AaronDoubert/quadcopter-pid-boards/README.md

# Quadcopter Flight Controller – Analog PID Boards

Analog PID flight controller for a 5" quadcopter: roll, pitch and yaw loops built from op-amps and
trimpots, fed by an MPU-6050 through a small ATtiny/DAC "shim", driving a 4in1 ESC. Designed in KiCad 10.

## PID_Board rev B: compact through-hole board for the 5" frame (latest)

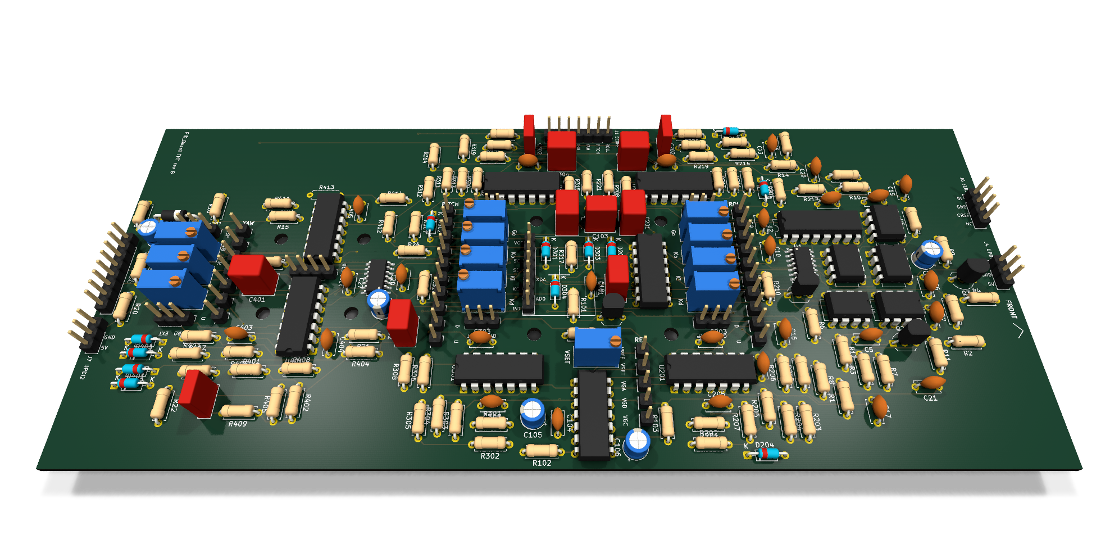
[picture p1: PID_Board/pcb_3d_render.png]
PID_Board rev B, 3D view


**90 x 210 mm, 4-layer, all through-hole except the two SOIC ATtinys.** It mounts straight onto the frame.

| | |
|---|---|
| Mounting | 30.5 x 30.5 stack holes + 20 x 20 ESC stack holes (M3); copper-free rings for the standoffs |
| ESC | 4in1 sits underneath the rear section on the 20x20 holes; harness to J5 |
| IMU | GY-521 on a header, MPU-6050 directly over the frame CG |
| Receiver | ELRS 2.4 GHz (for example RadioMaster RP1/RP2), CRSF on J6 at the front edge |
| Power | VBAT (2S–4S) from the ESC harness → 1N5817 → mini fixed-5 V buck module on U10 (3 wires; see MOUNTING.md) |
| Tuning | One labelled panel per axis: test points, LOOP/GYRO jumpers, Go/Kp/Ki/Kd trimpots, all prop-clear |
| Layers | Top/bottom signals, In1 GND plane, In2 +5 V plane |

<table>
<tr>
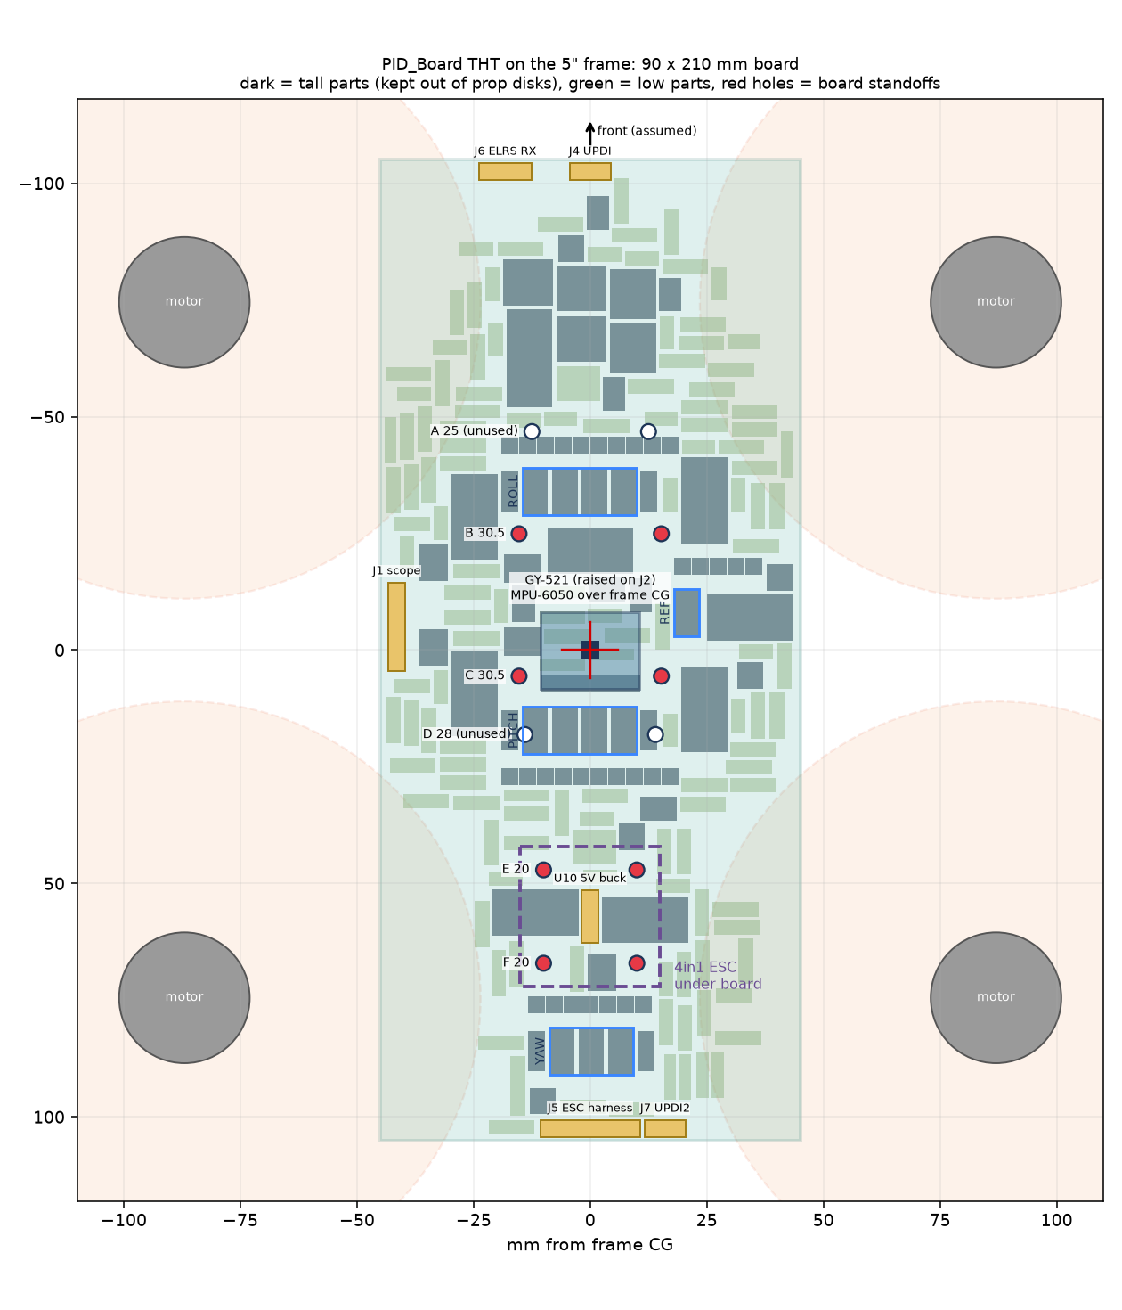
[picture p2: PID_Board/mounting_plan.png]
Board on the frame with 5-inch prop disks
<td></td>
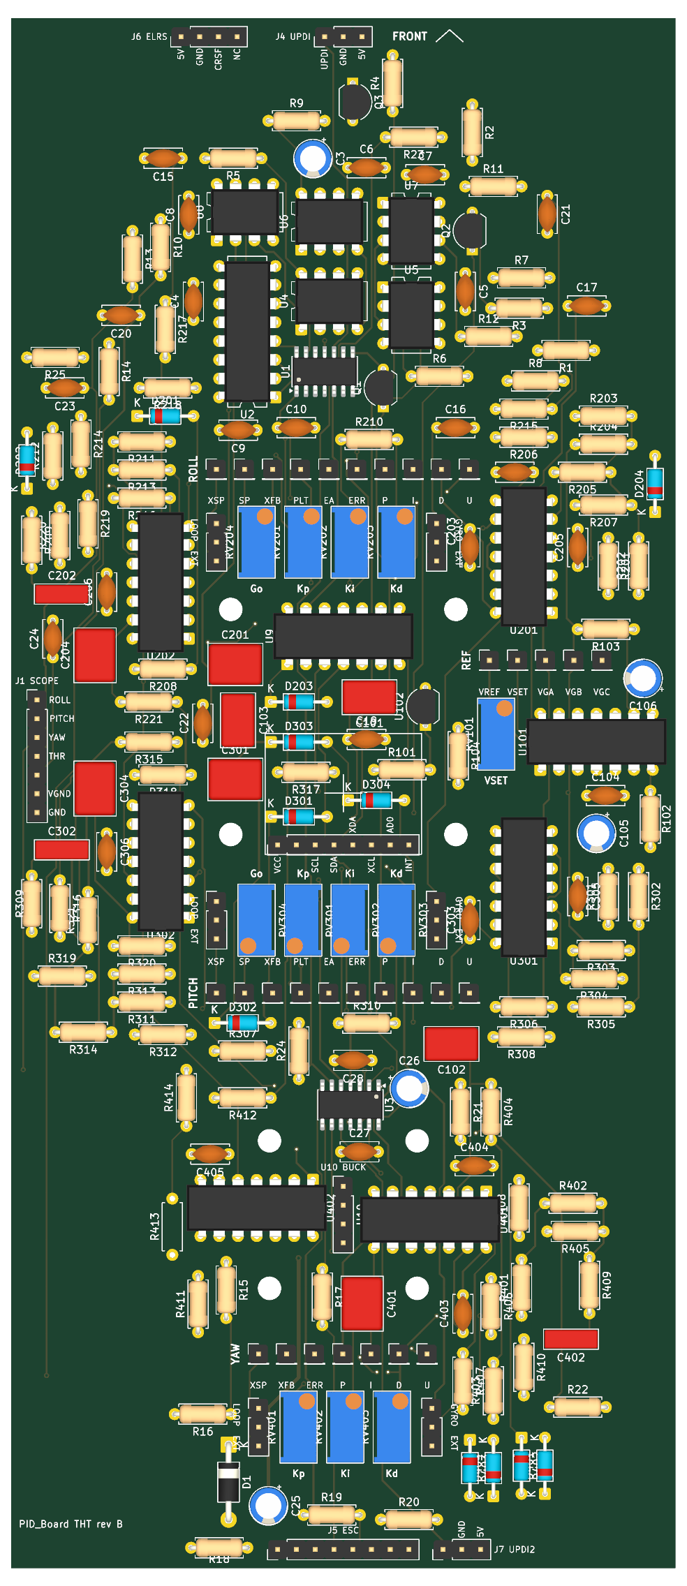
[picture p3: PID_Board/pcb_top_render.png]
Top render
<td></td>
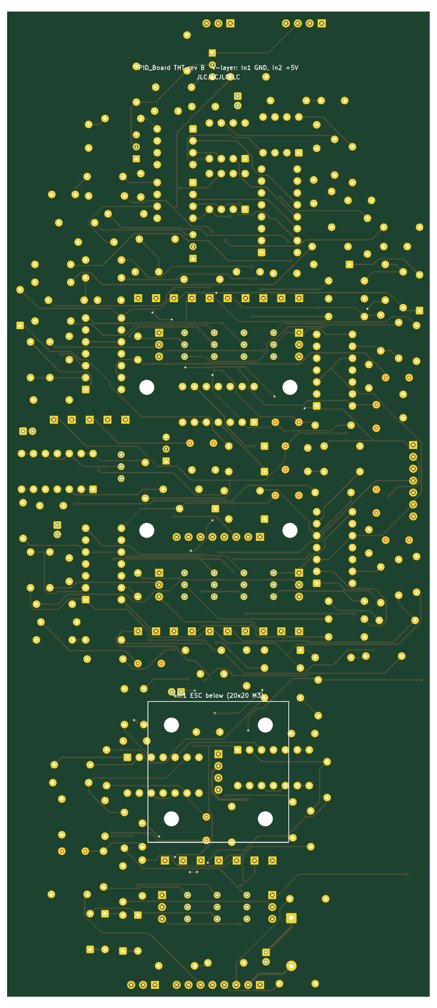
[picture p4: PID_Board/pcb_bottom_render.png]
Bottom render
<td></td>
</tr>
<tr><td>Board on the frame (dashed: 5" prop disks)</td><td>Top</td><td>Bottom</td></tr>
</table>

**Order / build files**
- **Gerbers (upload this zip to JLCPCB or PCBWay as a 4-layer board):** [`PID_Board_gerbers_drill.zip`](PID_Board/fab/JLC_PCBWay_THT/PID_Board_gerbers_drill.zip)
- **BOM and pick-and-place:** [`PID_Board/fab/JLC_PCBWay_THT/`](PID_Board/fab/JLC_PCBWay_THT/) (grouped BOM, CPL)
- **3D model:** [`PID_Board/cad/`](PID_Board/cad/) (STEP).
- [`PID_Board/MOUNTING.md`](PID_Board/MOUNTING.md): stack order, standoffs, where each module goes, what to measure before ordering.
- [`PID_Board/KNOWN_ISSUES.md`](PID_Board/KNOWN_ISSUES.md): things to check before first power-up.

## PID_Board_SMT: SMT, digital-pot version

100 x 100 mm 2-layer, assembly-ready at JLCPCB (LCSC part numbers), digital pots instead of trimpots.

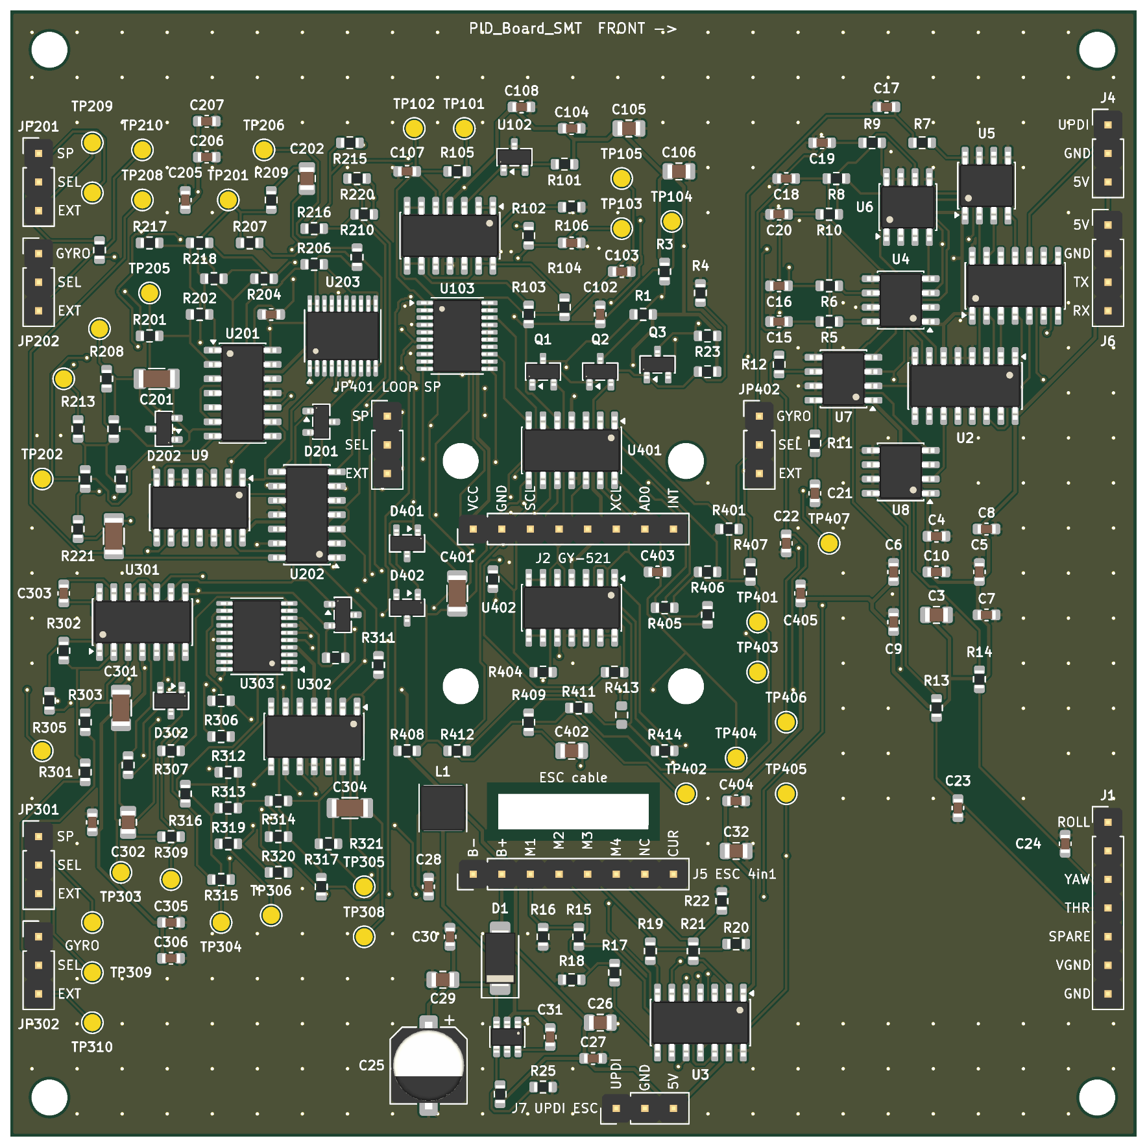
[picture p5: PID_Board_SMT/pcb_top_render.png]
SMT top
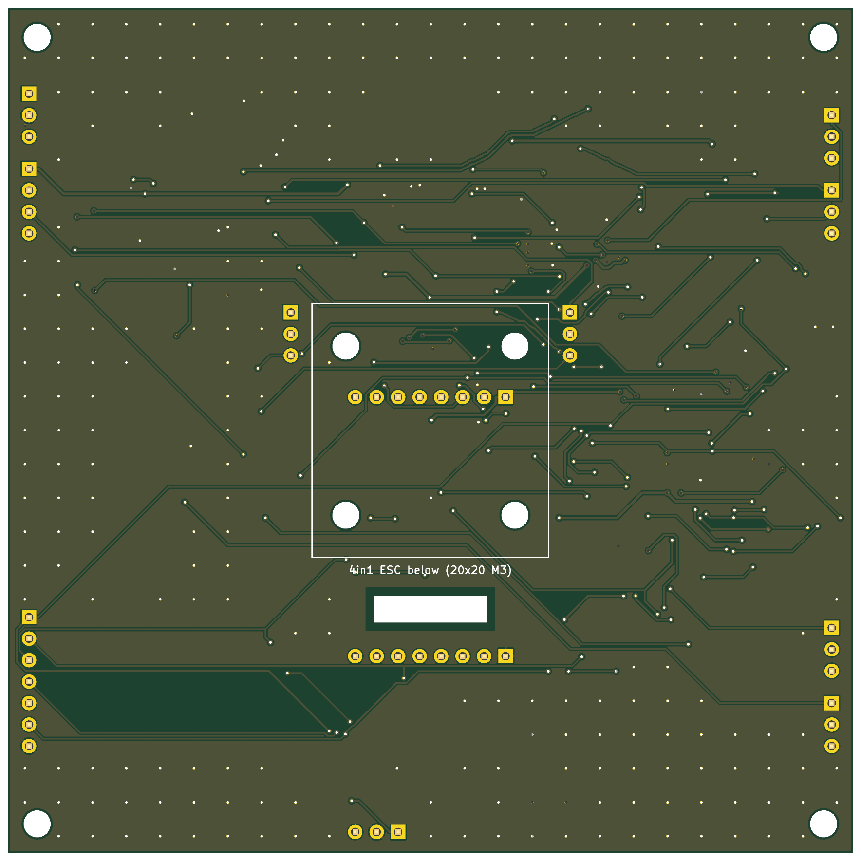
[picture p6: PID_Board_SMT/pcb_bottom_render.png]
SMT bottom
 

Files: `PID_Board_SMT/fab/` (Gerbers, BOM, CPL), `PID_Board_SMT/SMT_NOTES.md`, `PID_Board_SMT/scripts/`.

## Simulation: quad model + digital twin of the board

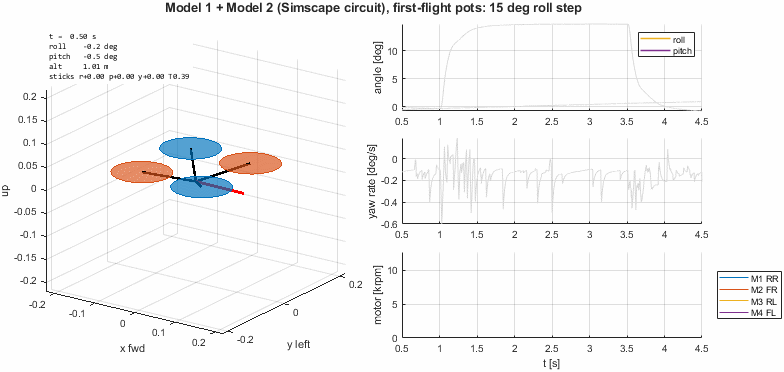
[picture p7: sim/docs/img/m2_circuit_roll_step.gif]
Simscape circuit model of the board flying the quad


[`sim/`](sim/README.md) holds two linked Simulink models (R2024b):
- **The quad:** 6-DOF 5" quad with 2207 1800KV motors, 5x4.3x3 props, a 4S battery with voltage sag, the ESC and the MPU-6050.
- **The board twin:** shim, all 5 analog loops, control_io. The analog section comes as either a fast behavioural model or a Simscape Electrical circuit model.

The board twin plugs into the quad's controller slot, or runs on a bench harness that mirrors the real board's test points.

**[First-flight trimpot settings](sim/gains/first_flight_gains.md)** are conservative values checked in the sim, with margin for inertia and delay errors. How they were chosen and a suggested first-flight procedure are in [`sim/gains/README.md`](sim/gains/README.md).

## Repository layout
| Path | What |
|---|---|
| `PID_Board/` | Through-hole board, rev B (current) |
| `PID_Board/old_versions/` | Earlier through-hole revisions (v1, rev A: 250 x 100 mm bench layout) |
| `PID_Board_SMT/` | SMT / digital-pot board |
| [`sim/`](sim/README.md) | Simulink quad model, board twin (fast + Simscape circuit), first-flight gains, docs |
| [`CHANGELOG.md`](CHANGELOG.md) | Version history |
