AaronDoubert/quadcopter-pid-boards/PID_Board/fab/JLC_PCBWay_THT/drc_report.txt

** Drc report for PID_Board.kicad_pcb **
** Created on 2026-10-25T20:38:37 **
** Report includes: Errors, Warnings, Exclusions **

** Found 222 DRC violations **
[silk_edge_clearance]: Silkscreen clipped by board edge
    Rule: board setup constraints silk; warning
    @(55.0000 mm, -5.0000 mm): Rectangle on Edge.Cuts
    @(55.3500 mm, 58.7375 mm): Footprint text of D202 (K)
[silk_overlap]: Silkscreen clearance
    Rule: board setup constraints silk; warning
    @(77.8975 mm, 100.3125 mm): Segment of U302 on F.Silkscreen
    @(75.5650 mm, 99.8850 mm): Reference field of R318
[silk_overlap]: Silkscreen clearance
    Rule: board setup constraints silk; warning
    @(84.2400 mm, 130.0075 mm): Rectangle of D302 on F.Silkscreen
    @(86.3600 mm, 132.5675 mm): Reference field of R307
[silk_overlap]: Silkscreen clearance
    Rule: board setup constraints silk; warning
    @(85.2300 mm, 128.4800 mm): Segment of TP307 on F.Silkscreen
    @(86.3600 mm, 129.0075 mm): Reference field of D302
[silk_overlap]: Silkscreen clearance
    Rule: board setup constraints silk; warning
    @(86.3600 mm, 129.0075 mm): Reference field of D302
    @(87.9900 mm, 128.3700 mm): Segment of TP307 on F.Silkscreen
[silk_overlap]: Silkscreen clearance
    Rule: board setup constraints silk; warning
    @(85.2300 mm, 128.3700 mm): Segment of TP307 on F.Silkscreen
    @(86.3600 mm, 129.0075 mm): Reference field of D302
[silk_overlap]: Silkscreen clearance
    Rule: board setup constraints silk; warning
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
    @(109.5375 mm, 13.4825 mm): Reference field of R23
[silk_overlap]: Silkscreen clearance
    Rule: board setup constraints silk; warning
    @(127.0950 mm, 35.6600 mm): Segment of R3 on F.Silkscreen
    @(119.6975 mm, 35.7300 mm): Reference field of R12
[silk_overlap]: Silkscreen clearance
    Rule: board setup constraints silk; warning
    @(126.9050 mm, 41.3750 mm): Segment of R1 on F.Silkscreen
    @(126.0475 mm, 41.7625 mm): Reference field of R8
[silk_over_copper]: Silkscreen clipped by solder mask
    Local override; warning
    @(79.8000 mm, 117.2000 mm): PCB text 'LOOP  EXT' on F.Silkscreen
    @(79.0575 mm, 116.8825 mm): PTH pad 1 [U_PITCH] of U302
[silk_over_copper]: Silkscreen clipped by solder mask
    Local override; warning
    @(79.8000 mm, 117.2000 mm): PCB text 'LOOP  EXT' on F.Silkscreen
    @(79.0575 mm, 114.3425 mm): PTH pad 2 [Net-(U302A--)] of U302
[silk_over_copper]: Silkscreen clipped by solder mask
    Local override; warning
    @(70.4450 mm, 107.9525 mm): Reference field of C306
    @(71.4375 mm, 106.7225 mm): PTH pad 10 [VGND_A] of U302
[silk_over_copper]: Silkscreen clipped by solder mask
    Local override; warning
    @(70.4450 mm, 107.9525 mm): Reference field of C306
    @(71.4375 mm, 109.2625 mm): PTH pad 11 [GND] of U302
[silk_over_copper]: Silkscreen clipped by solder mask
    Local override; warning
    @(85.5000 mm, 185.9000 mm): PCB text 'LOOP  EXT' on F.Silkscreen
    @(84.7725 mm, 184.1500 mm): PTH pad 1 [/Control_IO/M1_ESC] of R16
[silk_over_copper]: Silkscreen clipped by solder mask
    Local override; warning
    @(85.5000 mm, 185.9000 mm): PCB text 'LOOP  EXT' on F.Silkscreen
    @(84.4550 mm, 188.2775 mm): PTH pad 1 [Net-(D1-K)] of D1
[silk_over_copper]: Silkscreen clipped by solder mask
    Local override; warning
    @(102.1950 mm, 146.0900 mm): Reference field of C27
    @(102.2350 mm, 144.7150 mm): Pad 12 [U_PITCH] of U3 on F.Cu
[silk_over_copper]: Silkscreen clipped by solder mask
    Local override; warning
    @(102.1950 mm, 146.0900 mm): Reference field of C27
    @(103.5050 mm, 144.7150 mm): Pad 13 [U_YAW] of U3 on F.Cu
[silk_over_copper]: Silkscreen clipped by solder mask
    Local override; warning
    @(101.3225 mm, 138.7075 mm): Reference field of C28
    @(102.2350 mm, 139.7650 mm): Pad 3 [unconnected-(U3-PA5-Pad3)] of U3 on F.Cu
[silk_over_copper]: Silkscreen clipped by solder mask
    Local override; warning
    @(102.1950 mm, 146.0900 mm): Reference field of C27
    @(100.9650 mm, 144.7150 mm): Pad 11 [U_ROLL] of U3 on F.Cu
[silk_over_copper]: Silkscreen clipped by solder mask
    Local override; warning
    @(101.3225 mm, 138.7075 mm): Reference field of C28
    @(100.9650 mm, 139.7650 mm): Pad 4 [THROTTLE] of U3 on F.Cu
[silk_over_copper]: Silkscreen clipped by solder mask
    Local override; warning
    @(131.4450 mm, 161.7550 mm): Reference field of R405
    @(133.3500 mm, 162.8775 mm): PTH pad 1 [/PID_Yaw/E_YR] of R409
[silk_over_copper]: Silkscreen clipped by solder mask
    Local override; warning
    @(81.9550 mm, 151.4075 mm): Reference field of C405
    @(80.6450 mm, 152.4000 mm): PTH pad 7 [Net-(U402B--)] of U402
[silk_over_copper]: Silkscreen clipped by solder mask
    Local override; warning
    @(81.9550 mm, 151.4075 mm): Reference field of C405
    @(83.1850 mm, 152.4000 mm): PTH pad 6 [Net-(U402B--)] of U402
[silk_over_copper]: Silkscreen clipped by solder mask
    Local override; warning
    @(117.7525 mm, 147.9950 mm): Reference field of C404
    @(115.8875 mm, 147.0025 mm): PTH pad 2 [/Control_IO/M4_ESC] of R21
[silk_over_copper]: Silkscreen clipped by solder mask
    Local override; warning
    @(89.4000 mm, 108.3000 mm): Segment on F.Silkscreen
    @(90.1700 mm, 103.1875 mm): PTH pad 1 [Net-(D301-K)] of D301
[silk_over_copper]: Silkscreen clipped by solder mask
    Local override; warning
    @(89.4000 mm, 108.3000 mm): Segment on F.Silkscreen
    @(90.1700 mm, 93.0700 mm): PTH pad 1 [Net-(D301-A)] of D303
[silk_over_copper]: Silkscreen clipped by solder mask
    Local override; warning
    @(100.0000 mm, 97.5000 mm): Segment on F.Silkscreen
    @(100.6475 mm, 100.9650 mm): PTH pad 1 [Net-(D303-A)] of D304
[silk_over_copper]: Silkscreen clipped by solder mask
    Local override; warning
    @(93.6025 mm, 196.5800 mm): Reference field of C25
    @(94.6150 mm, 197.8025 mm): PTH pad 1 [/Control_IO/M3_PWM] of R19
[silk_over_copper]: Silkscreen clipped by solder mask
    Local override; warning
    @(125.5175 mm, 194.9450 mm): Footprint text of D401 (K)
    @(124.1425 mm, 194.9450 mm): PTH pad 2 [Net-(D401-K)] of D402
[silk_over_copper]: Silkscreen clipped by solder mask
    Local override; warning
    @(118.5325 mm, 195.2625 mm): Footprint text of D404 (K)
    @(117.1575 mm, 195.2625 mm): PTH pad 2 [Net-(D403-A)] of D403
[silk_over_copper]: Silkscreen clipped by solder mask
    Local override; warning
    @(115.0200 mm, 185.9000 mm): PCB text 'GYRO  EXT' on F.Silkscreen
    @(116.2050 mm, 183.5150 mm): PTH pad 2 [Net-(R407-Pad2)] of R407
[silk_over_copper]: Silkscreen clipped by solder mask
    Local override; warning
    @(76.5575 mm, 21.6300 mm): Reference field of C8
    @(75.2475 mm, 22.2250 mm): PTH pad 1 [Net-(U6-VB)] of R10
[silk_over_copper]: Silkscreen clipped by solder mask
    Local override; warning
    @(113.9150 mm, 23.8125 mm): Reference field of Q2
    @(113.0300 mm, 25.0825 mm): PTH pad 6 [Net-(U7-VB)] of U7
[silk_over_copper]: Silkscreen clipped by solder mask
    Local override; warning
    @(113.9150 mm, 23.8125 mm): Reference field of Q2
    @(113.0300 mm, 22.5425 mm): PTH pad 7 [GND] of U7
[silk_over_copper]: Silkscreen clipped by solder mask
    Local override; warning
    @(77.1925 mm, 33.3775 mm): Reference field of C4
    @(75.8825 mm, 33.3375 mm): PTH pad 1 [ROLL_ANGLE] of R217
[silk_over_copper]: Silkscreen clipped by solder mask
    Local override; warning
    @(91.9675 mm, 33.3375 mm): Reference field of U4
    @(90.8050 mm, 33.6550 mm): PTH pad 6 [+5V] of U2
[silk_over_copper]: Silkscreen clipped by solder mask
    Local override; warning
    @(85.0900 mm, 16.3400 mm): Reference field of R5
    @(85.4075 mm, 17.4625 mm): PTH pad 7 [GND] of U8
[silk_over_copper]: Silkscreen clipped by solder mask
    Local override; warning
    @(92.1925 mm, 42.8625 mm): Reference field of U1
    @(90.8050 mm, 43.8150 mm): PTH pad 2 [/CS_A1] of U2
[silk_over_copper]: Silkscreen clipped by solder mask
    Local override; warning
    @(101.8500 mm, 45.0850 mm): Reference field of Q1
    @(101.2825 mm, 45.3375 mm): Pad 7 [unconnected-(U1-PB2-Pad7)] of U1 on F.Cu
[silk_over_copper]: Silkscreen clipped by solder mask
    Local override; warning
    @(135.5325 mm, 97.8300 mm): Reference field of C104
    @(134.3025 mm, 96.8375 mm): PTH pad 4 [+5V] of U101
[silk_over_copper]: Silkscreen clipped by solder mask
    Local override; warning
    @(135.5325 mm, 97.8300 mm): Reference field of C104
    @(136.8425 mm, 96.8375 mm): PTH pad 5 [/PID_Reference/VSET] of U101
[silk_over_copper]: Silkscreen clipped by solder mask
    Local override; warning
    @(129.2625 mm, 66.7150 mm): Reference field of C205
    @(128.2700 mm, 67.9450 mm): PTH pad 4 [+5V] of U201
[silk_over_copper]: Silkscreen clipped by solder mask
    Local override; warning
    @(129.2625 mm, 66.7150 mm): Reference field of C205
    @(128.2700 mm, 65.4050 mm): PTH pad 5 [VGND_A] of U201
[silk_over_copper]: Silkscreen clipped by solder mask
    Local override; warning
    @(140.6050 mm, 88.2050 mm): Reference field of C106
    @(139.3825 mm, 89.2175 mm): PTH pad 9 [Net-(U101C--)] of U101
[silk_over_copper]: Silkscreen clipped by solder mask
    Local override; warning
    @(140.6050 mm, 88.2050 mm): Reference field of C106
    @(141.9225 mm, 89.2175 mm): PTH pad 8 [Net-(U101C--)] of U101
[silk_over_copper]: Silkscreen clipped by solder mask
    Local override; warning
    @(89.4000 mm, 91.9000 mm): Segment on F.Silkscreen
    @(100.6475 mm, 92.7100 mm): PTH pad 1 [YAW_RATE] of C19
[silk_over_copper]: Silkscreen clipped by solder mask
    Local override; warning
    @(89.4000 mm, 91.9000 mm): Segment on F.Silkscreen
    @(105.6475 mm, 92.7100 mm): PTH pad 2 [GND] of C19
[silk_over_copper]: Silkscreen clipped by solder mask
    Local override; warning
    @(89.2250 mm, 90.1300 mm): Reference field of C103
    @(90.1700 mm, 87.6300 mm): PTH pad 1 [Net-(D201-A)] of D203
[silk_over_copper]: Silkscreen clipped by solder mask
    Local override; warning
    @(79.8000 mm, 66.0000 mm): PCB text 'LOOP  EXT' on F.Silkscreen
    @(79.0575 mm, 63.8175 mm): PTH pad 7 [/PID_Roll/E_A] of U202
[silk_over_copper]: Silkscreen clipped by solder mask
    Local override; warning
    @(79.8000 mm, 66.0000 mm): PCB text 'LOOP  EXT' on F.Silkscreen
    @(79.0575 mm, 68.8975 mm): PTH pad 5 [Net-(U202B-+)] of U202
[silk_over_copper]: Silkscreen clipped by solder mask
    Local override; warning
    @(65.4450 mm, 72.7475 mm): Reference field of C206
    @(64.3725 mm, 73.0250 mm): PTH pad 2 [Net-(U201D--)] of C202
[silk_over_copper]: Silkscreen clipped by solder mask
    Local override; warning
    @(99.6350 mm, 14.0175 mm): Reference field of C3
    @(100.6475 mm, 15.2400 mm): PTH pad 1 [+5V] of C6
[silk_over_copper]: Silkscreen clipped by solder mask
    Local override; warning
    @(100.0000 mm, 6.9500 mm): PCB text 'PID_Board THT rev B  4-layer: In1 GND, In2 +5V' on B.Silkscreen
    @(117.4750 mm, 6.6675 mm): PTH pad 1 [+5V] of R2
[silk_over_copper]: Silkscreen clipped by solder mask
    Local override; warning
    @(100.0000 mm, 6.9500 mm): PCB text 'PID_Board THT rev B  4-layer: In1 GND, In2 +5V' on B.Silkscreen
    @(106.6800 mm, 7.6200 mm): PTH pad 1 [/GATE_BIAS] of R4
[silk_over_copper]: Silkscreen clipped by solder mask
    Local override; warning
    @(100.0000 mm, 6.9500 mm): PCB text 'PID_Board THT rev B  4-layer: In1 GND, In2 +5V' on B.Silkscreen
    @(101.2825 mm, 6.3500 mm): PTH pad 2 [/GATE_BIAS] of Q3
[silk_over_copper]: Silkscreen clipped by solder mask
    Local override; warning
    @(85.0000 mm, 142.1000 mm): Segment on B.Silkscreen
    @(90.1700 mm, 141.2875 mm): PTH pad 1 [/PID_Yaw/I_OUT] of R412
[silk_over_copper]: Silkscreen clipped by solder mask
    Local override; warning
    @(85.0000 mm, 172.1000 mm): Segment on B.Silkscreen
    @(84.1375 mm, 163.5125 mm): PTH pad 1 [/Control_IO/M1_PWM] of R15
[silk_over_copper]: Silkscreen clipped by solder mask
    Local override; warning
    @(85.0000 mm, 172.1000 mm): Segment on B.Silkscreen
    @(85.7250 mm, 160.0200 mm): PTH pad 10 [VGND_C] of U402
[silk_over_copper]: Silkscreen clipped by solder mask
    Local override; warning
    @(85.0000 mm, 172.1000 mm): Segment on B.Silkscreen
    @(84.1375 mm, 171.1325 mm): PTH pad 2 [/Control_IO/M1_ESC] of R15
[silk_over_copper]: Silkscreen clipped by solder mask
    Local override; warning
    @(85.0000 mm, 172.1000 mm): Segment on B.Silkscreen
    @(84.4550 mm, 148.9075 mm): PTH pad 1 [+5V] of C405
[silk_over_copper]: Silkscreen clipped by solder mask
    Local override; warning
    @(85.0000 mm, 172.1000 mm): Segment on B.Silkscreen
    @(85.7250 mm, 152.4000 mm): PTH pad 5 [VGND_C] of U402
[silk_over_copper]: Silkscreen clipped by solder mask
    Local override; warning
    @(115.0000 mm, 142.1000 mm): Segment on B.Silkscreen
    @(114.3000 mm, 153.9875 mm): PTH pad 3 [Net-(U401A-+)] of U401
[silk_over_copper]: Silkscreen clipped by solder mask
    Local override; warning
    @(115.0000 mm, 142.1000 mm): Segment on B.Silkscreen
    @(114.3000 mm, 161.6075 mm): PTH pad 12 [VGND_B] of U401
[silk_over_copper]: Silkscreen clipped by solder mask
    Local override; warning
    @(115.0000 mm, 142.1000 mm): Segment on B.Silkscreen
    @(115.2525 mm, 150.4950 mm): PTH pad 1 [+5V] of C404
[silk_over_copper]: Silkscreen clipped by solder mask
    Local override; warning
    @(115.0000 mm, 172.1000 mm): Segment on B.Silkscreen
    @(102.5525 mm, 171.6875 mm): PTH pad 2 [/PID_Yaw/I_OUT] of C401
[silk_over_copper]: Silkscreen clipped by solder mask
    Local override; warning
    @(115.0000 mm, 172.1000 mm): Segment on B.Silkscreen
    @(97.1550 mm, 172.0850 mm): PTH pad 2 [/Control_IO/M2_ESC] of R17
[silk_over_copper]: Silkscreen clipped by solder mask
    Local override; warning
    @(100.0000 mm, 140.8000 mm): PCB text '4in1 ESC below (20x20 M3)' on B.Silkscreen
    @(107.9500 mm, 140.0175 mm): PTH pad 1 [+5V] of C26
[silk_over_copper]: Silkscreen clipped by solder mask
    Local override; warning
    @(100.0000 mm, 140.8000 mm): PCB text '4in1 ESC below (20x20 M3)' on B.Silkscreen
    @(90.1700 mm, 141.2875 mm): PTH pad 1 [/PID_Yaw/I_OUT] of R412
[silk_over_copper]: Silkscreen clipped by solder mask
    Local override; warning
    @(100.0000 mm, 140.8000 mm): PCB text '4in1 ESC below (20x20 M3)' on B.Silkscreen
    @(109.9500 mm, 140.0175 mm): PTH pad 2 [GND] of C26
[silk_over_copper]: Silkscreen clipped by solder mask
    Local override; warning
    @(100.0000 mm, 8.9500 mm): PCB text 'JLCJLCJLCJLC' on B.Silkscreen
    @(97.4725 mm, 8.8900 mm): PTH pad 2 [YAW_RATE] of R9
[silk_over_copper]: Silkscreen clipped by solder mask
    Local override; warning
    @(100.0000 mm, 8.9500 mm): PCB text 'JLCJLCJLCJLC' on B.Silkscreen
    @(101.2825 mm, 8.8900 mm): PTH pad 3 [/CRSF_5V] of Q3

** Found 0 unconnected pads **

** Found 0 Footprint errors **

** Ignored checks **
    - Footprint has no courtyard defined
    - Track endpoint not centered on via
    - Tuning profile track geometries
    - Footprint doesn't match symbol's footprint filters
    - Footprint component type doesn't match footprint pads

** End of Report **
