AaronDoubert/quadcopter-pid-boards/sim/gains/first_flight_gains.md

# First-flight gains (conservative)

Generated by `sim/gains/first_flight_gains.m` on 2026-11-01. Rate loops: PM >= 55 deg, GM >= 10 dB nominal; PM >= 35 deg / GM >= 6 dB with inertia x1.7 and x0.7 and +2 ms delay. Pots kept within 10-90 % of travel.

## Trimpot settings

| Axis | Pot | Set to | Travel | Turns from 0 Ω end | Board gain |
|---|---|---|---|---|---|
| roll | RV201 (Kp) | 20.0 kΩ | 20 % | 5.0 | Kp = 0.53 |
| | RV202 (Ki) | 80.0 kΩ | 80 % | 20.0 | Ki = 8.8 /s |
| | RV203 (Kd) | 90.0 kΩ | 90 % | 22.5 | Kd = 13.7 ms |
| | RV204 (Go) | 23.8 kΩ | 48 % | 11.9 | Go = 1.69 |
| pitch | RV301 (Kp) | 20.0 kΩ | 20 % | 5.0 | Kp = 0.53 |
| | RV302 (Ki) | 80.0 kΩ | 80 % | 20.0 | Ki = 8.8 /s |
| | RV303 (Kd) | 90.0 kΩ | 90 % | 22.5 | Kd = 13.7 ms |
| | RV304 (Go) | 22.5 kΩ | 45 % | 11.3 | Go = 1.63 |
| yaw | RV401 (Kp) | 70.0 kΩ | 70 % | 17.5 | Kp = 1.59 |
| | RV402 (Ki) | 20.0 kΩ | 20 % | 5.0 | Ki = 28.6 /s |
| | RV403 (Kd) | not summed on yaw (R413 DNP) | | | |

Mixer scale for the control_io firmware (`pcb.ctrl.K_rpy`, us of ESC pulse per volt of U): roll 150, pitch 200, yaw 200 us/V.

## What that means as an ideal PID

| Axis | Ka (1/s) | Kp us/(rad/s) | Ki us/rad | Kd us/(rad/s²) | I clamp us | rate wc rad/s | PM | GM dB | PM J×1.7 | PM J×0.7 | PM +2 ms | angle PM |
|---|---|---|---|---|---|---|---|---|---|---|---|---|
| roll | 6.7 | 24.6 | 415 | 0.64 | 112 | 36 | 60° | 10.3 | 47° | 55° | 55° | 87° |
| pitch | 6.5 | 32.8 | 553 | 0.86 | 150 | 36 | 58° | 10.4 | 45° | 54° | 54° | 88° |
| yaw | 0.0 | 99.3 | 1786 | 0.00 | 150 | 62 | 77° | 10.1 | 92° | 59° | 70° | - |

Turns assume a linear 25-turn 3296W measured from the end that gives 0 Ω in circuit; check each pot with a meter (power off) before the first flight rather than counting turns.
