AaronDoubert/quadcopter-pid-boards/sim/docs/img/m1_airframe.png

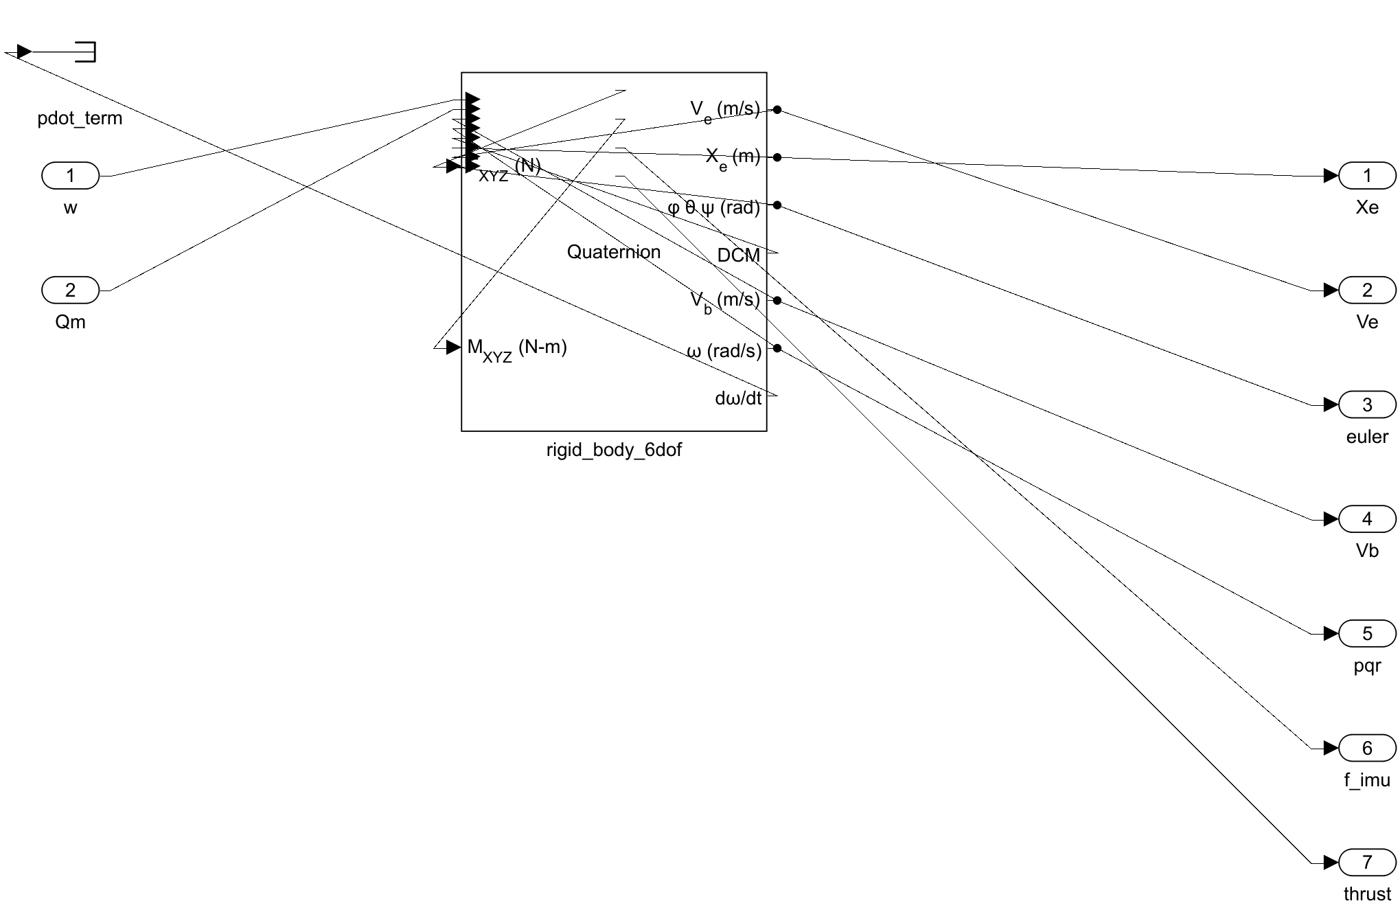
sim/docs/img/m1_airframe.png
