AaronDoubert/quadcopter-pid-boards/sim/docs/img/m1_controller_slot.png

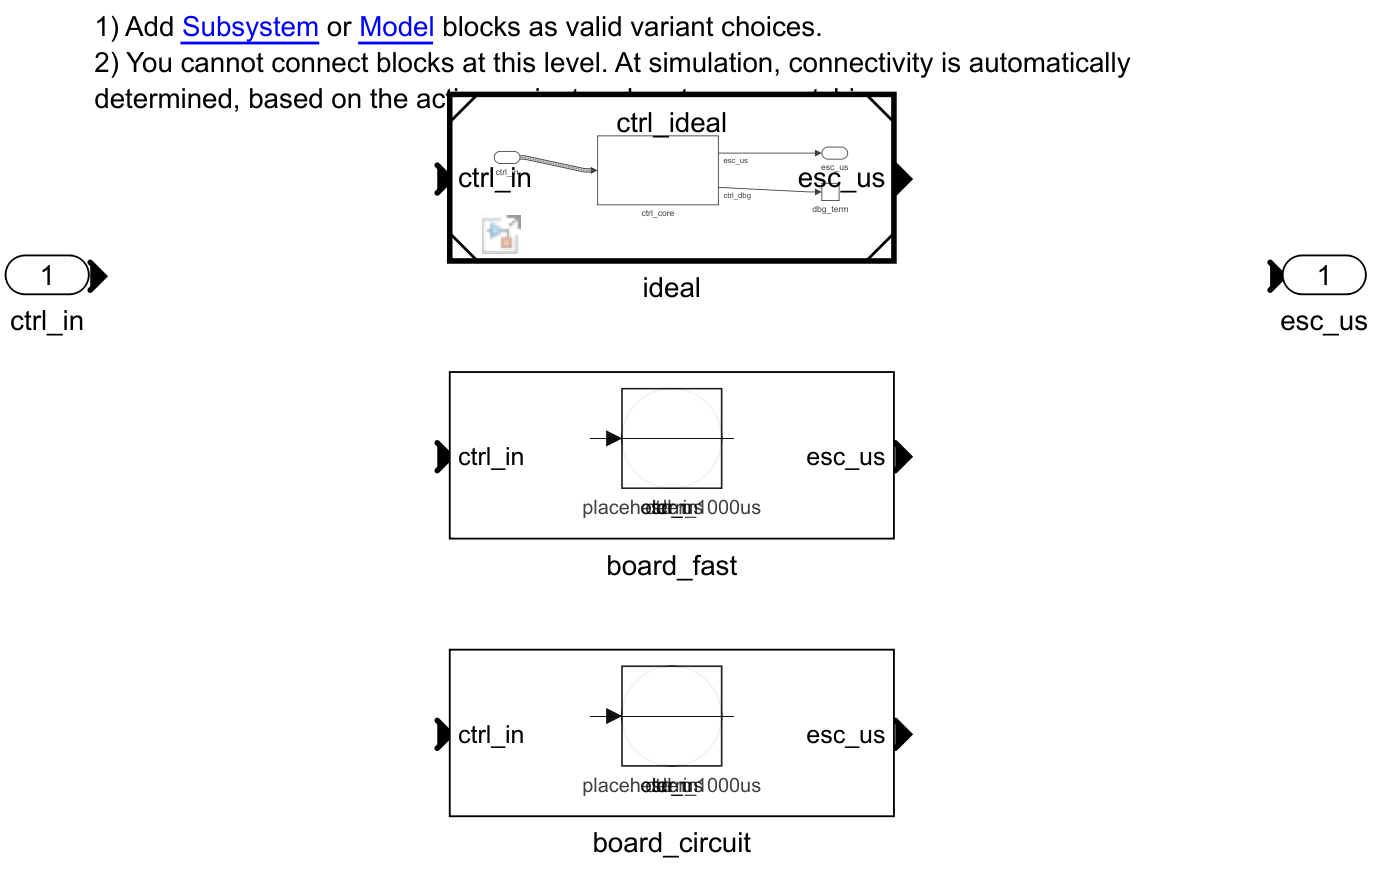
sim/docs/img/m1_controller_slot.png
