AaronDoubert/quadcopter-pid-boards/sim/docs/img/m1_ctrl_ideal_top.png

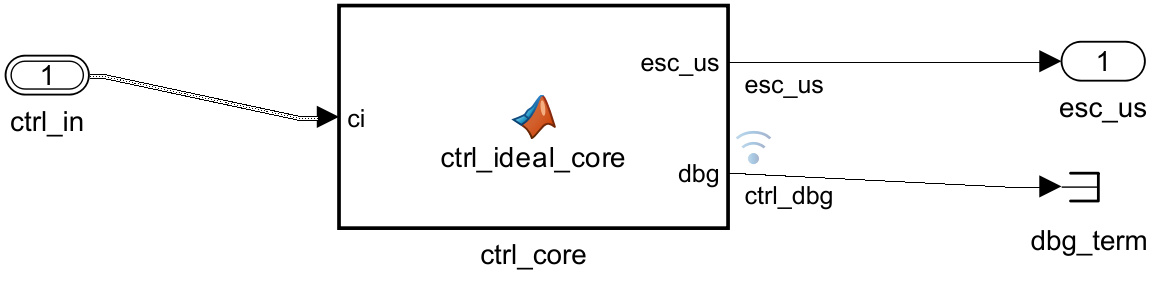
sim/docs/img/m1_ctrl_ideal_top.png
