AaronDoubert/quadcopter-pid-boards/sim/docs/img/m1_imu.png

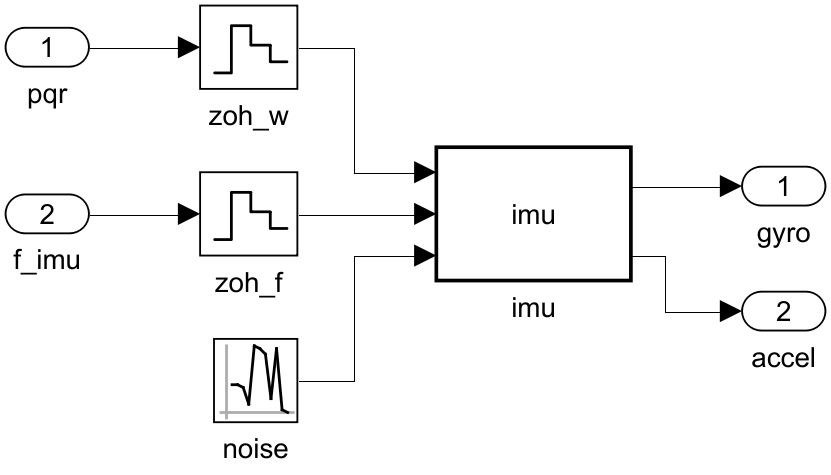
sim/docs/img/m1_imu.png
