AaronDoubert/quadcopter-pid-boards/sim/docs/img/m1_motors_battery.png

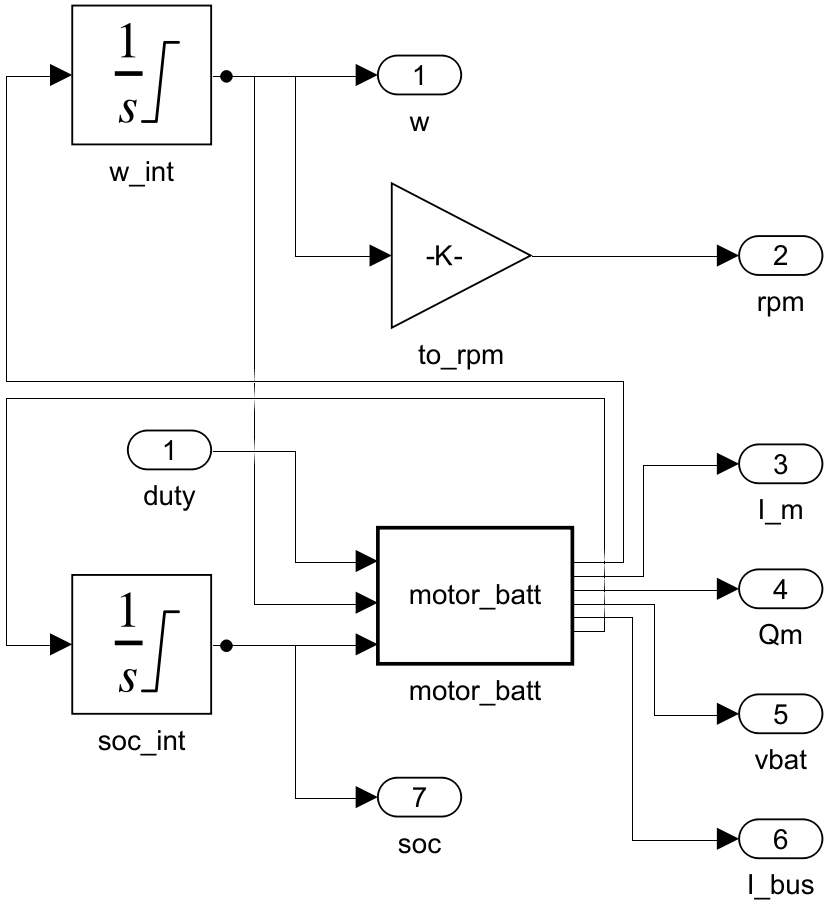
sim/docs/img/m1_motors_battery.png
