AaronDoubert/quadcopter-pid-boards/sim/docs/img/m2_bench.png

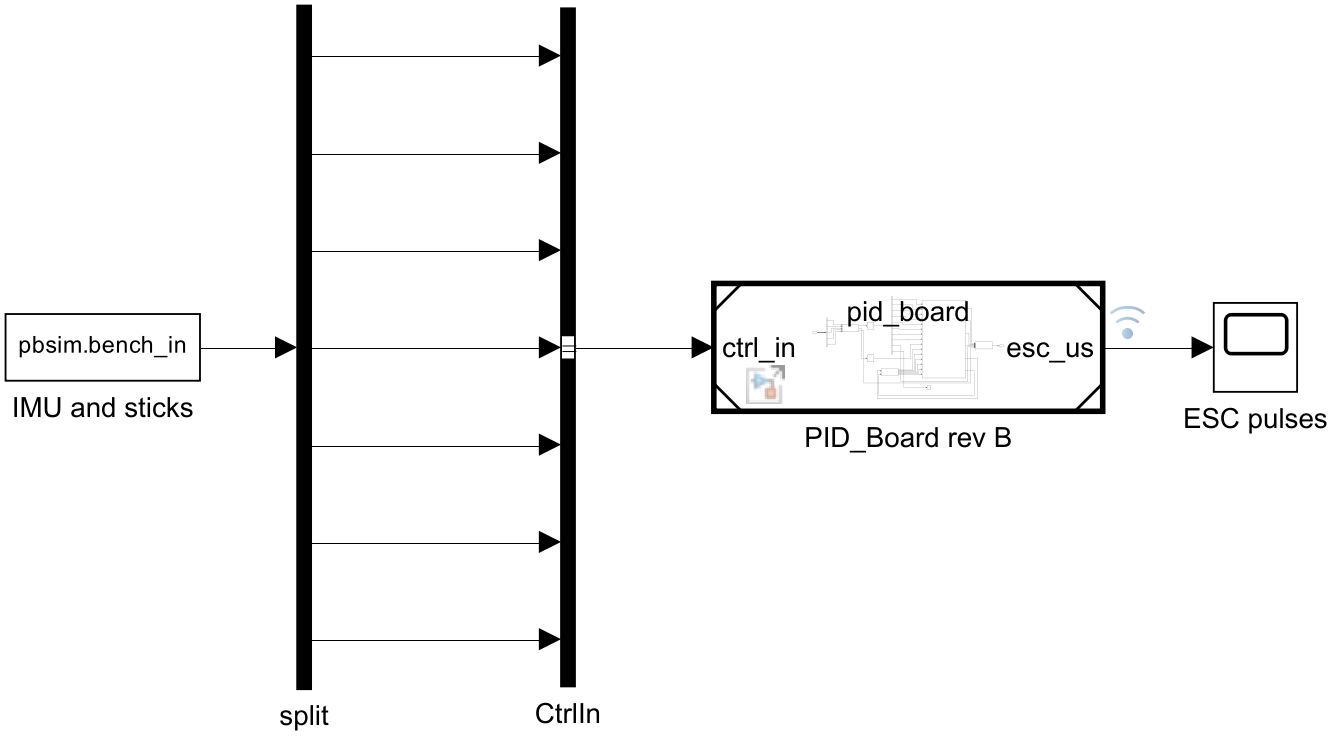
sim/docs/img/m2_bench.png
