AaronDoubert/quadcopter-pid-boards/sim/docs/img/m2_control_io.png

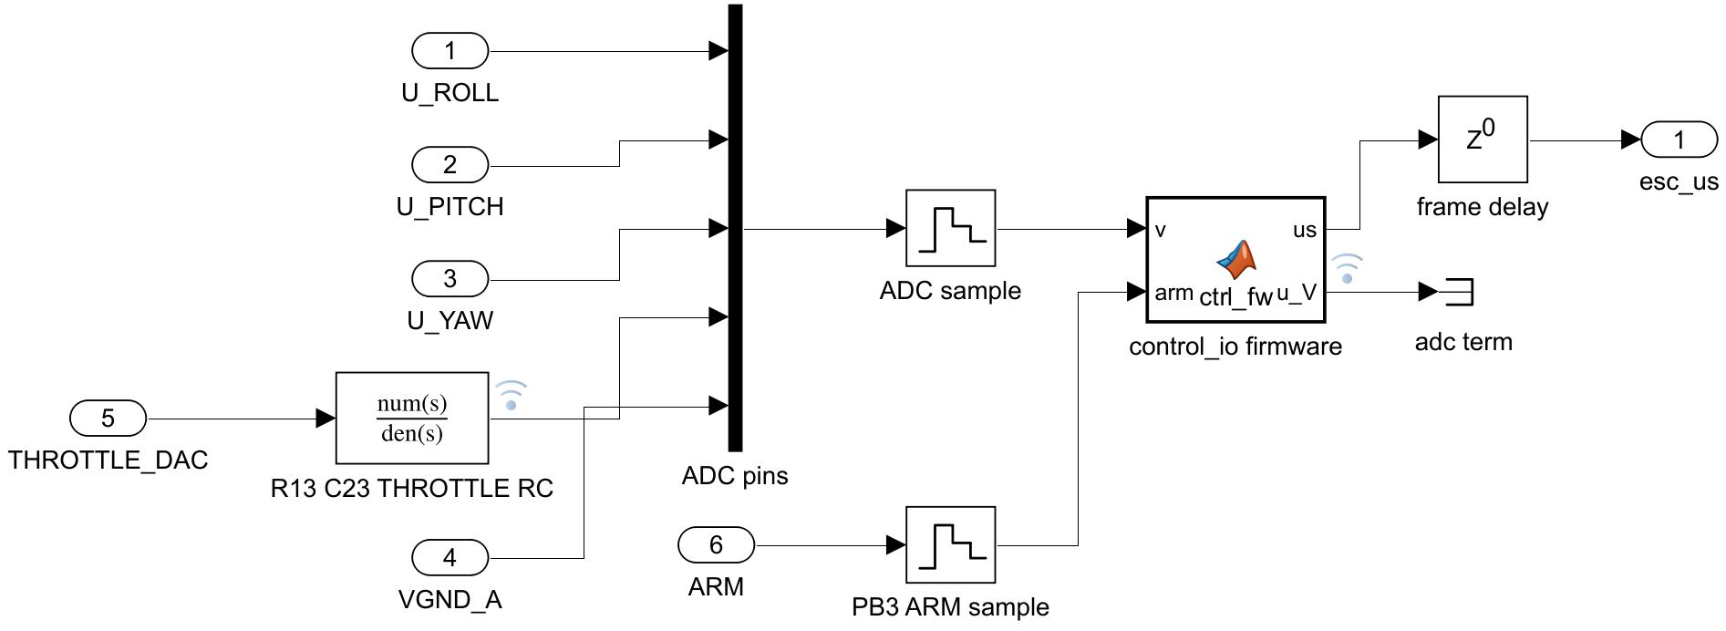
sim/docs/img/m2_control_io.png
