AaronDoubert/quadcopter-pid-boards/sim/docs/img/m2_shim.png

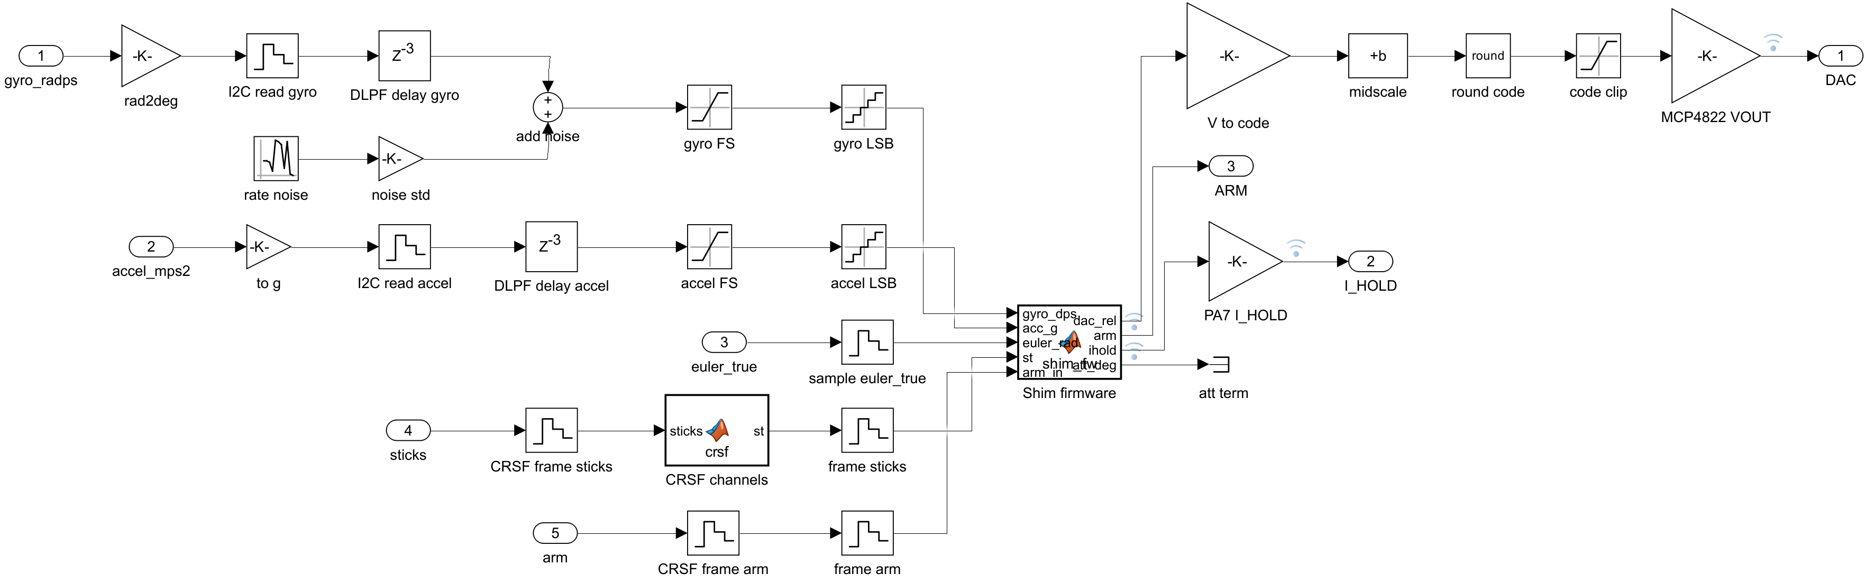
sim/docs/img/m2_shim.png
