AaronDoubert/quadcopter-pid-boards/sim/docs/img/m2c_circuit_top.png

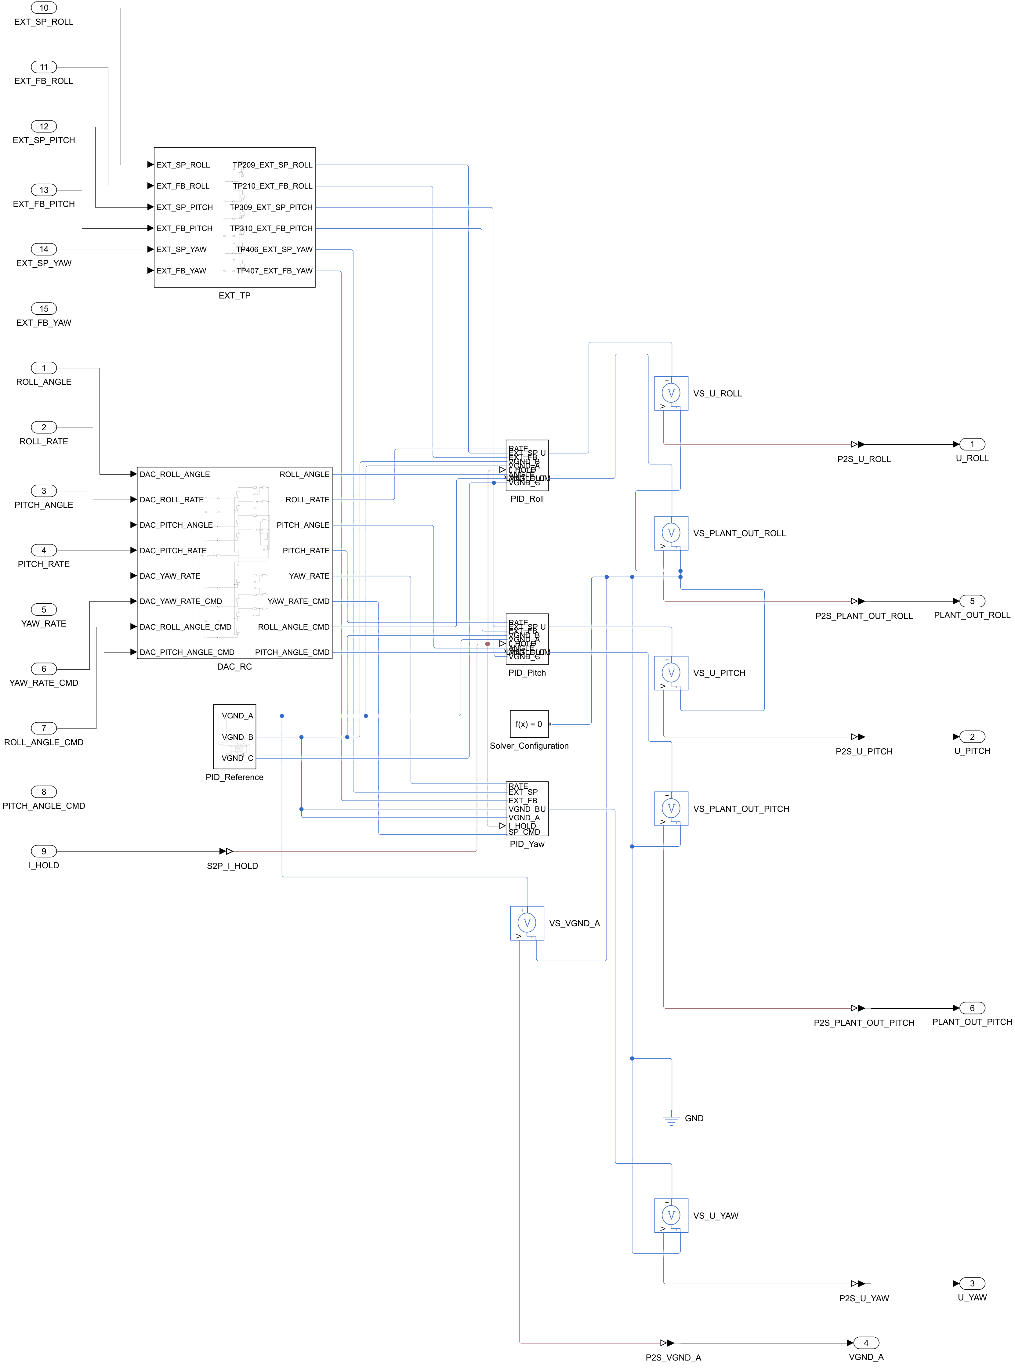
sim/docs/img/m2c_circuit_top.png
