AaronDoubert/quadcopter-pid-boards/sim/docs/img/m2c_dac_rc.png

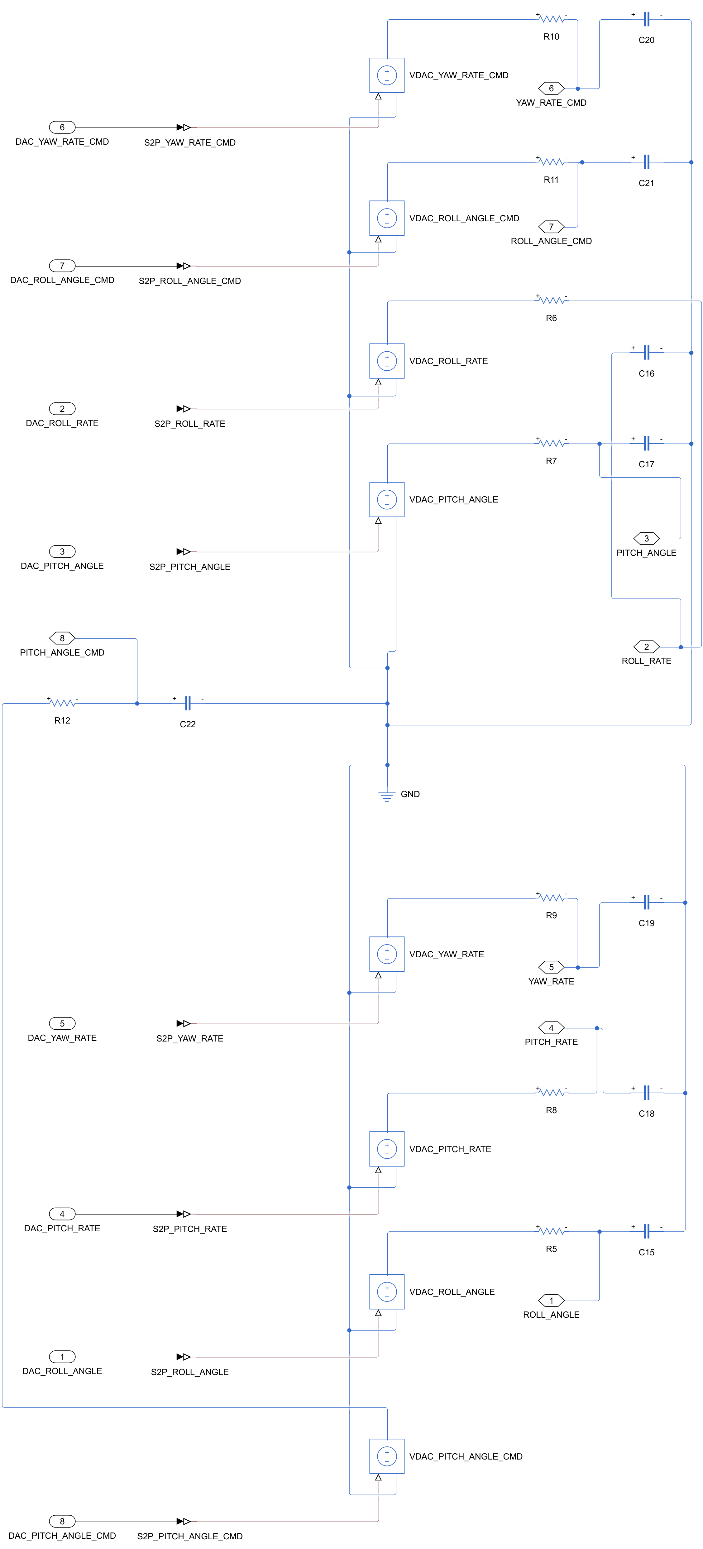
sim/docs/img/m2c_dac_rc.png
