AaronDoubert/quadcopter-pid-boards/sim/docs/img/m2c_reference.png

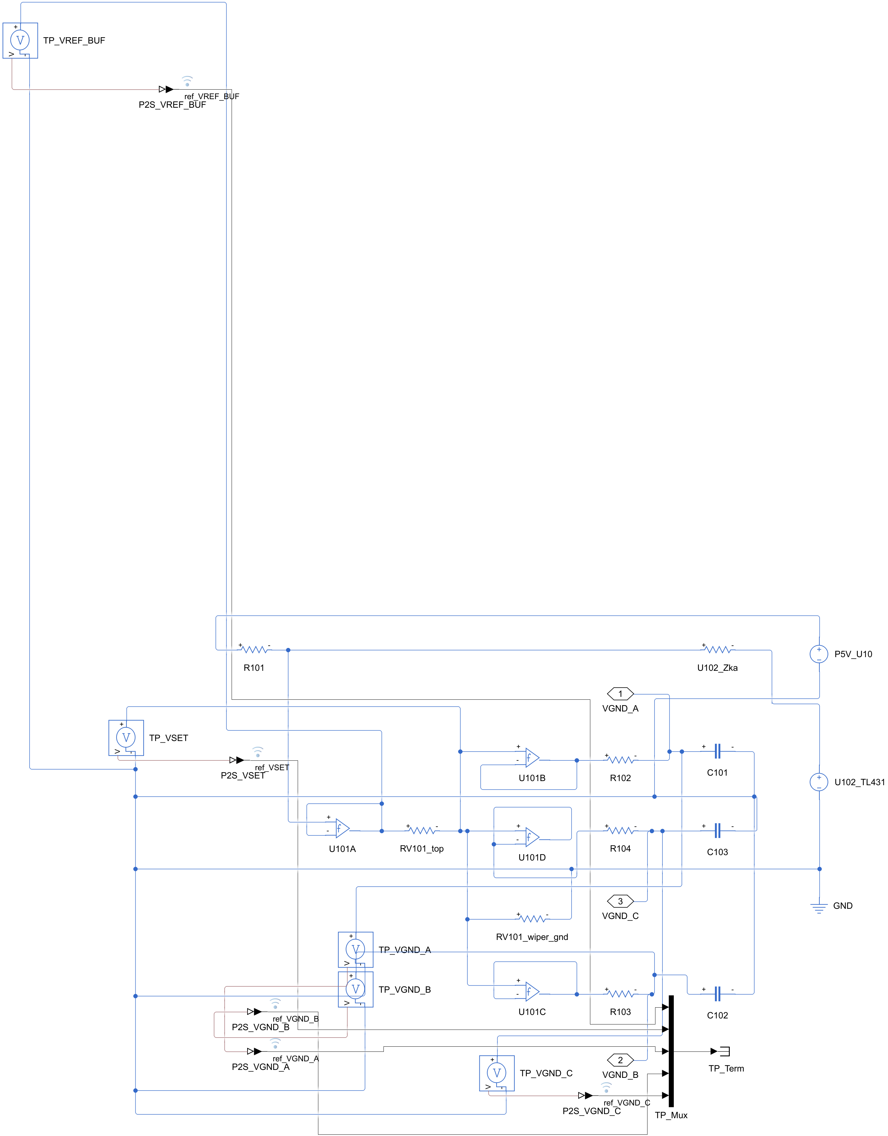
sim/docs/img/m2c_reference.png
