AaronDoubert/quadcopter-pid-boards/sim/docs/img/m2c_yaw_sheet.png

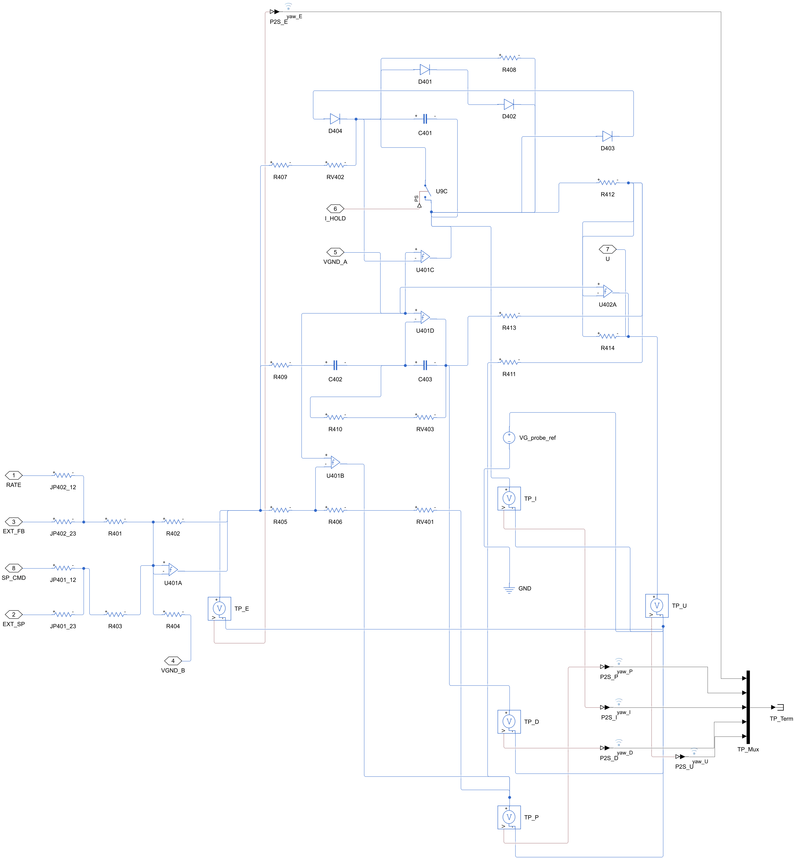
sim/docs/img/m2c_yaw_sheet.png
