AaronDoubert/quadcopter-pid-boards/sim/docs/img/m2f_analog_top.png

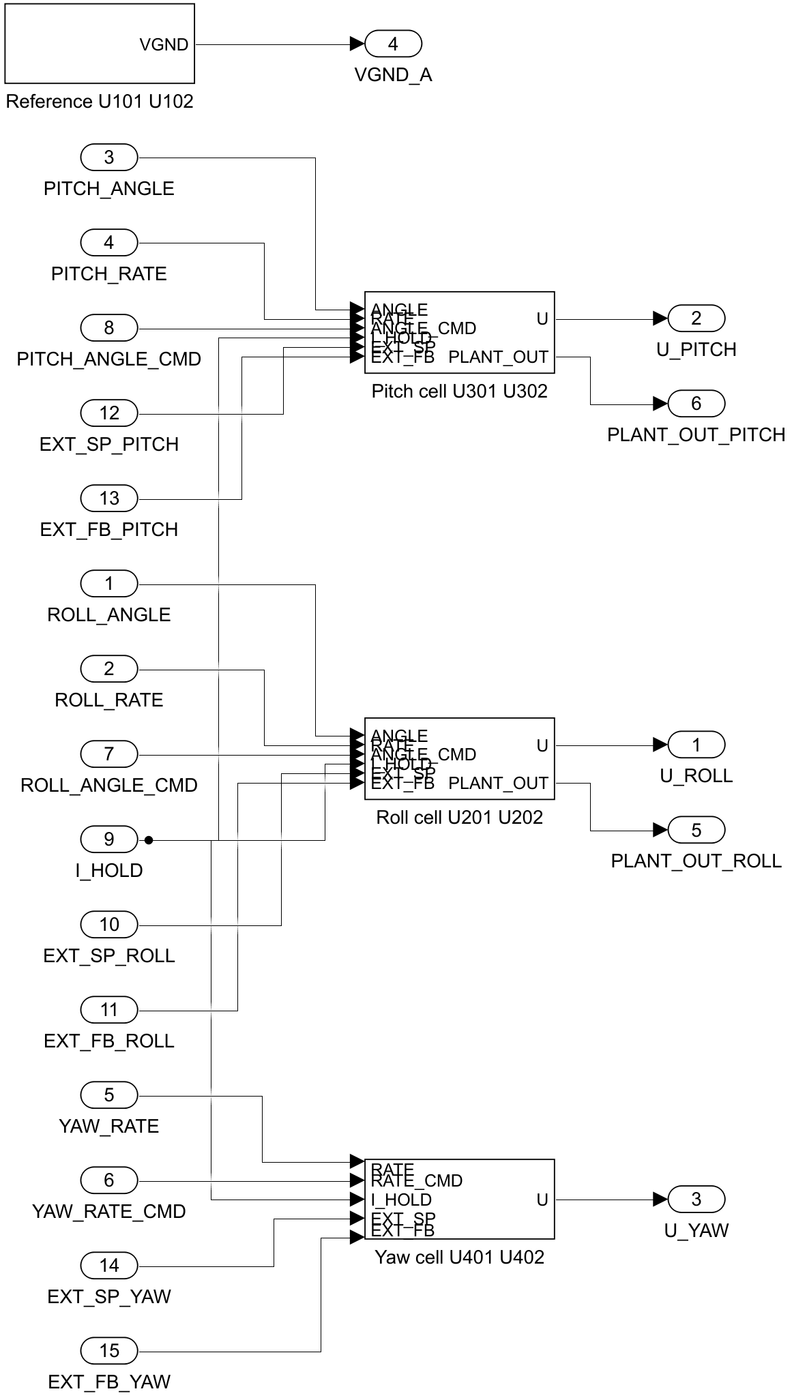
sim/docs/img/m2f_analog_top.png
