AaronDoubert/quadcopter-pid-boards/sim/docs/img/m2f_yaw_cell.png

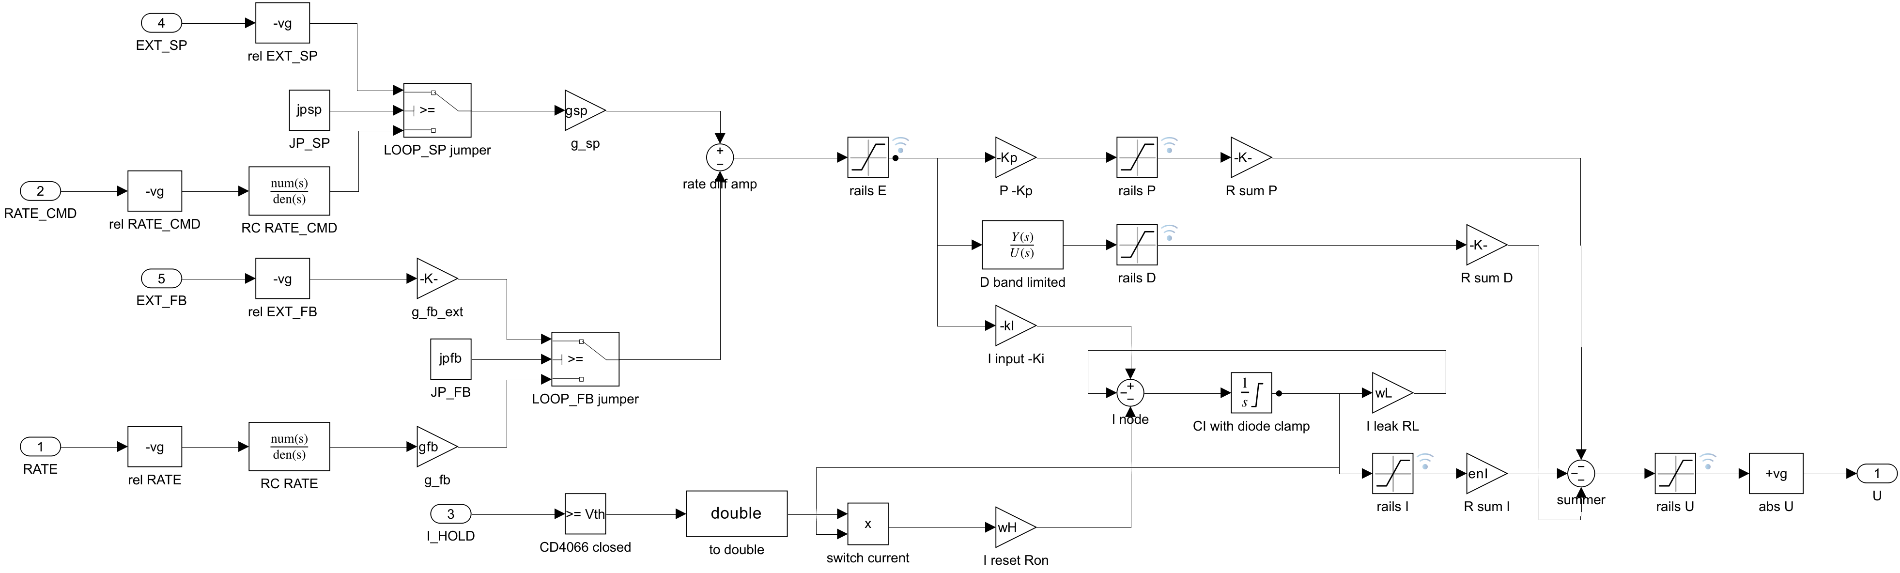
sim/docs/img/m2f_yaw_cell.png
