AaronDoubert/quadcopter-pid-boards/PID_Board/fab/PID_Board-bom.csv

Refs | Value | Footprint | Qty | DNP
C3 | 10uF | Capacitor_THT:CP_Radial_D5.0mm_P2.00mm | 1
C4 | 100nF X7R | Capacitor_THT:C_Disc_D5.0mm_W2.5mm_P5.00mm | 1
C5 | 100nF X7R | Capacitor_THT:C_Disc_D5.0mm_W2.5mm_P5.00mm | 1
C6 | 100nF X7R | Capacitor_THT:C_Disc_D5.0mm_W2.5mm_P5.00mm | 1
C7 | 100nF X7R | Capacitor_THT:C_Disc_D5.0mm_W2.5mm_P5.00mm | 1
C8 | 100nF X7R | Capacitor_THT:C_Disc_D5.0mm_W2.5mm_P5.00mm | 1
C9 | 100nF X7R | Capacitor_THT:C_Disc_D5.0mm_W2.5mm_P5.00mm | 1
C10 | 100nF X7R | Capacitor_THT:C_Disc_D5.0mm_W2.5mm_P5.00mm | 1
C15 | 1uF | Capacitor_THT:C_Disc_D5.0mm_W2.5mm_P5.00mm | 1
C16 | 1uF | Capacitor_THT:C_Disc_D5.0mm_W2.5mm_P5.00mm | 1
C17 | 1uF | Capacitor_THT:C_Disc_D5.0mm_W2.5mm_P5.00mm | 1
C18 | 1uF | Capacitor_THT:C_Disc_D5.0mm_W2.5mm_P5.00mm | 1
C19 | 1uF | Capacitor_THT:C_Disc_D5.0mm_W2.5mm_P5.00mm | 1
C20 | 1uF | Capacitor_THT:C_Disc_D5.0mm_W2.5mm_P5.00mm | 1
C21 | 1uF | Capacitor_THT:C_Disc_D5.0mm_W2.5mm_P5.00mm | 1
C22 | 1uF | Capacitor_THT:C_Disc_D5.0mm_W2.5mm_P5.00mm | 1
C23 | 1uF | Capacitor_THT:C_Disc_D5.0mm_W2.5mm_P5.00mm | 1
C24 | 1uF | Capacitor_THT:C_Disc_D5.0mm_W2.5mm_P5.00mm | 1
C25 | 47uF 25V | Capacitor_THT:CP_Radial_D5.0mm_P2.00mm | 1
C26 | 10uF | Capacitor_THT:CP_Radial_D5.0mm_P2.00mm | 1
C27 | 100nF X7R | Capacitor_THT:C_Disc_D5.0mm_W2.5mm_P5.00mm | 1
C28 | 100nF X7R | Capacitor_THT:C_Disc_D5.0mm_W2.5mm_P5.00mm | 1
C101 | 470nF film | Capacitor_THT:C_Rect_L7.2mm_W4.5mm_P5.00mm_FKS2_FKP2_MKS2_MKP2 | 1
C102 | 470nF film | Capacitor_THT:C_Rect_L7.2mm_W4.5mm_P5.00mm_FKS2_FKP2_MKS2_MKP2 | 1
C103 | 470nF film | Capacitor_THT:C_Rect_L7.2mm_W4.5mm_P5.00mm_FKS2_FKP2_MKS2_MKP2 | 1
C104 | 100nF X7R | Capacitor_THT:C_Disc_D5.0mm_W2.5mm_P5.00mm | 1
C105 | 10uF | Capacitor_THT:CP_Radial_D5.0mm_P2.00mm | 1
C106 | 10uF | Capacitor_THT:CP_Radial_D5.0mm_P2.00mm | 1
C201 | 1uF film | Capacitor_THT:C_Rect_L7.2mm_W5.5mm_P5.00mm_FKS2_FKP2_MKS2_MKP2 | 1
C202 | 100nF film | Capacitor_THT:C_Rect_L7.2mm_W2.5mm_P5.00mm_FKS2_FKP2_MKS2_MKP2 | 1
C203 | 10nF C0G | Capacitor_THT:C_Disc_D5.0mm_W2.5mm_P5.00mm | 1
C204 | 1uF film | Capacitor_THT:C_Rect_L7.2mm_W5.5mm_P5.00mm_FKS2_FKP2_MKS2_MKP2 | 1
C205 | 100nF X7R | Capacitor_THT:C_Disc_D5.0mm_W2.5mm_P5.00mm | 1
C206 | 100nF X7R | Capacitor_THT:C_Disc_D5.0mm_W2.5mm_P5.00mm | 1
C301 | 1uF film | Capacitor_THT:C_Rect_L7.2mm_W5.5mm_P5.00mm_FKS2_FKP2_MKS2_MKP2 | 1
C302 | 100nF film | Capacitor_THT:C_Rect_L7.2mm_W2.5mm_P5.00mm_FKS2_FKP2_MKS2_MKP2 | 1
C303 | 10nF C0G | Capacitor_THT:C_Disc_D5.0mm_W2.5mm_P5.00mm | 1
C304 | 1uF film | Capacitor_THT:C_Rect_L7.2mm_W5.5mm_P5.00mm_FKS2_FKP2_MKS2_MKP2 | 1
C305 | 100nF X7R | Capacitor_THT:C_Disc_D5.0mm_W2.5mm_P5.00mm | 1
C306 | 100nF X7R | Capacitor_THT:C_Disc_D5.0mm_W2.5mm_P5.00mm | 1
C401 | 1uF film | Capacitor_THT:C_Rect_L7.2mm_W5.5mm_P5.00mm_FKS2_FKP2_MKS2_MKP2 | 1
C402 | 100nF film | Capacitor_THT:C_Rect_L7.2mm_W2.5mm_P5.00mm_FKS2_FKP2_MKS2_MKP2 | 1
C403 | 10nF C0G | Capacitor_THT:C_Disc_D5.0mm_W2.5mm_P5.00mm | 1
C404 | 100nF X7R | Capacitor_THT:C_Disc_D5.0mm_W2.5mm_P5.00mm | 1
C405 | 100nF X7R | Capacitor_THT:C_Disc_D5.0mm_W2.5mm_P5.00mm | 1
D1 | 1N5817 | Diode_THT:D_DO-41_SOD81_P10.16mm_Horizontal | 1
D201 | 1N4148 | Diode_THT:D_DO-35_SOD27_P7.62mm_Horizontal | 1
D202 | 1N4148 | Diode_THT:D_DO-35_SOD27_P7.62mm_Horizontal | 1
D203 | 1N4148 | Diode_THT:D_DO-35_SOD27_P7.62mm_Horizontal | 1
D204 | 1N4148 | Diode_THT:D_DO-35_SOD27_P7.62mm_Horizontal | 1
D301 | 1N4148 | Diode_THT:D_DO-35_SOD27_P7.62mm_Horizontal | 1
D302 | 1N4148 | Diode_THT:D_DO-35_SOD27_P7.62mm_Horizontal | 1
D303 | 1N4148 | Diode_THT:D_DO-35_SOD27_P7.62mm_Horizontal | 1
D304 | 1N4148 | Diode_THT:D_DO-35_SOD27_P7.62mm_Horizontal | 1
D401 | 1N4148 | Diode_THT:D_DO-35_SOD27_P7.62mm_Horizontal | 1
D402 | 1N4148 | Diode_THT:D_DO-35_SOD27_P7.62mm_Horizontal | 1
D403 | 1N4148 | Diode_THT:D_DO-35_SOD27_P7.62mm_Horizontal | 1
D404 | 1N4148 | Diode_THT:D_DO-35_SOD27_P7.62mm_Horizontal | 1
H1 | MountingHole | MountingHole:MountingHole_3.2mm_M3 | 1
H2 | MountingHole | MountingHole:MountingHole_3.2mm_M3 | 1
H3 | MountingHole | MountingHole:MountingHole_3.2mm_M3 | 1
H4 | MountingHole | MountingHole:MountingHole_3.2mm_M3 | 1
H5 | MountingHole | MountingHole:MountingHole_3.2mm_M3 | 1
H6 | MountingHole | MountingHole:MountingHole_3.2mm_M3 | 1
H7 | MountingHole | MountingHole:MountingHole_3.2mm_M3 | 1
H8 | MountingHole | MountingHole:MountingHole_3.2mm_M3 | 1
J1 | Axis_Mon | Connector_PinHeader_2.54mm:PinHeader_1x07_P2.54mm_Vertical | 1
J2 | IMU_GY521 | Connector_PinHeader_2.54mm:PinHeader_1x08_P2.54mm_Vertical | 1
J4 | UPDI | Connector_PinHeader_2.54mm:PinHeader_1x03_P2.54mm_Vertical | 1
J5 | ESC_4in1 | Connector_PinHeader_2.54mm:PinHeader_1x08_P2.54mm_Vertical | 1
J6 | ELRS_RX | Connector_PinHeader_2.54mm:PinHeader_1x04_P2.54mm_Vertical | 1
J7 | UPDI2 | Connector_PinHeader_2.54mm:PinHeader_1x03_P2.54mm_Vertical | 1
JP201 | LOOP_SP: 1-2 closed, 2-3 bench | Connector_PinHeader_2.54mm:PinHeader_1x03_P2.54mm_Vertical | 1
JP202 | LOOP_FB: 1-2 gyro, 2-3 bench | Connector_PinHeader_2.54mm:PinHeader_1x03_P2.54mm_Vertical | 1
JP301 | LOOP_SP: 1-2 closed, 2-3 bench | Connector_PinHeader_2.54mm:PinHeader_1x03_P2.54mm_Vertical | 1
JP302 | LOOP_FB: 1-2 gyro, 2-3 bench | Connector_PinHeader_2.54mm:PinHeader_1x03_P2.54mm_Vertical | 1
JP401 | LOOP_SP: 1-2 closed, 2-3 bench | Connector_PinHeader_2.54mm:PinHeader_1x03_P2.54mm_Vertical | 1
JP402 | LOOP_FB: 1-2 gyro, 2-3 bench | Connector_PinHeader_2.54mm:PinHeader_1x03_P2.54mm_Vertical | 1
Q1 | 2N7000 | Package_TO_SOT_THT:TO-92_Inline_Wide | 1
Q2 | 2N7000 | Package_TO_SOT_THT:TO-92_Inline_Wide | 1
Q3 | 2N7000 | Package_TO_SOT_THT:TO-92_Inline_Wide | 1
R1 | 4.7k | Resistor_THT:R_Axial_DIN0207_L6.3mm_D2.5mm_P10.16mm_Horizontal | 1
R2 | 10k | Resistor_THT:R_Axial_DIN0207_L6.3mm_D2.5mm_P10.16mm_Horizontal | 1
R3 | 4.7k | Resistor_THT:R_Axial_DIN0207_L6.3mm_D2.5mm_P10.16mm_Horizontal | 1
R4 | 22k | Resistor_THT:R_Axial_DIN0207_L6.3mm_D2.5mm_P10.16mm_Horizontal | 1
R5 | 1k | Resistor_THT:R_Axial_DIN0207_L6.3mm_D2.5mm_P10.16mm_Horizontal | 1
R6 | 1k | Resistor_THT:R_Axial_DIN0207_L6.3mm_D2.5mm_P10.16mm_Horizontal | 1
R7 | 1k | Resistor_THT:R_Axial_DIN0207_L6.3mm_D2.5mm_P10.16mm_Horizontal | 1
R8 | 1k | Resistor_THT:R_Axial_DIN0207_L6.3mm_D2.5mm_P10.16mm_Horizontal | 1
R9 | 1k | Resistor_THT:R_Axial_DIN0207_L6.3mm_D2.5mm_P10.16mm_Horizontal | 1
R10 | 1k | Resistor_THT:R_Axial_DIN0207_L6.3mm_D2.5mm_P10.16mm_Horizontal | 1
R11 | 1k | Resistor_THT:R_Axial_DIN0207_L6.3mm_D2.5mm_P10.16mm_Horizontal | 1
R12 | 1k | Resistor_THT:R_Axial_DIN0207_L6.3mm_D2.5mm_P10.16mm_Horizontal | 1
R13 | 1k | Resistor_THT:R_Axial_DIN0207_L6.3mm_D2.5mm_P10.16mm_Horizontal | 1
R14 | 1k | Resistor_THT:R_Axial_DIN0207_L6.3mm_D2.5mm_P10.16mm_Horizontal | 1
R15 | 1k | Resistor_THT:R_Axial_DIN0207_L6.3mm_D2.5mm_P10.16mm_Horizontal | 1
R16 | 2.2k | Resistor_THT:R_Axial_DIN0207_L6.3mm_D2.5mm_P10.16mm_Horizontal | 1
R17 | 1k | Resistor_THT:R_Axial_DIN0207_L6.3mm_D2.5mm_P10.16mm_Horizontal | 1
R18 | 2.2k | Resistor_THT:R_Axial_DIN0207_L6.3mm_D2.5mm_P10.16mm_Horizontal | 1
R19 | 1k | Resistor_THT:R_Axial_DIN0207_L6.3mm_D2.5mm_P10.16mm_Horizontal | 1
R20 | 2.2k | Resistor_THT:R_Axial_DIN0207_L6.3mm_D2.5mm_P10.16mm_Horizontal | 1
R21 | 1k | Resistor_THT:R_Axial_DIN0207_L6.3mm_D2.5mm_P10.16mm_Horizontal | 1
R22 | 2.2k | Resistor_THT:R_Axial_DIN0207_L6.3mm_D2.5mm_P10.16mm_Horizontal | 1
R23 | 2.2k | Resistor_THT:R_Axial_DIN0207_L6.3mm_D2.5mm_P10.16mm_Horizontal | 1
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
R407 | 15k | Resistor_THT:R_Axial_DIN0207_L6.3mm_D2.5mm_P10.16mm_Horizontal | 1
R408 | 1M | Resistor_THT:R_Axial_DIN0207_L6.3mm_D2.5mm_P10.16mm_Horizontal | 1
R409 | 27k | Resistor_THT:R_Axial_DIN0207_L6.3mm_D2.5mm_P10.16mm_Horizontal | 1
R410 | 47k | Resistor_THT:R_Axial_DIN0207_L6.3mm_D2.5mm_P10.16mm_Horizontal | 1
R411 | 10k | Resistor_THT:R_Axial_DIN0207_L6.3mm_D2.5mm_P10.16mm_Horizontal | 1
R412 | 10k | Resistor_THT:R_Axial_DIN0207_L6.3mm_D2.5mm_P10.16mm_Horizontal | 1
R413 | 10k DNP | Resistor_THT:R_Axial_DIN0207_L6.3mm_D2.5mm_P10.16mm_Horizontal | 1 | DNP
R414 | 10k | Resistor_THT:R_Axial_DIN0207_L6.3mm_D2.5mm_P10.16mm_Horizontal | 1
RV101 | 10k (wiper-GND 8.1k) | Potentiometer_THT:Potentiometer_Bourns_3296W_Vertical | 1
RV201 | 100k, set 50k (Kp 1.16) | Potentiometer_THT:Potentiometer_Bourns_3296W_Vertical | 1
RV202 | 100k, set 67k (Ki 10/s) | Potentiometer_THT:Potentiometer_Bourns_3296W_Vertical | 1
RV203 | 100k, set 50k (Kd 9.7 ms) | Potentiometer_THT:Potentiometer_Bourns_3296W_Vertical | 1
RV204 | 50k, set 25k (Go 1.75) | Potentiometer_THT:Potentiometer_Bourns_3296W_Vertical | 1
RV301 | 100k, set 50k (Kp 1.16) | Potentiometer_THT:Potentiometer_Bourns_3296W_Vertical | 1
RV302 | 100k, set 67k (Ki 10/s) | Potentiometer_THT:Potentiometer_Bourns_3296W_Vertical | 1
RV303 | 100k, set 50k (Kd 9.7 ms) | Potentiometer_THT:Potentiometer_Bourns_3296W_Vertical | 1
RV304 | 50k, set 25k (Go 1.75) | Potentiometer_THT:Potentiometer_Bourns_3296W_Vertical | 1
RV401 | 100k, set 50k (Kp 1.16) | Potentiometer_THT:Potentiometer_Bourns_3296W_Vertical | 1
RV402 | 100k, set mid | Potentiometer_THT:Potentiometer_Bourns_3296W_Vertical | 1
RV403 | 100k, set 50k (Kd 9.7 ms) | Potentiometer_THT:Potentiometer_Bourns_3296W_Vertical | 1
TP101 | VREF_BUF | Connector_PinHeader_2.54mm:PinHeader_1x01_P2.54mm_Vertical | 1
TP102 | VSET | Connector_PinHeader_2.54mm:PinHeader_1x01_P2.54mm_Vertical | 1
TP103 | VGND_A | Connector_PinHeader_2.54mm:PinHeader_1x01_P2.54mm_Vertical | 1
TP104 | VGND_B | Connector_PinHeader_2.54mm:PinHeader_1x01_P2.54mm_Vertical | 1
TP105 | VGND_C | Connector_PinHeader_2.54mm:PinHeader_1x01_P2.54mm_Vertical | 1
TP201 | E_RR | Connector_PinHeader_2.54mm:PinHeader_1x01_P2.54mm_Vertical | 1
TP202 | P_OUT | Connector_PinHeader_2.54mm:PinHeader_1x01_P2.54mm_Vertical | 1
TP203 | I_OUT | Connector_PinHeader_2.54mm:PinHeader_1x01_P2.54mm_Vertical | 1
TP204 | D_OUT | Connector_PinHeader_2.54mm:PinHeader_1x01_P2.54mm_Vertical | 1
TP205 | U_ROLL | Connector_PinHeader_2.54mm:PinHeader_1x01_P2.54mm_Vertical | 1
TP206 | E_A | Connector_PinHeader_2.54mm:PinHeader_1x01_P2.54mm_Vertical | 1
TP207 | ROLL_RATE_SP | Connector_PinHeader_2.54mm:PinHeader_1x01_P2.54mm_Vertical | 1
TP208 | PLANT_OUT | Connector_PinHeader_2.54mm:PinHeader_1x01_P2.54mm_Vertical | 1
TP209 | EXT_SP | Connector_PinHeader_2.54mm:PinHeader_1x01_P2.54mm_Vertical | 1
TP210 | EXT_FB | Connector_PinHeader_2.54mm:PinHeader_1x01_P2.54mm_Vertical | 1
TP301 | E_PR | Connector_PinHeader_2.54mm:PinHeader_1x01_P2.54mm_Vertical | 1
TP302 | P_OUT | Connector_PinHeader_2.54mm:PinHeader_1x01_P2.54mm_Vertical | 1
TP303 | I_OUT | Connector_PinHeader_2.54mm:PinHeader_1x01_P2.54mm_Vertical | 1
TP304 | D_OUT | Connector_PinHeader_2.54mm:PinHeader_1x01_P2.54mm_Vertical | 1
TP305 | U_PITCH | Connector_PinHeader_2.54mm:PinHeader_1x01_P2.54mm_Vertical | 1
TP306 | E_A | Connector_PinHeader_2.54mm:PinHeader_1x01_P2.54mm_Vertical | 1
TP307 | PITCH_RATE_SP | Connector_PinHeader_2.54mm:PinHeader_1x01_P2.54mm_Vertical | 1
TP308 | PLANT_OUT | Connector_PinHeader_2.54mm:PinHeader_1x01_P2.54mm_Vertical | 1
TP309 | EXT_SP | Connector_PinHeader_2.54mm:PinHeader_1x01_P2.54mm_Vertical | 1
TP310 | EXT_FB | Connector_PinHeader_2.54mm:PinHeader_1x01_P2.54mm_Vertical | 1
TP401 | E_YR | Connector_PinHeader_2.54mm:PinHeader_1x01_P2.54mm_Vertical | 1
TP402 | P_OUT | Connector_PinHeader_2.54mm:PinHeader_1x01_P2.54mm_Vertical | 1
TP403 | I_OUT | Connector_PinHeader_2.54mm:PinHeader_1x01_P2.54mm_Vertical | 1
TP404 | D_OUT | Connector_PinHeader_2.54mm:PinHeader_1x01_P2.54mm_Vertical | 1
TP405 | U_YAW | Connector_PinHeader_2.54mm:PinHeader_1x01_P2.54mm_Vertical | 1
TP406 | EXT_SP | Connector_PinHeader_2.54mm:PinHeader_1x01_P2.54mm_Vertical | 1
TP407 | EXT_FB | Connector_PinHeader_2.54mm:PinHeader_1x01_P2.54mm_Vertical | 1
U1 | ATtiny1614-SS | Package_SO:SOIC-14_3.9x8.7mm_P1.27mm | 1
U2 | 74HC138 | Package_DIP:DIP-16_W7.62mm | 1
U3 | ATtiny1614-SS | Package_SO:SOIC-14_3.9x8.7mm_P1.27mm | 1
U4 | MCP4822 | Package_DIP:DIP-8_W7.62mm | 1
U5 | MCP4822 | Package_DIP:DIP-8_W7.62mm | 1
U6 | MCP4822 | Package_DIP:DIP-8_W7.62mm | 1
U7 | MCP4822 | Package_DIP:DIP-8_W7.62mm | 1
U8 | MCP4822 | Package_DIP:DIP-8_W7.62mm | 1
U9 | CD4066BE | Package_DIP:DIP-14_W7.62mm | 1
U10 | Pololu D24V5F5 | Connector_PinHeader_2.54mm:PinHeader_1x04_P2.54mm_Vertical | 1
U101 | MCP6004 | Package_DIP:DIP-14_W7.62mm | 1
U102 | TL431ACLPG | Package_TO_SOT_THT:TO-92_Inline_Wide | 1
U201 | MCP6004 | Package_DIP:DIP-14_W7.62mm | 1
U202 | MCP6004 | Package_DIP:DIP-14_W7.62mm | 1
U301 | MCP6004 | Package_DIP:DIP-14_W7.62mm | 1
U302 | MCP6004 | Package_DIP:DIP-14_W7.62mm | 1
U401 | MCP6004 | Package_DIP:DIP-14_W7.62mm | 1
U402 | MCP6004 | Package_DIP:DIP-14_W7.62mm | 1
