AaronDoubert/quadcopter-pid-boards/PID_Board_SMT/fab/PID_Board_SMT-bom.csv

Refs | Value | Footprint | Qty | DNP
C3 | 10uF 25V | Capacitor_SMD:C_0805_2012Metric | 1
C4 | 100nF X7R | Capacitor_SMD:C_0603_1608Metric | 1
C5 | 100nF X7R | Capacitor_SMD:C_0603_1608Metric | 1
C6 | 100nF X7R | Capacitor_SMD:C_0603_1608Metric | 1
C7 | 100nF X7R | Capacitor_SMD:C_0603_1608Metric | 1
C8 | 100nF X7R | Capacitor_SMD:C_0603_1608Metric | 1
C9 | 100nF X7R | Capacitor_SMD:C_0603_1608Metric | 1
C10 | 100nF X7R | Capacitor_SMD:C_0603_1608Metric | 1
C15 | 1uF | Capacitor_SMD:C_0603_1608Metric | 1
C16 | 1uF | Capacitor_SMD:C_0603_1608Metric | 1
C17 | 1uF | Capacitor_SMD:C_0603_1608Metric | 1
C18 | 1uF | Capacitor_SMD:C_0603_1608Metric | 1
C19 | 1uF | Capacitor_SMD:C_0603_1608Metric | 1
C20 | 1uF | Capacitor_SMD:C_0603_1608Metric | 1
C21 | 1uF | Capacitor_SMD:C_0603_1608Metric | 1
C22 | 1uF | Capacitor_SMD:C_0603_1608Metric | 1
C23 | 1uF | Capacitor_SMD:C_0603_1608Metric | 1
C24 | 1uF | Capacitor_SMD:C_0603_1608Metric | 1
C25 | 47uF 35V | Capacitor_SMD:CP_Elec_6.3x5.7 | 1
C26 | 22uF 10V | Capacitor_SMD:C_0805_2012Metric | 1
C27 | 100nF X7R | Capacitor_SMD:C_0603_1608Metric | 1
C28 | 100nF X7R | Capacitor_SMD:C_0603_1608Metric | 1
C29 | 10uF 25V | Capacitor_SMD:C_0805_2012Metric | 1
C30 | 100nF X7R | Capacitor_SMD:C_0603_1608Metric | 1
C31 | 100nF X7R | Capacitor_SMD:C_0603_1608Metric | 1
C32 | 22uF 10V | Capacitor_SMD:C_0805_2012Metric | 1
C101 | 470nF X7R | Capacitor_SMD:C_0603_1608Metric | 1
C102 | 470nF X7R | Capacitor_SMD:C_0603_1608Metric | 1
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
R407 | 15k | Resistor_SMD:R_0603_1608Metric | 1
R408 | 1M | Resistor_SMD:R_0603_1608Metric | 1
R409 | 27k | Resistor_SMD:R_0603_1608Metric | 1
R410 | 47k | Resistor_SMD:R_0603_1608Metric | 1
R411 | 10k | Resistor_SMD:R_0603_1608Metric | 1
R412 | 10k | Resistor_SMD:R_0603_1608Metric | 1
R413 | 10k DNP | Resistor_SMD:R_0603_1608Metric | 1 | DNP
R414 | 10k | Resistor_SMD:R_0603_1608Metric | 1
TP101 | VREF_BUF | TestPoint:TestPoint_Pad_D1.5mm | 1
TP102 | VSET | TestPoint:TestPoint_Pad_D1.5mm | 1
TP103 | VGND_A | TestPoint:TestPoint_Pad_D1.5mm | 1
TP104 | VGND_B | TestPoint:TestPoint_Pad_D1.5mm | 1
TP105 | VGND_C | TestPoint:TestPoint_Pad_D1.5mm | 1
TP201 | E_RR | TestPoint:TestPoint_Pad_D1.5mm | 1
TP202 | P_OUT | TestPoint:TestPoint_Pad_D1.5mm | 1
TP203 | I_OUT | TestPoint:TestPoint_Pad_D1.5mm | 1
TP204 | D_OUT | TestPoint:TestPoint_Pad_D1.5mm | 1
TP205 | U_ROLL | TestPoint:TestPoint_Pad_D1.5mm | 1
TP206 | E_A | TestPoint:TestPoint_Pad_D1.5mm | 1
TP207 | ROLL_RATE_SP | TestPoint:TestPoint_Pad_D1.5mm | 1
TP208 | PLANT_OUT | TestPoint:TestPoint_Pad_D1.5mm | 1
TP209 | EXT_SP | TestPoint:TestPoint_Pad_D1.5mm | 1
TP210 | EXT_FB | TestPoint:TestPoint_Pad_D1.5mm | 1
TP301 | E_PR | TestPoint:TestPoint_Pad_D1.5mm | 1
TP302 | P_OUT | TestPoint:TestPoint_Pad_D1.5mm | 1
TP303 | I_OUT | TestPoint:TestPoint_Pad_D1.5mm | 1
TP304 | D_OUT | TestPoint:TestPoint_Pad_D1.5mm | 1
TP305 | U_PITCH | TestPoint:TestPoint_Pad_D1.5mm | 1
TP306 | E_A | TestPoint:TestPoint_Pad_D1.5mm | 1
TP307 | PITCH_RATE_SP | TestPoint:TestPoint_Pad_D1.5mm | 1
TP308 | PLANT_OUT | TestPoint:TestPoint_Pad_D1.5mm | 1
TP309 | EXT_SP | TestPoint:TestPoint_Pad_D1.5mm | 1
TP310 | EXT_FB | TestPoint:TestPoint_Pad_D1.5mm | 1
TP401 | E_YR | TestPoint:TestPoint_Pad_D1.5mm | 1
TP402 | P_OUT | TestPoint:TestPoint_Pad_D1.5mm | 1
TP403 | I_OUT | TestPoint:TestPoint_Pad_D1.5mm | 1
TP404 | D_OUT | TestPoint:TestPoint_Pad_D1.5mm | 1
TP405 | U_YAW | TestPoint:TestPoint_Pad_D1.5mm | 1
TP406 | EXT_SP | TestPoint:TestPoint_Pad_D1.5mm | 1
TP407 | EXT_FB | TestPoint:TestPoint_Pad_D1.5mm | 1
U1 | ATtiny1614-SSNR | Package_SO:SOIC-14_3.9x8.7mm_P1.27mm | 1
U2 | 74HC138D | Package_SO:SOIC-16_3.9x9.9mm_P1.27mm | 1
U3 | ATtiny1614-SSNR | Package_SO:SOIC-14_3.9x8.7mm_P1.27mm | 1
U4 | MCP4822-E/SN | Package_SO:SOIC-8_3.9x4.9mm_P1.27mm | 1
U5 | MCP4822-E/SN | Package_SO:SOIC-8_3.9x4.9mm_P1.27mm | 1
U6 | MCP4822-E/SN | Package_SO:SOIC-8_3.9x4.9mm_P1.27mm | 1
U7 | MCP4822-E/SN | Package_SO:SOIC-8_3.9x4.9mm_P1.27mm | 1
U8 | MCP4822-E/SN | Package_SO:SOIC-8_3.9x4.9mm_P1.27mm | 1
U9 | 74HC4066D | Package_SO:SOIC-14_3.9x8.7mm_P1.27mm | 1
U10 | TPS54202DDCR | Package_TO_SOT_SMD:SOT-23-6 | 1
U101 | LMV324B-SR | Package_SO:SOIC-14_3.9x8.7mm_P1.27mm | 1
U102 | TL431BIDBZR | Package_TO_SOT_SMD:SOT-23 | 1
U103 | MCP4451-104E/ST | Package_SO:TSSOP-20_4.4x6.5mm_P0.65mm | 1
U201 | LMV324B-SR | Package_SO:SOIC-14_3.9x8.7mm_P1.27mm | 1
U202 | LMV324B-SR | Package_SO:SOIC-14_3.9x8.7mm_P1.27mm | 1
U203 | MCP4451-104E/ST | Package_SO:TSSOP-20_4.4x6.5mm_P0.65mm | 1
U301 | LMV324B-SR | Package_SO:SOIC-14_3.9x8.7mm_P1.27mm | 1
U302 | LMV324B-SR | Package_SO:SOIC-14_3.9x8.7mm_P1.27mm | 1
U303 | MCP4451-104E/ST | Package_SO:TSSOP-20_4.4x6.5mm_P0.65mm | 1
U401 | LMV324B-SR | Package_SO:SOIC-14_3.9x8.7mm_P1.27mm | 1
U402 | LMV324B-SR | Package_SO:SOIC-14_3.9x8.7mm_P1.27mm | 1
