AaronDoubert/quadcopter-pid-boards/PID_Board/fab/JLC_PCBWay_THT/PID_Board-BOM_grouped.csv

Qty | Value | Footprint | Designators
4 | 10uF | CP_Radial_D5.0mm_P2.00mm | C3 C26 C105 C106
16 | 100nF X7R | C_Disc_D5.0mm_W2.5mm_P5.00mm | C4 C5 C6 C7 C8 C9 C10 C27 C28 C104 C205 C206 C305 C306 C404 C405
10 | 1uF | C_Disc_D5.0mm_W2.5mm_P5.00mm | C15 C16 C17 C18 C19 C20 C21 C22 C23 C24
1 | 47uF 25V | CP_Radial_D5.0mm_P2.00mm | C25
3 | 470nF film | C_Rect_L7.2mm_W4.5mm_P5.00mm_FKS2_FKP2_MKS2_MKP2 | C101 C102 C103
5 | 1uF film | C_Rect_L7.2mm_W5.5mm_P5.00mm_FKS2_FKP2_MKS2_MKP2 | C201 C204 C301 C304 C401
3 | 100nF film | C_Rect_L7.2mm_W2.5mm_P5.00mm_FKS2_FKP2_MKS2_MKP2 | C202 C302 C402
3 | 10nF C0G | C_Disc_D5.0mm_W2.5mm_P5.00mm | C203 C303 C403
1 | 1N5817 | D_DO-41_SOD81_P10.16mm_Horizontal | D1
12 | 1N4148 | D_DO-35_SOD27_P7.62mm_Horizontal | D201 D202 D203 D204 D301 D302 D303 D304 D401 D402 D403 D404
1 | Axis_Mon | PinHeader_1x07_P2.54mm_Vertical | J1
1 | IMU_GY521 | PinHeader_1x08_P2.54mm_Vertical | J2
1 | UPDI | PinHeader_1x03_P2.54mm_Vertical | J4
1 | ESC_4in1 | PinHeader_1x08_P2.54mm_Vertical | J5
1 | ELRS_RX | PinHeader_1x04_P2.54mm_Vertical | J6
1 | UPDI2 | PinHeader_1x03_P2.54mm_Vertical | J7
3 | LOOP_SP: 1-2 closed, 2-3 bench | PinHeader_1x03_P2.54mm_Vertical | JP201 JP301 JP401
3 | LOOP_FB: 1-2 gyro, 2-3 bench | PinHeader_1x03_P2.54mm_Vertical | JP202 JP302 JP402
3 | 2N7000 | TO-92_Inline_Wide | Q1 Q2 Q3
5 | 4.7k | R_Axial_DIN0207_L6.3mm_D2.5mm_P7.62mm_Horizontal | R1 R3 R206 R306 R406
36 | 10k | R_Axial_DIN0207_L6.3mm_D2.5mm_P7.62mm_Horizontal | R2 R24 R25 R201 R202 R203 R204 R211 R212 R213 R214 R215 R216 R217 R218 R220 R301 R302 R303 R304 R311 R312 R313 R314 R315 R316 R317 R318 R320 R401 R402 R403 R404 R411 R412 R414
3 | 22k | R_Axial_DIN0207_L6.3mm_D2.5mm_P7.62mm_Horizontal | R4 R221 R321
15 | 1k | R_Axial_DIN0207_L6.3mm_D2.5mm_P7.62mm_Horizontal | R5 R6 R7 R8 R9 R10 R11 R12 R13 R14 R15 R17 R19 R21 R101
5 | 2.2k | R_Axial_DIN0207_L6.3mm_D2.5mm_P7.62mm_Horizontal | R16 R18 R20 R22 R23
3 | 100 | R_Axial_DIN0207_L6.3mm_D2.5mm_P7.62mm_Horizontal | R102 R103 R104
6 | 47k | R_Axial_DIN0207_L6.3mm_D2.5mm_P7.62mm_Horizontal | R205 R210 R305 R310 R405 R410
2 | 33k | R_Axial_DIN0207_L6.3mm_D2.5mm_P7.62mm_Horizontal | R207 R307
3 | 1M | R_Axial_DIN0207_L6.3mm_D2.5mm_P7.62mm_Horizontal | R208 R308 R408
3 | 27k | R_Axial_DIN0207_L6.3mm_D2.5mm_P7.62mm_Horizontal | R209 R309 R409
2 | 20k | R_Axial_DIN0207_L6.3mm_D2.5mm_P7.62mm_Horizontal | R219 R319
1 | 15k | R_Axial_DIN0207_L6.3mm_D2.5mm_P7.62mm_Horizontal | R407
1 | 10k DNP | R_Axial_DIN0207_L6.3mm_D2.5mm_P7.62mm_Horizontal | R413
1 | 10k (wiper-GND 8.1k) | Potentiometer_Bourns_3296W_Vertical | RV101
3 | 100k, set 50k (Kp 1.16) | Potentiometer_Bourns_3296W_Vertical | RV201 RV301 RV401
2 | 100k, set 67k (Ki 10/s) | Potentiometer_Bourns_3296W_Vertical | RV202 RV302
3 | 100k, set 50k (Kd 9.7 ms) | Potentiometer_Bourns_3296W_Vertical | RV203 RV303 RV403
2 | 50k, set 25k (Go 1.75) | Potentiometer_Bourns_3296W_Vertical | RV204 RV304
1 | 100k, set mid | Potentiometer_Bourns_3296W_Vertical | RV402
2 | ATtiny1614-SS | SOIC-14_3.9x8.7mm_P1.27mm | U1 U3
1 | 74HC138 | DIP-16_W7.62mm | U2
5 | MCP4822 | DIP-8_W7.62mm | U4 U5 U6 U7 U8
1 | CD4066BE | DIP-14_W7.62mm | U9
1 | 5V buck module (Mini 5V 3A) | PinHeader_1x04_P2.54mm_Vertical | U10
7 | MCP6004 | DIP-14_W7.62mm | U101 U201 U202 U301 U302 U401 U402
1 | TL431ACLPG | TO-92_Inline_Wide | U102
32 | test pin (1x01 male header) | PinHeader_1x01_P2.54mm_Vertical | TP101 TP102 TP103 TP104 TP105 TP201 TP202 TP203 TP204 TP205 TP206 TP207 TP208 TP209 TP210 TP301 TP302 TP303 TP304 TP305 TP306 TP307 TP308 TP309 TP310 TP401 TP402 TP403 TP404 TP405 TP406 TP407
