AaronDoubert/quadcopter-pid-boards/PID_Board_SMT/cad/PID_Board_SMT.step

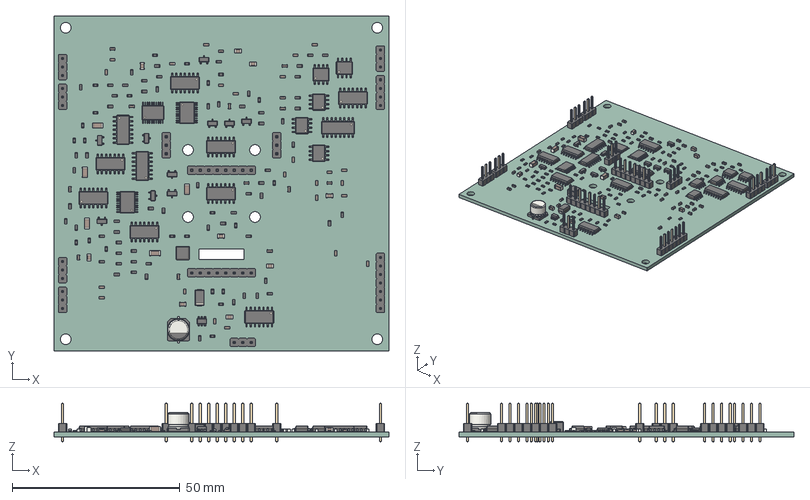
[picture p32: CAD file, 2026-10-26]
PID_Board_SMT/cad/PID_Board_SMT.step
100.0 x 100.0 x 11.5 mm
C_0603_1608Metric x 38
R_0603_1608Metric x 87
PinHeader_1x03_P254mm_Vertical x 8
C_0805_2012Metric x 9
PinHeader_1x04_P254mm_Vertical
D_SMA
SOIC-14_3.9x8.7mm_P1.27mm x 10
C_1206_3216Metric x 5
CP_Elec_63x57
PinHeader_1x07_P254mm_Vertical
TSSOP-20_4.4x6.5mm_P0.65mm x 3
SOIC-8_3.9x4.9mm_P1.27mm x 5
SOT-23 x 10
PinHeader_1x08_P254mm_Vertical x 2
SOT-23-6
L_Changjiang_FNR4030S
SOIC-16_3.9x9.9mm_P1.27mm
PID_Board_SMT_PCB
