AaronDoubert/quadcopter-pid-boards/PID_Board/cad/PID_Board_v1_Oct20_ddb5335.step

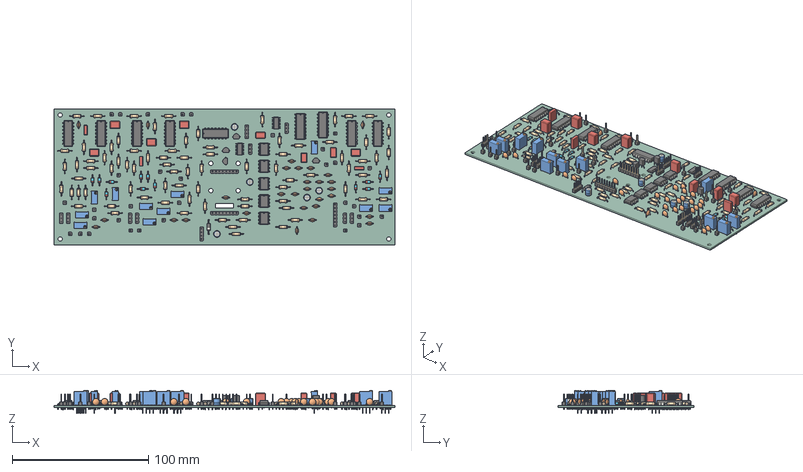
[picture p33: CAD file, 2026-10-26]
PID_Board/cad/PID_Board_v1_Oct20_ddb5335.step
250.0 x 100.0 x 17.1 mm
DIP-8_W7.62mm x 5
PinHeader_1x01_P254mm_Vertical x 32
R_Axial_DIN0207_L63mm_D25mm_P1016mm_Horizontal x 83
PinHeader_1x03_P254mm_Vertical x 8
D_DO-35_SOD27_P7.62mm_Horizontal x 12
PinHeader_1x04_P254mm_Vertical x 2
C_Rect_L72mm_W55mm_P500mm_FKS2_FKP2_MKS2_MKP2 x 5
SOIC-14_3.9x8.7mm_P1.27mm x 2
Potentiometer_Bourns_3296W_Vertical x 12
C_Rect_L72mm_W25mm_P500mm_FKS2_FKP2_MKS2_MKP2 x 3
C_Disc_D50mm_W25mm_P500mm x 29
DIP-14_W7.62mm x 8
C_Rect_L72mm_W45mm_P500mm_FKS2_FKP2_MKS2_MKP2 x 3
PinHeader_1x08_P254mm_Vertical x 2
TO-92_Inline_Wide x 4
CP_Radial_D50mm_P200mm x 5
PinHeader_1x07_P254mm_Vertical
D_DO-41_SOD81_P10.16mm_Horizontal
DIP-16_W7.62mm
PID_Board_PCB
