AaronDoubert/quadcopter-pid-boards/(list of files, cad)

Other CAD files:
PID_Board/cad/PID_Board_v2_Oct25_6a07de3.step
PID_Board/old_versions/revA_250x100_2026-10-25/PID_Board_v2_Oct25_6a07de3.step
