AaronDoubert/quadcopter-pid-boards/sim/quad_plant/results/quad_pitch_step.png

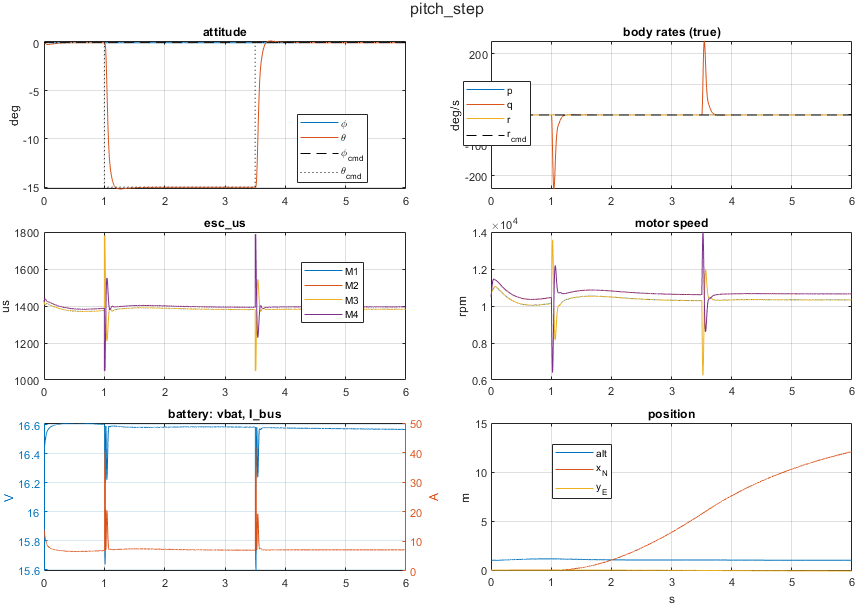
sim/quad_plant/results/quad_pitch_step.png
