AaronDoubert/quadcopter-pid-boards/sim/quad_plant/results/quad_roll_step.png

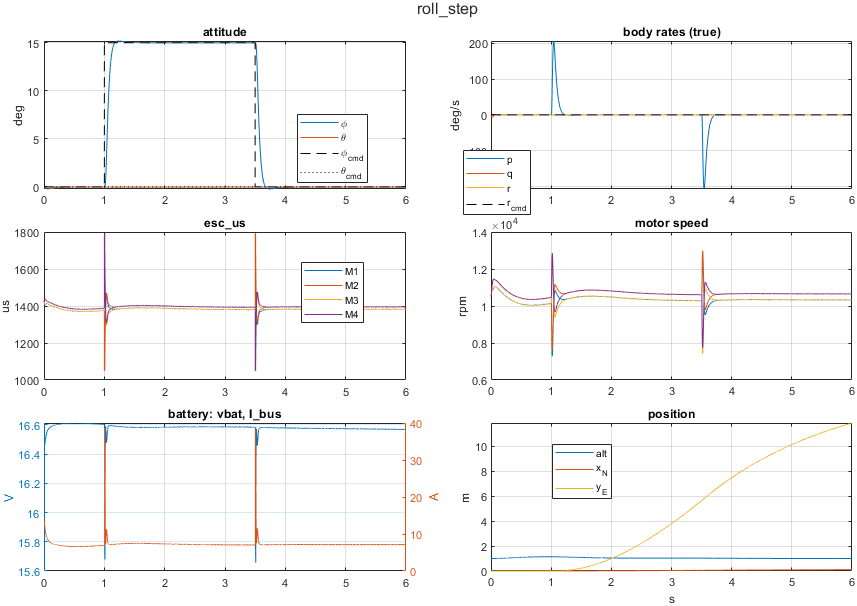
sim/quad_plant/results/quad_roll_step.png
