AaronDoubert/quadcopter-pid-boards/sim/quad_plant/results/quad_yaw_step.png

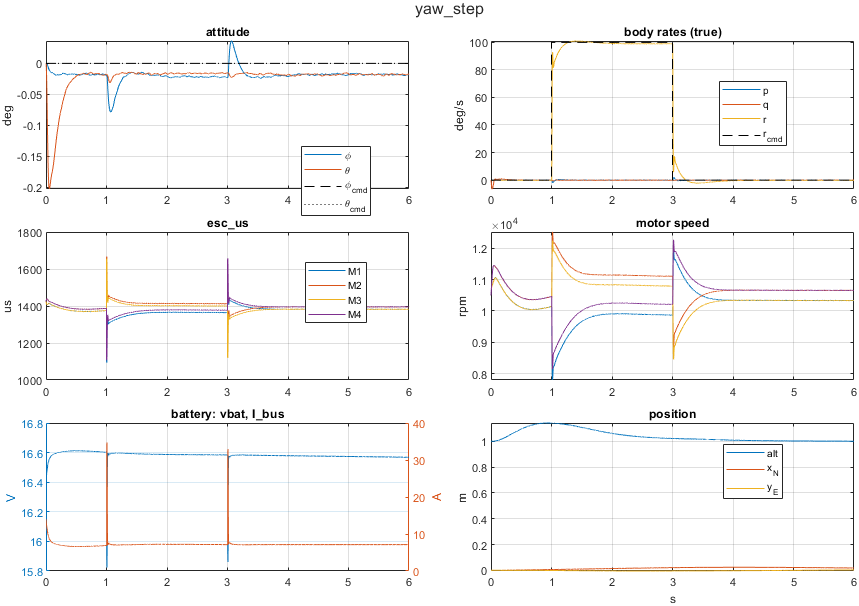
sim/quad_plant/results/quad_yaw_step.png
