AaronDoubert/quadcopter-pid-boards/sim/quad_plant/results/quad_battery_drain.png

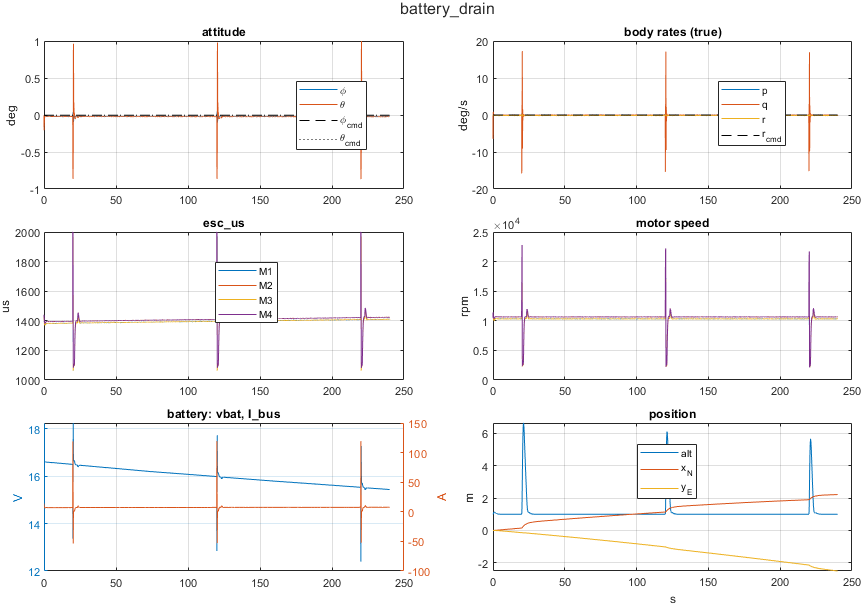
sim/quad_plant/results/quad_battery_drain.png
