AaronDoubert/quadcopter-pid-boards/sim/quad_plant/results/quad_hover.png

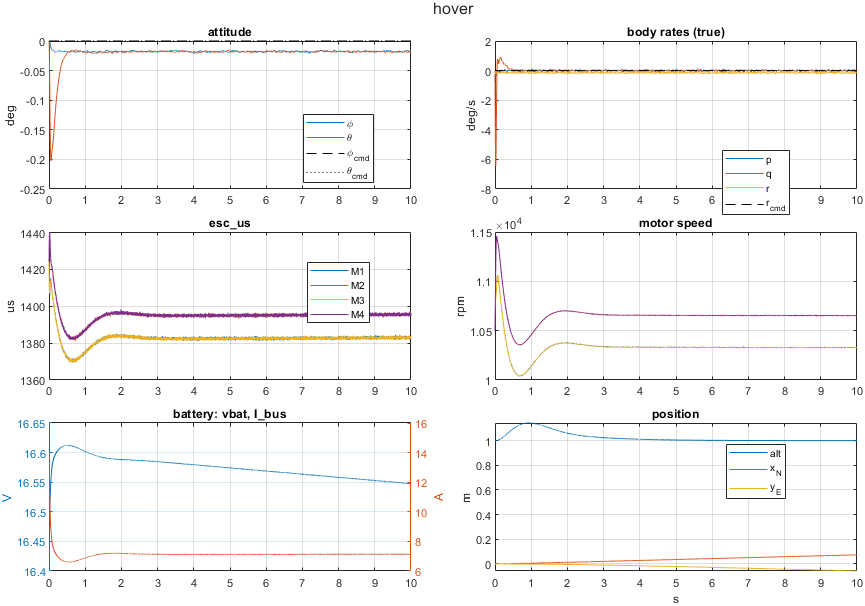
sim/quad_plant/results/quad_hover.png
