AaronDoubert/quadcopter-pid-boards/sim/quad_plant/results/quad_takeoff.png

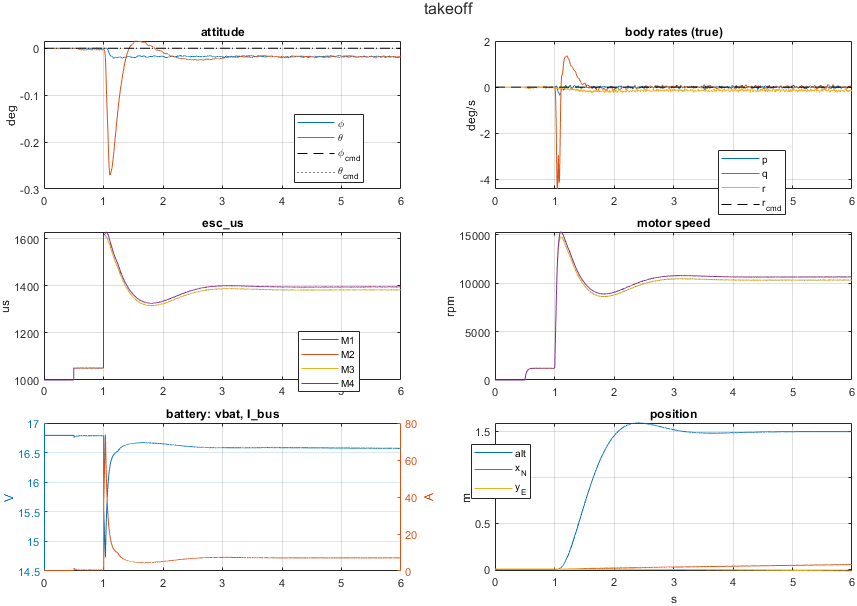
sim/quad_plant/results/quad_takeoff.png
