AaronDoubert/quadcopter-pid-boards/sim/quad_plant/results/quad_throttle_punch.png

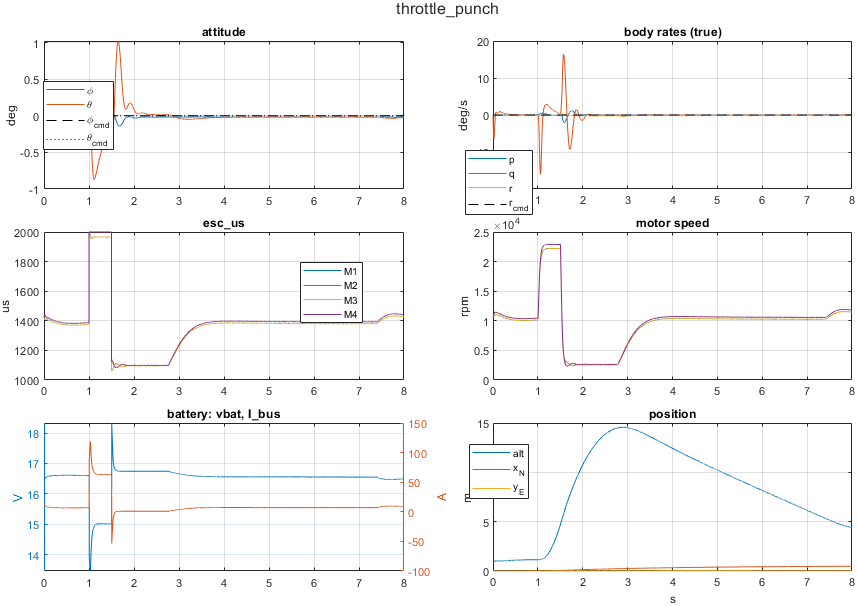
sim/quad_plant/results/quad_throttle_punch.png
