AaronDoubert/quadcopter-pid-boards/PID_Board_SMT/PID_Board_SMT_schematic.pdf

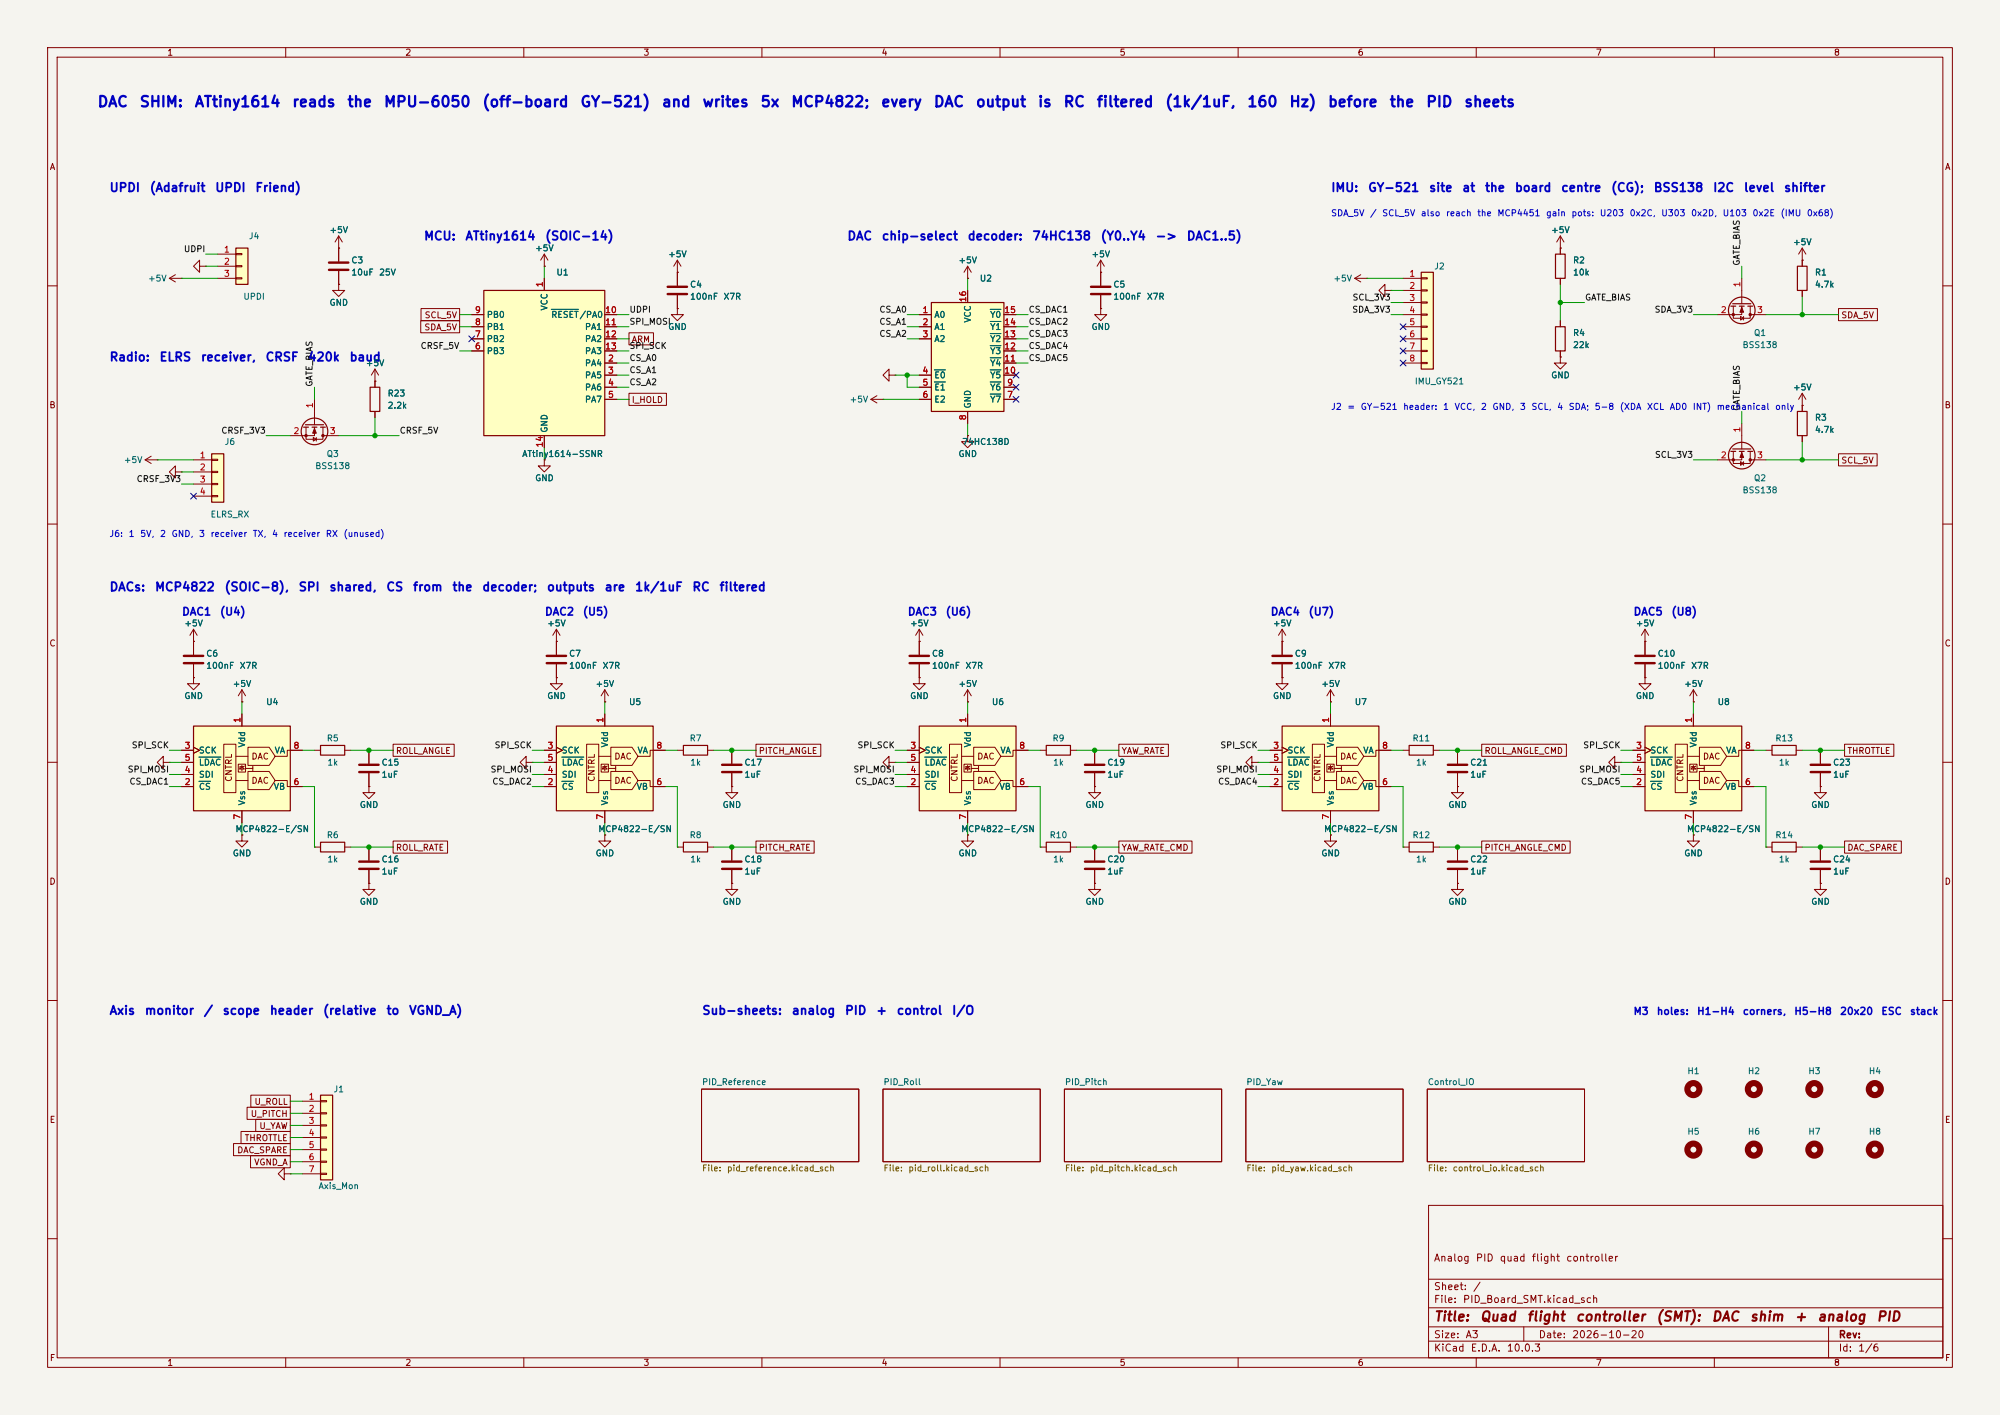
[picture p41: page 1]

DAC SHIM: ATtiny1614 reads the MPU-6050 (off-board GY-521) and writes 5x MCP4822; every DAC output is RC filtered (1k/1uF, 160 Hz) before the PID sheets

UPDI (Adafruit UPDI Friend)

IMU: GY-521 site at the board centre (CG); BSS138 I2C level shifter U8 MCP4822-E/SN Vdd 1 CS 2

DAC chip-select decoder: 74HC138 (Y0..Y4 -> DAC1..5)

DACs: MCP4822 (SOIC-8), SPI shared, CS from the decoder; outputs are 1k/1uF RC filtered

Axis monitor / scope header (relative to VGND_A)

Analog PID quad flight controller PID_Pitch

Sheet: /
File: PID_Board_SMT.kicad_sch
Title: Quad flight controller (SMT): DAC shim + analog PID

Size: A3 | Rev:
KiCad E.D.A. 10.0.3 | Id: 1/6 | F Date: 2026-10-20

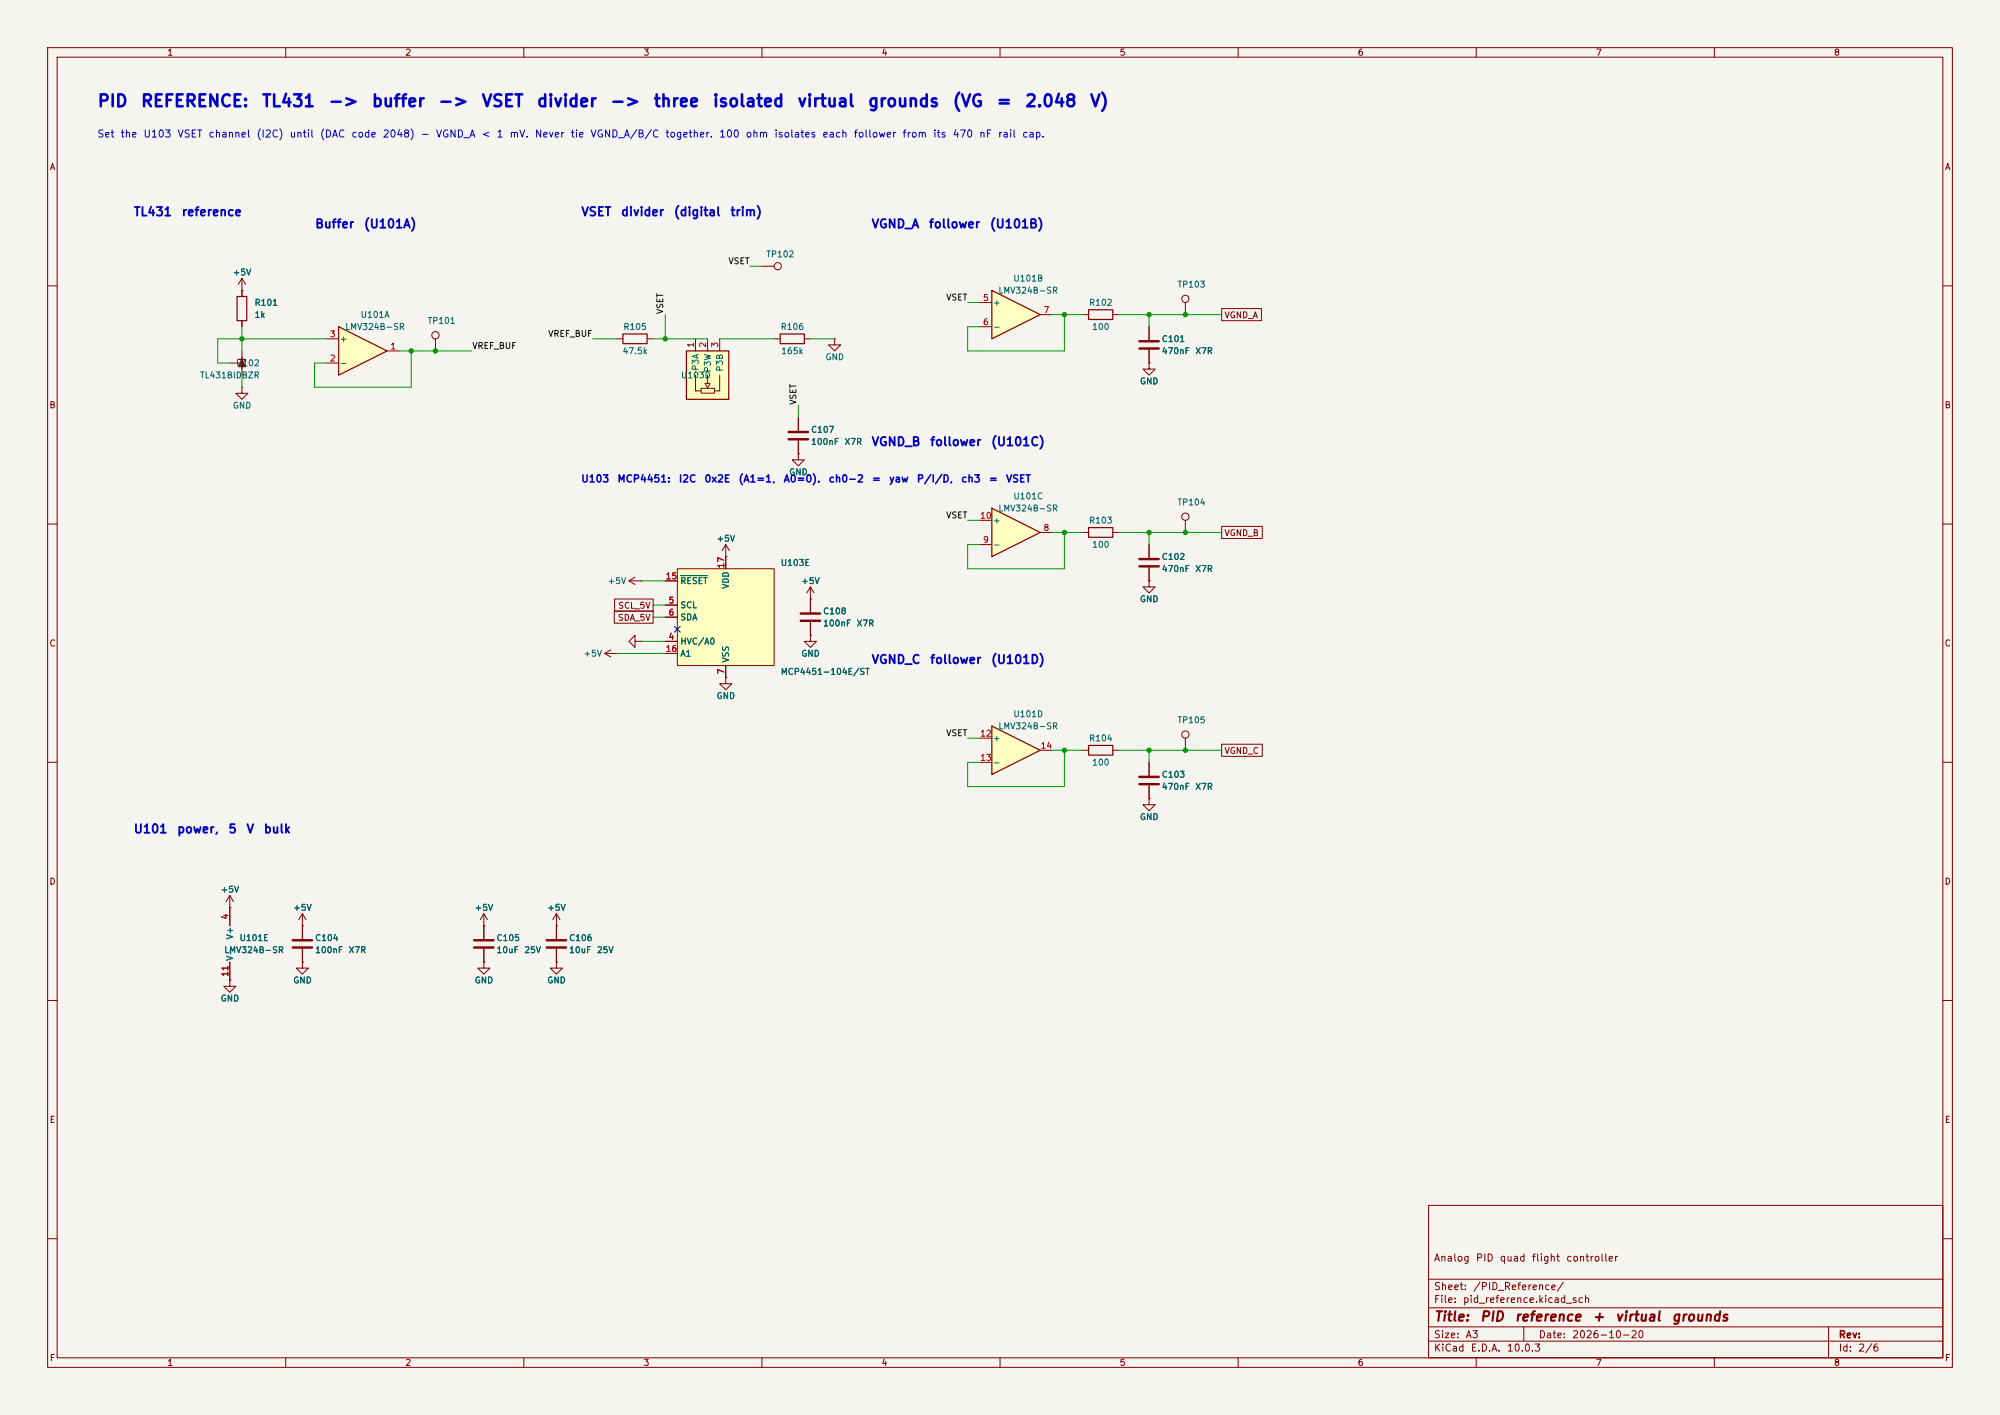
[picture p42: page 2]

PID REFERENCE: TL431 -> buffer -> VSET divider -> three isolated virtual grounds (VG = 2.048 V)

Set the U103 VSET channel (I2C) until (DAC code 2048) - VGND_A < 1 mV. Never tie VGND_A/B/C together. 100 ohm isolates each follower from its 470 nF rail cap.

VSET divider (digital trim)

Sheet: /PID_Reference/
File: pid_reference.kicad_sch
Title: PID reference + virtual grounds

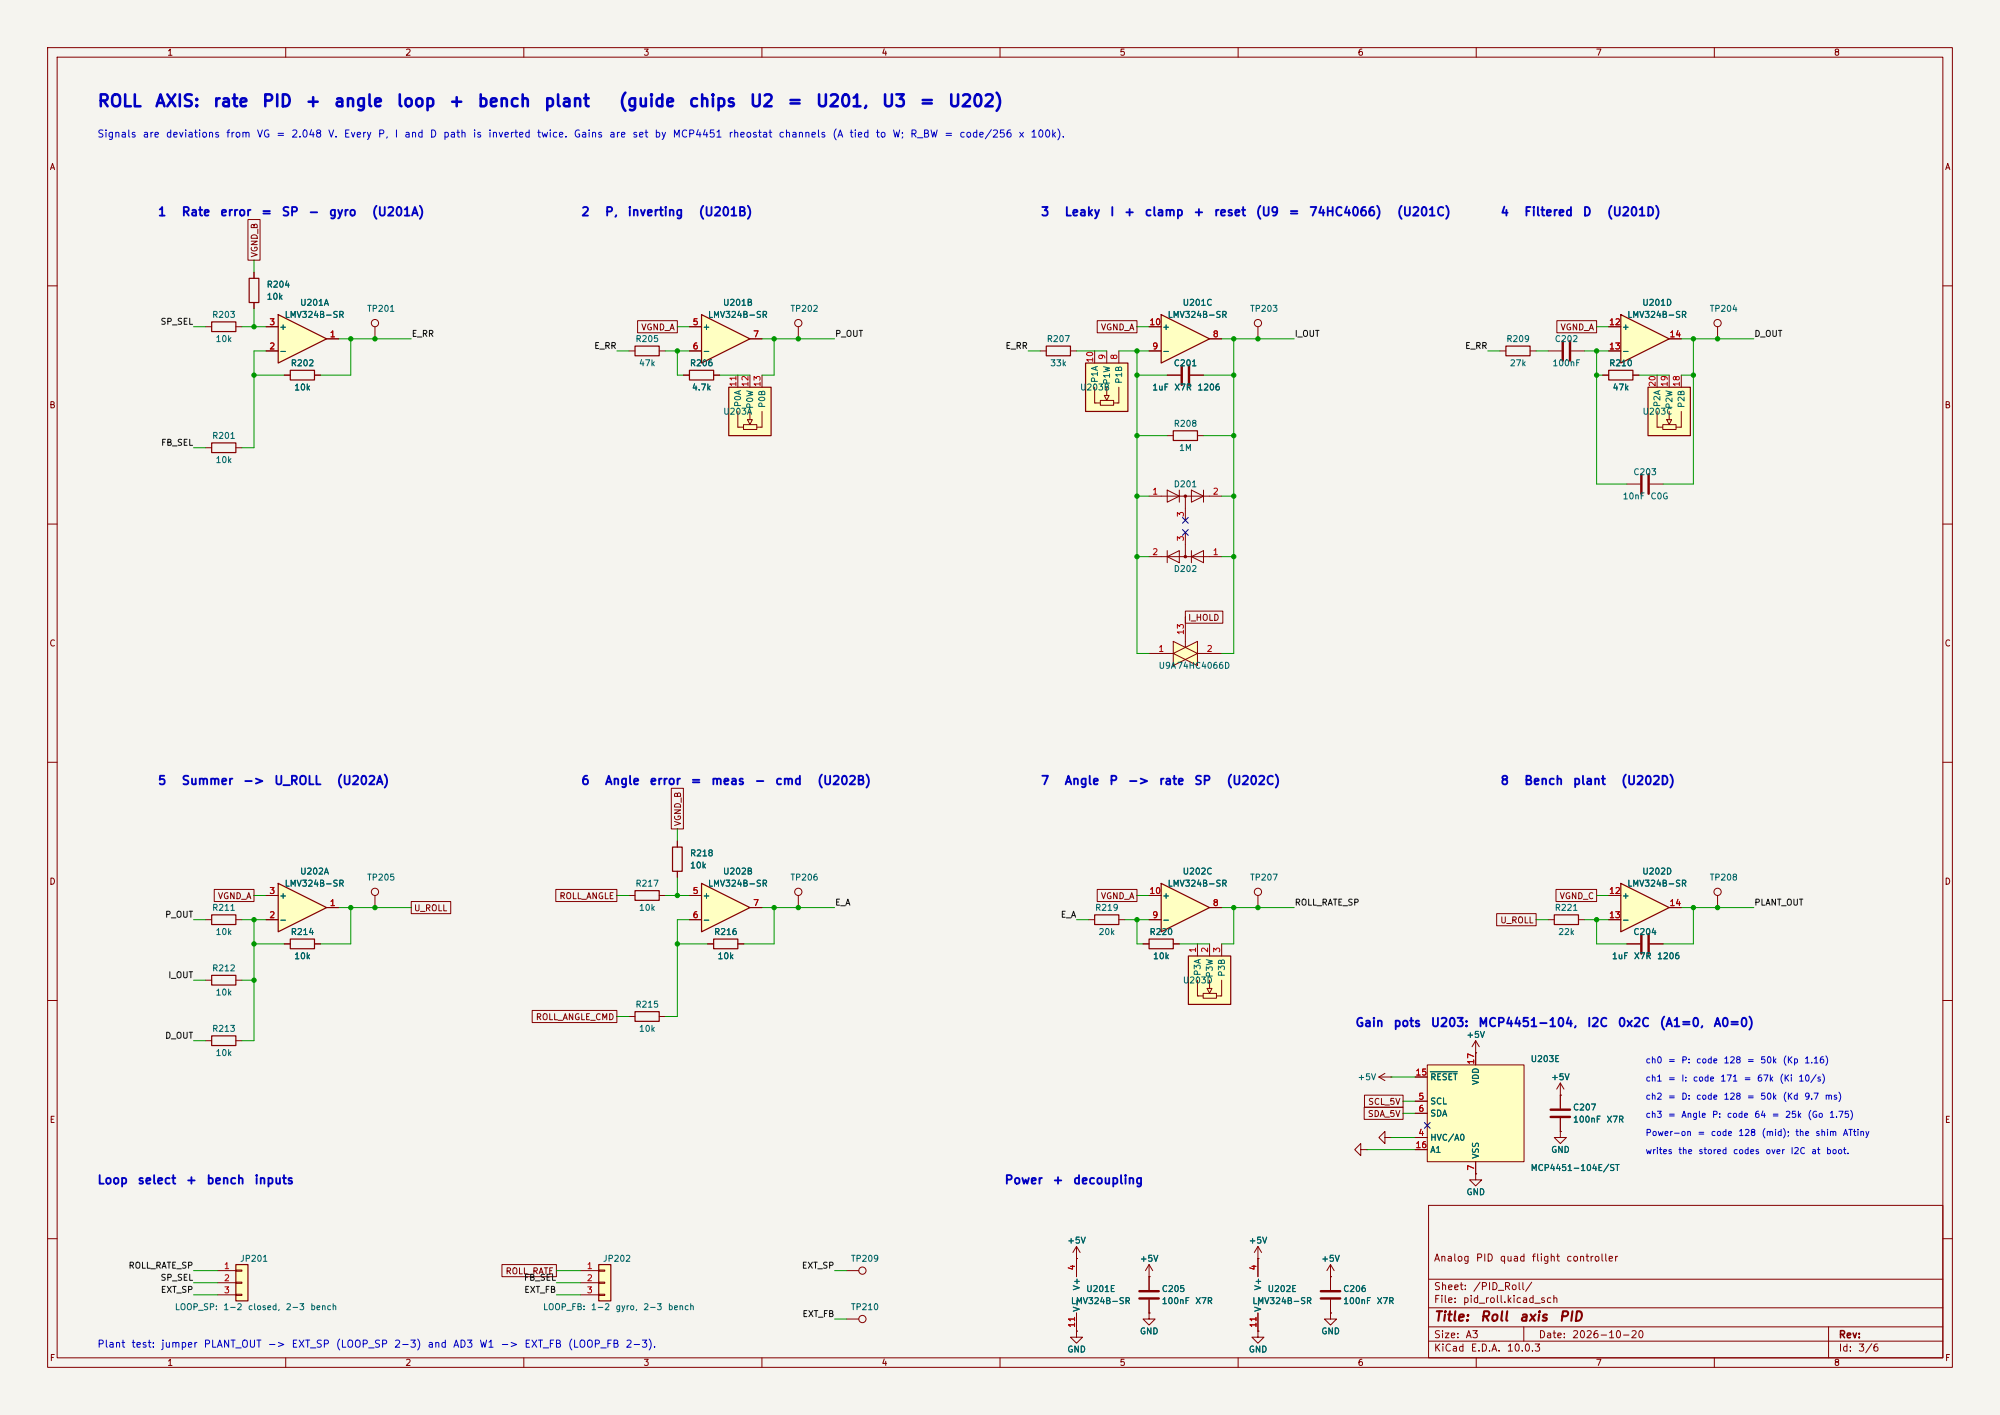
[picture p43: page 3]

6 Angle error = meas - cmd (U202B)

Loop select + bench inputs

Sheet: /PID_Roll/
File: pid_roll.kicad_sch
Title: Roll axis PID

Plant test: jumper PLANT_OUT -> EXT_SP (LOOP_SP 2-3) and AD3 W1 -> EXT_FB (LOOP_FB 2-3).

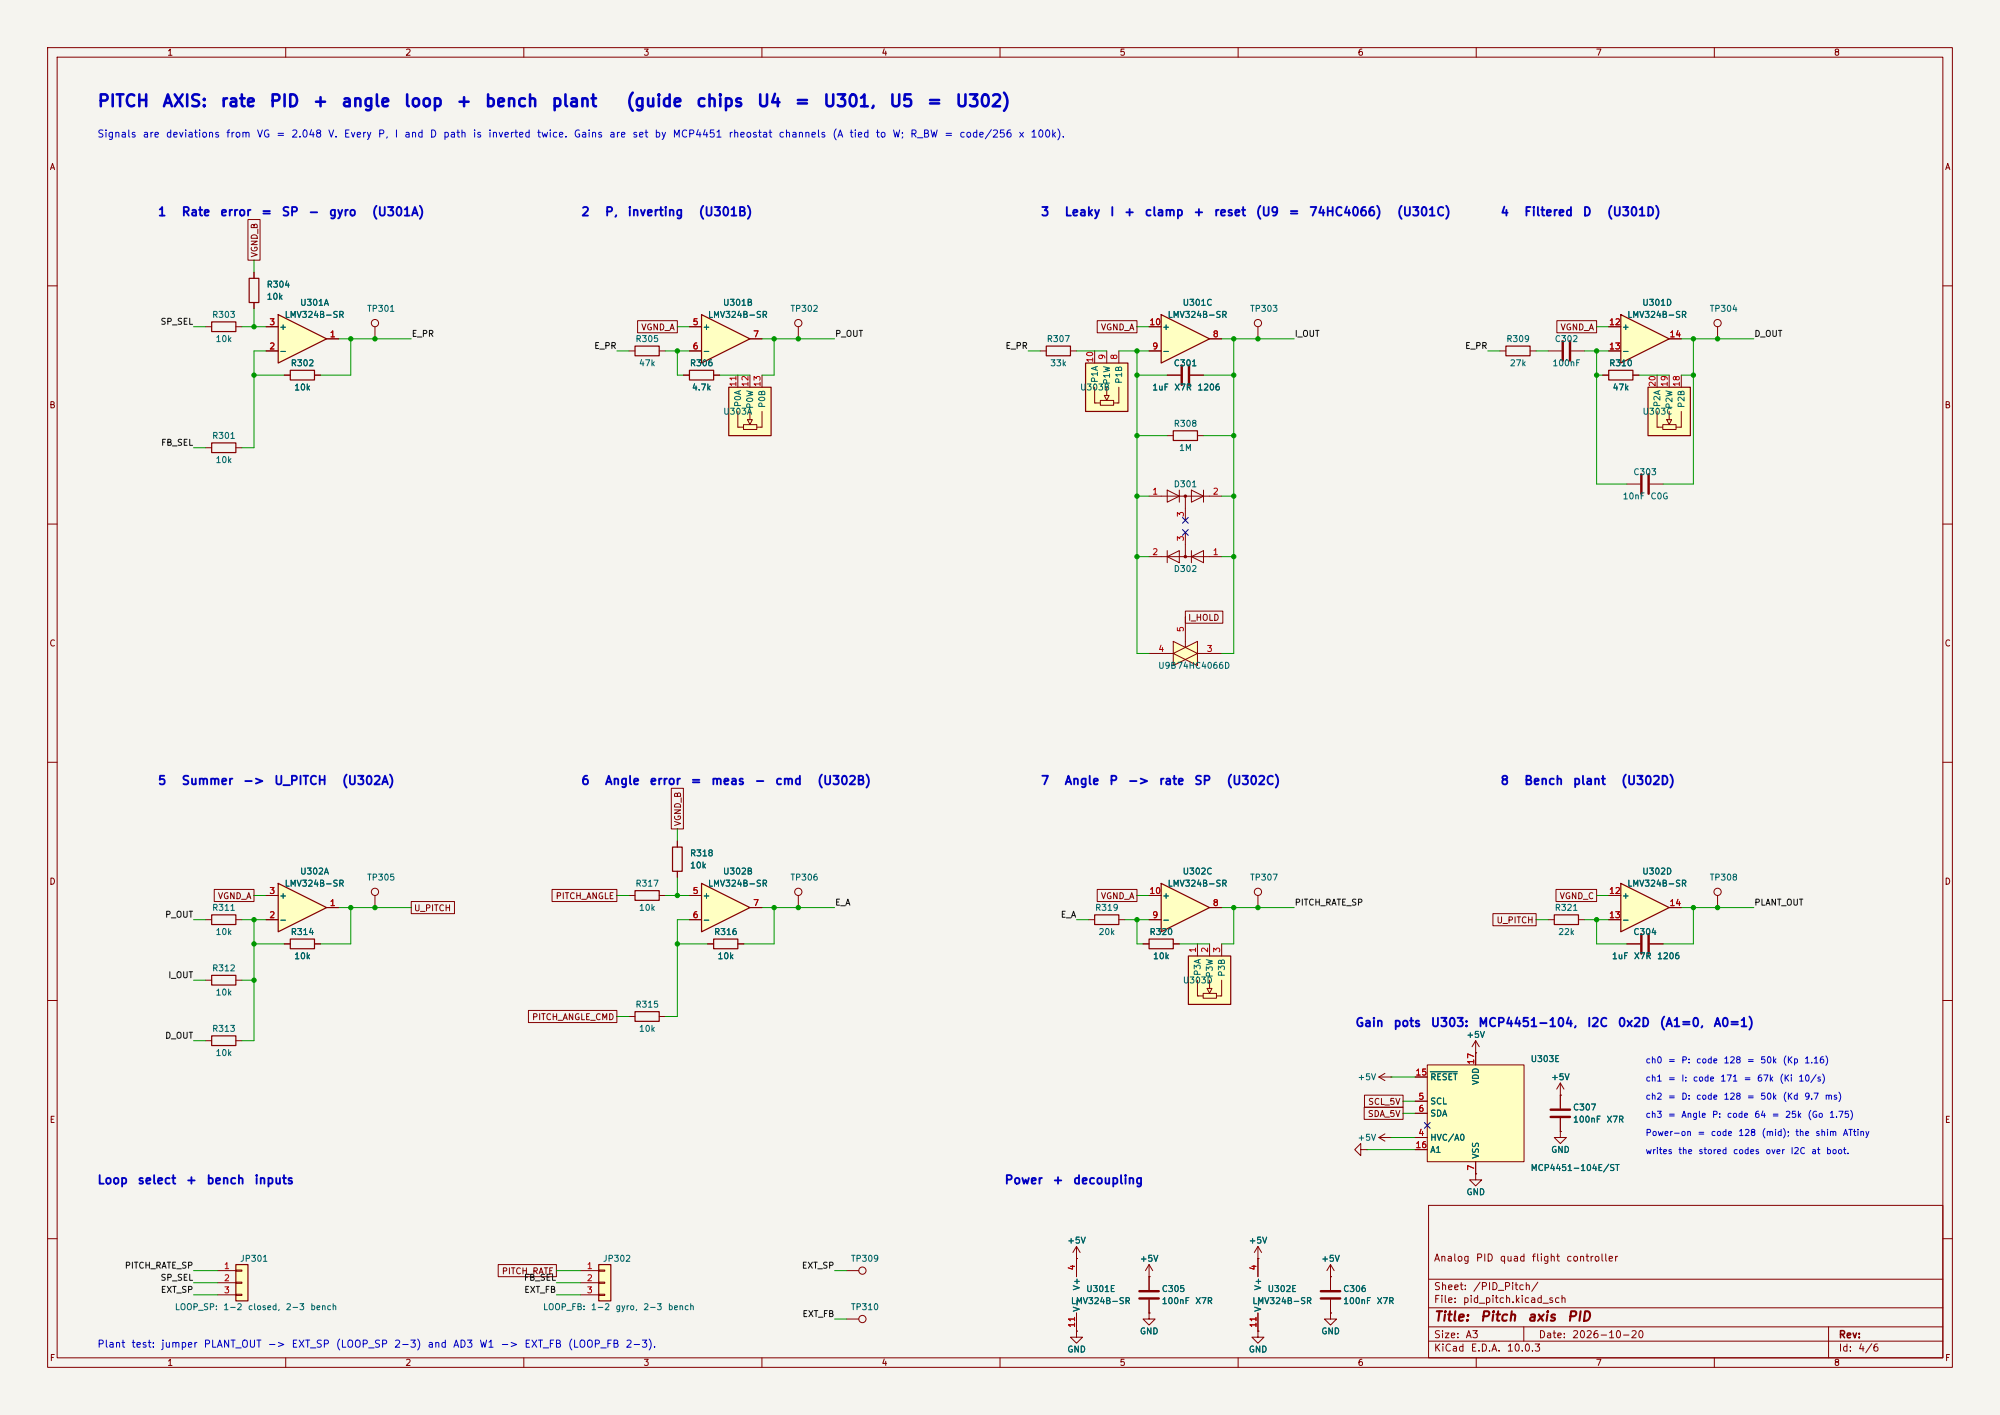
[picture p44: page 4]

PLANT_OUT ch1 = I: code 171 = 67k (Ki 10/s) ch2 = D: code 128 = 50k (Kd 9.7 ms) ch3 = Angle P: code 64 = 25k (Go 1.75) Power-on = code 128 (mid); the shim ATtiny writes the stored codes over I2C at boot. Gain pots U303: MCP4451-104, I2C 0x2D (A1=0, A0=1)

Loop select + bench inputs

Analog PID quad flight controller C305

Sheet: /PID_Pitch/
File: pid_pitch.kicad_sch
Title: Pitch axis PID

Plant test: jumper PLANT_OUT -> EXT_SP (LOOP_SP 2-3) and AD3 W1 -> EXT_FB (LOOP_FB 2-3).

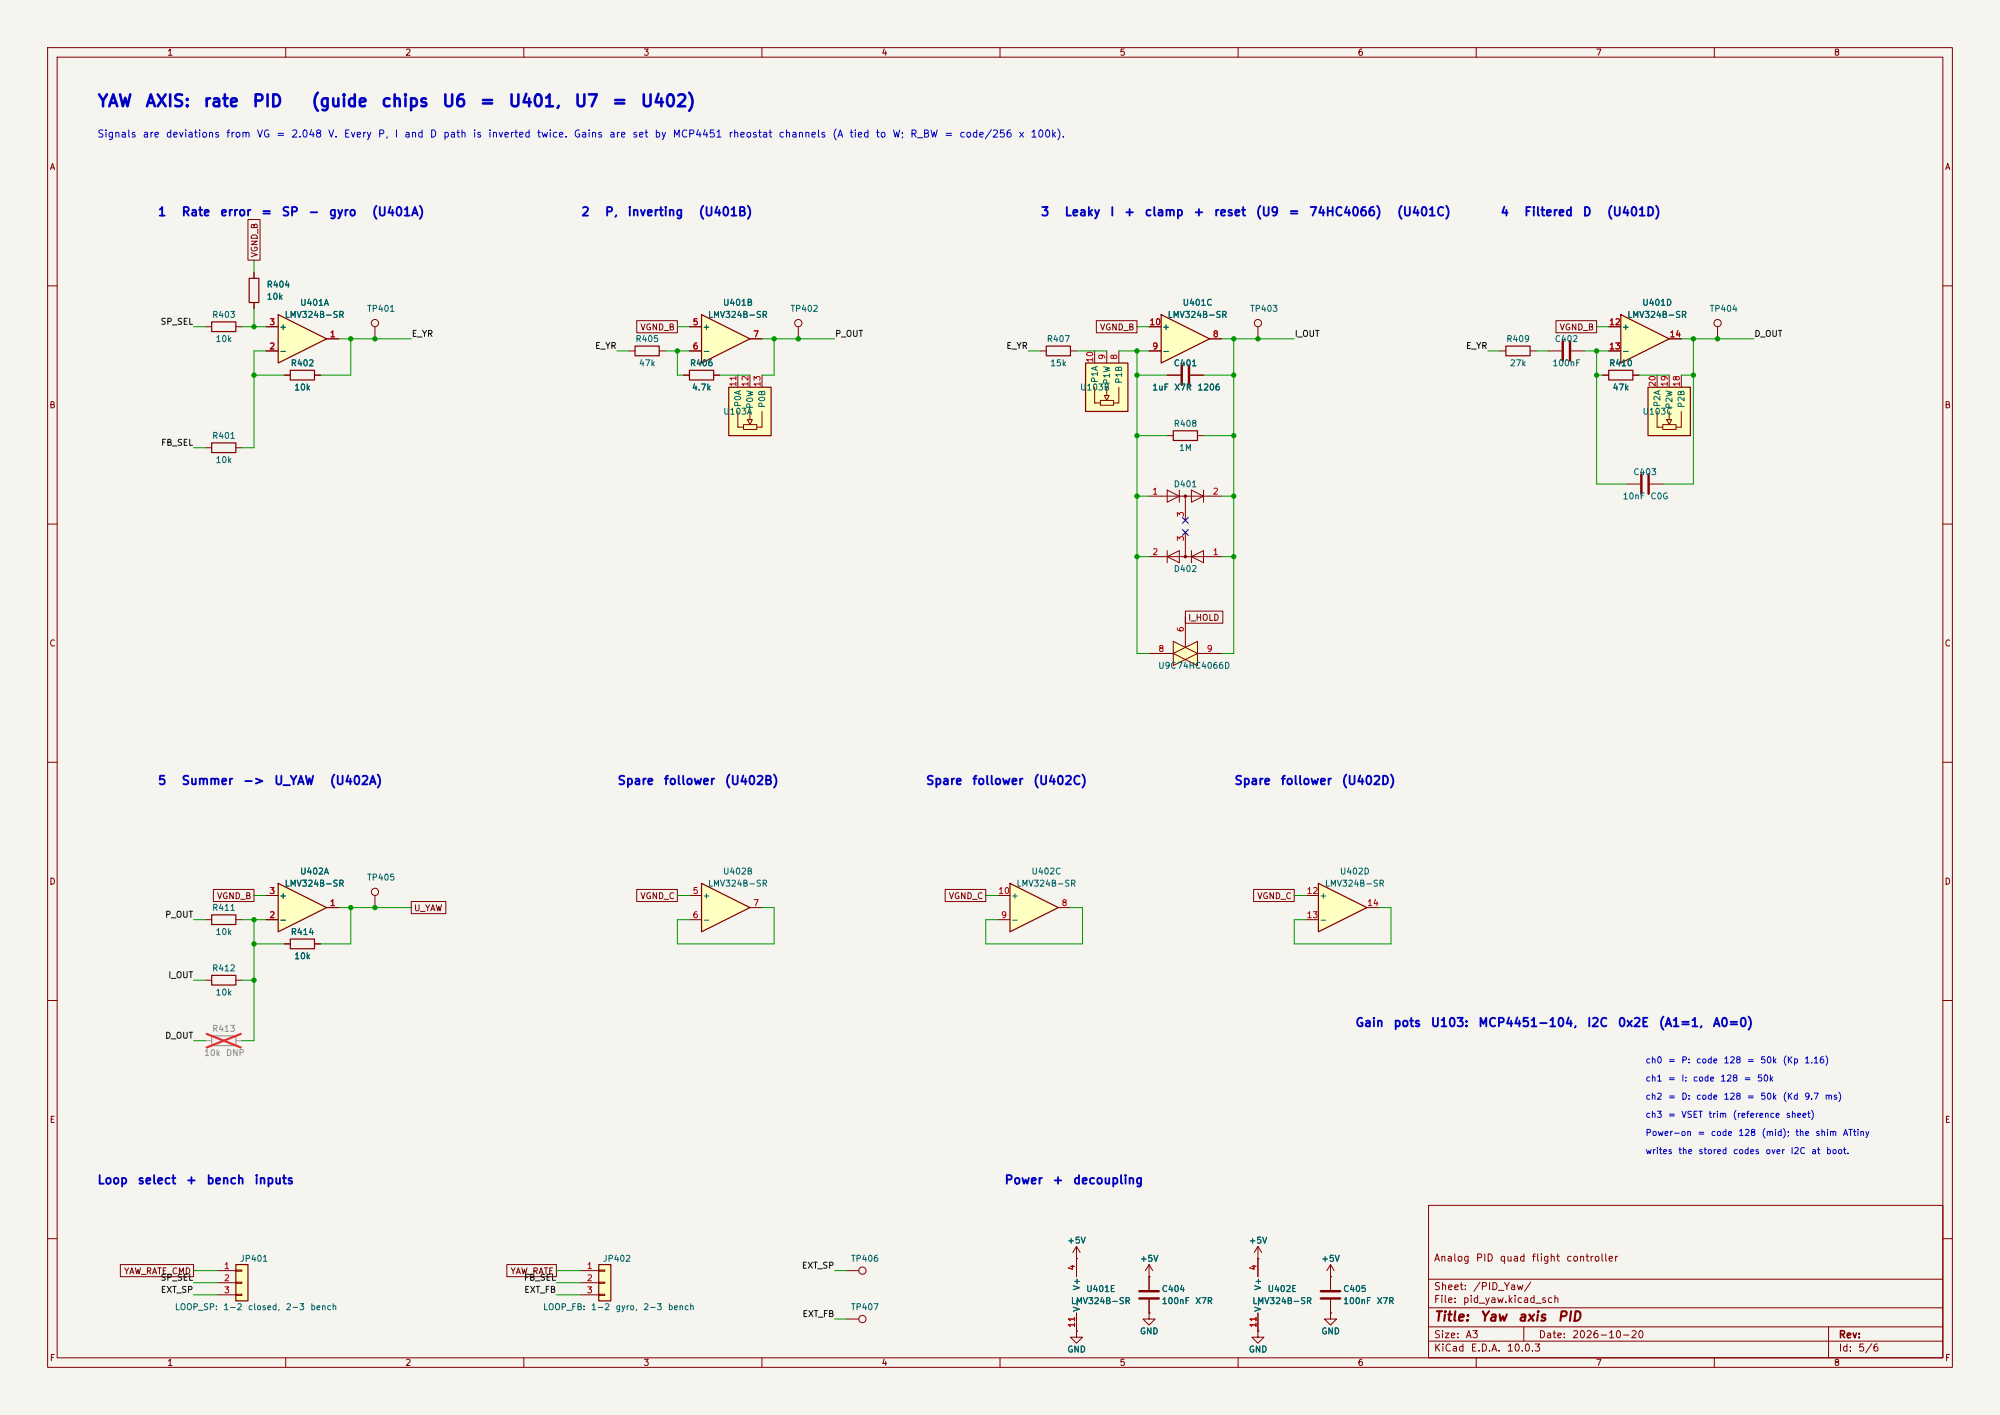
[picture p45: page 5]

writes the stored codes over I2C at boot. Power-on = code 128 (mid); the shim ATtiny ch3 = VSET trim (reference sheet) ch2 = D: code 128 = 50k (Kd 9.7 ms) ch1 = I: code 128 = 50k Spare follower (U402B)

Loop select + bench inputs

Analog PID quad flight controller

Sheet: /PID_Yaw/
File: pid_yaw.kicad_sch
Title: Yaw axis PID

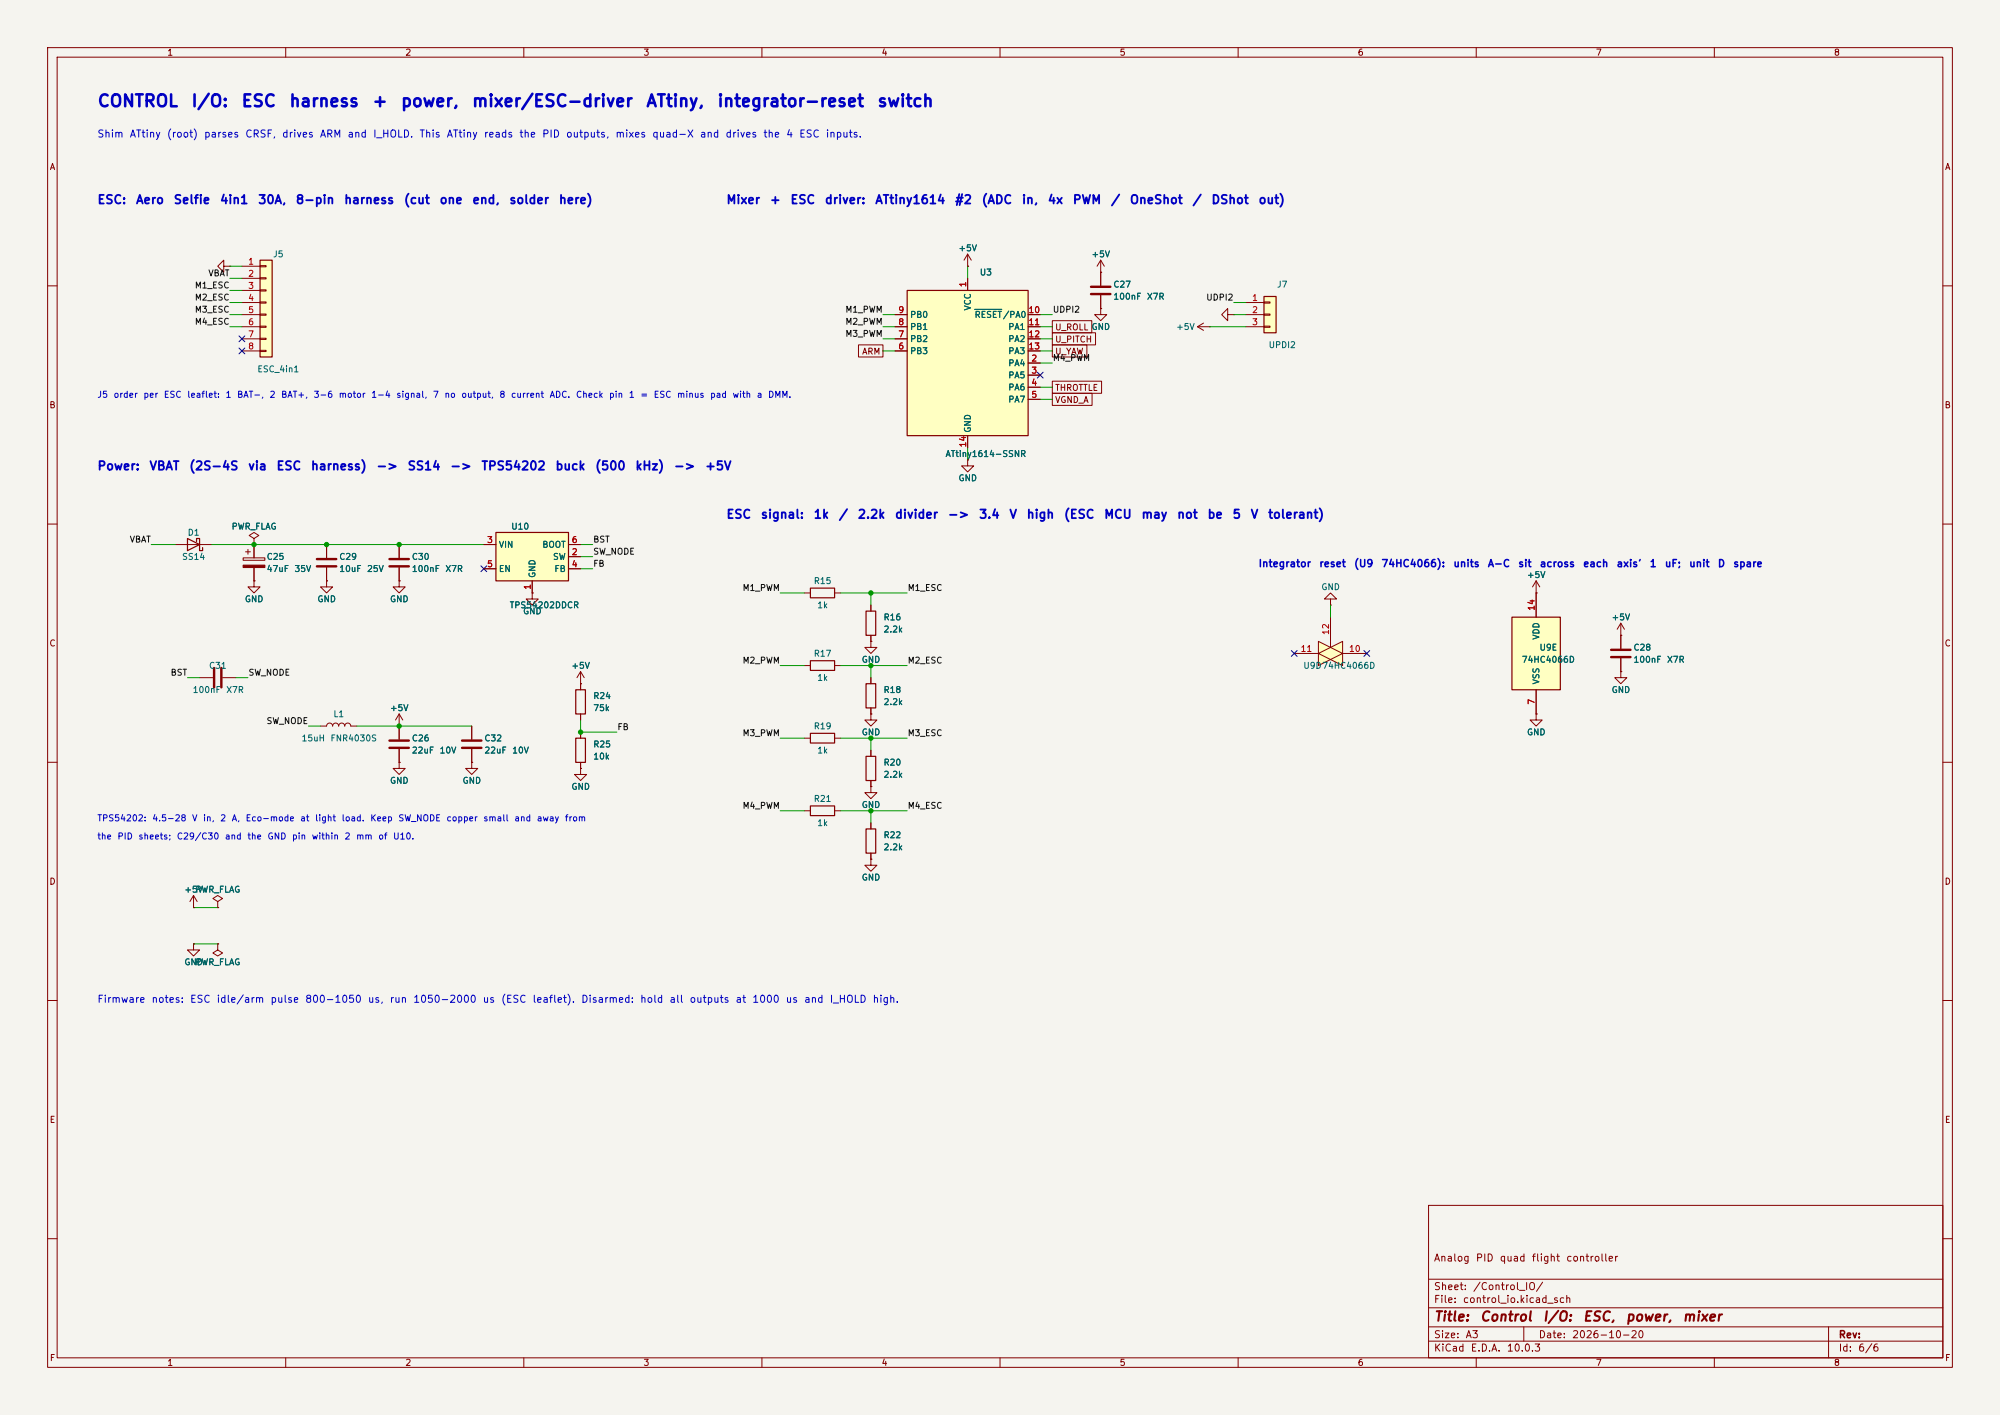
[picture p46: page 6]

CONTROL I/O: ESC harness + power, mixer/ESC-driver ATtiny, integrator-reset switch

M1_PWM ESC: Aero Selfie 4in1 30A, 8-pin harness (cut one end, solder here)

ESC signal: 1k / 2.2k divider -> 3.4 V high (ESC MCU may not be 5 V tolerant) +5VPWR_FLAG

Integrator reset (U9 74HC4066): units A-C sit across each axis' 1 uF; unit D spare

Analog PID quad flight controller

Sheet: /Control_IO/
File: control_io.kicad_sch
Title: Control I/O: ESC, power, mixer
