AaronDoubert/quadcopter-pid-boards/PID_Board/PID_Board.kicad_pcb

## KiCad design PID_Board/PID_Board.kicad_pcb (2026-10-26)

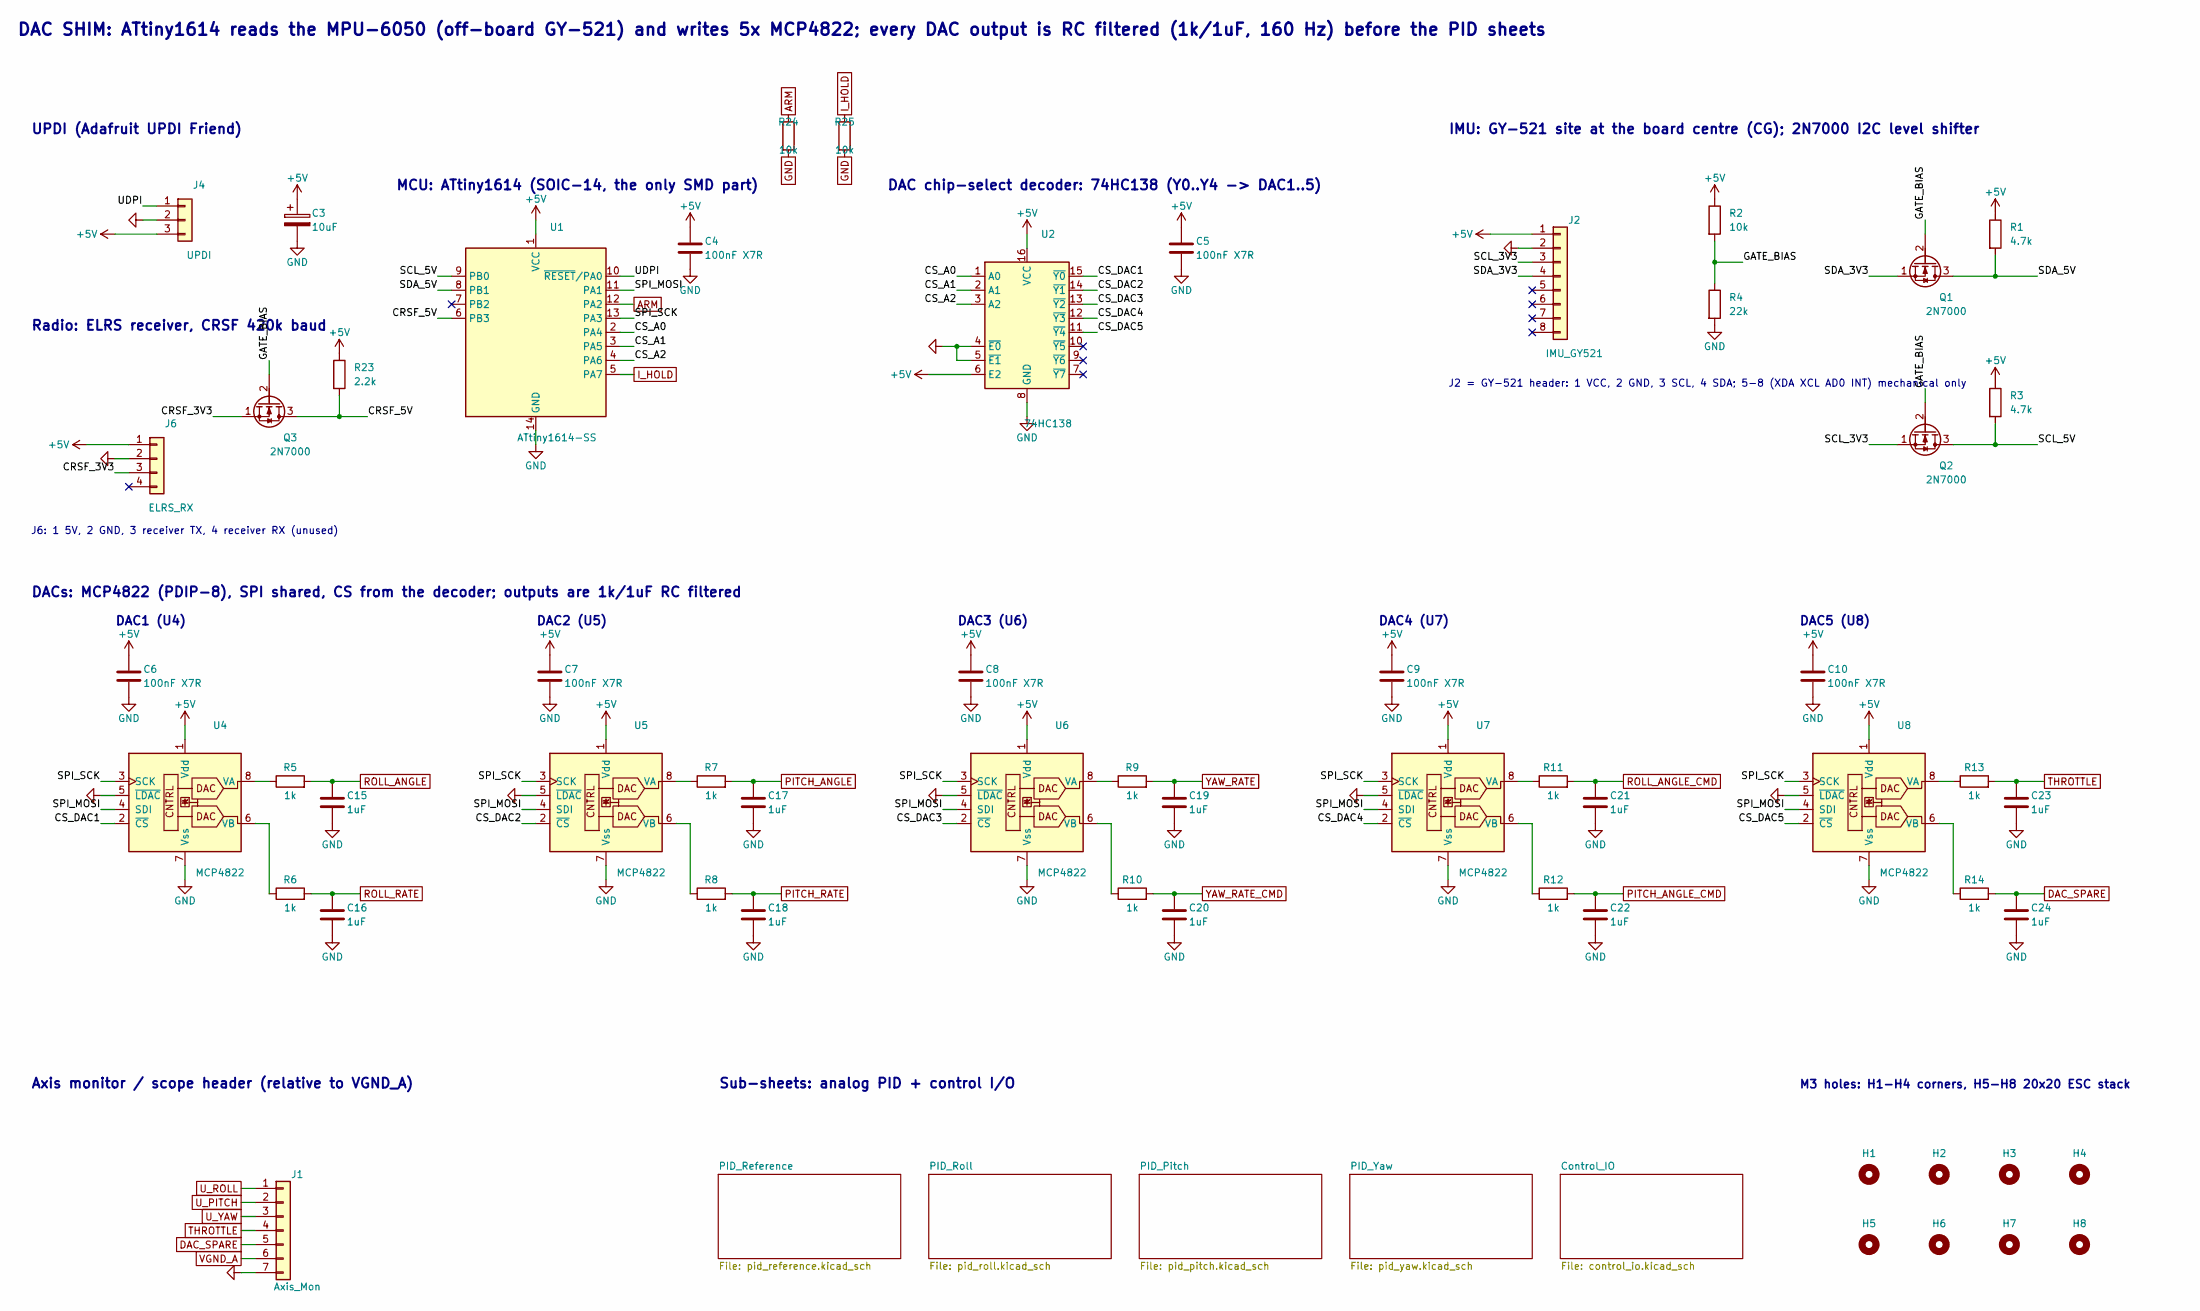
[picture p47: schematic PID_Board.kicad_sch, Quad flight controller: DAC shim + analog PID]

Parts:
C3: 10uF; CP_Radial_D5.0mm_P2.00mm
C4, C5, C6, C7, C8, C9, C10: 100nF X7R; C_Disc_D5.0mm_W2.5mm_P5.00mm
C15, C16, C17, C18, C19, C20, C21, C22, C23, C24: 1uF; C_Disc_D5.0mm_W2.5mm_P5.00mm
H1, H2, H3, H4, H5, H6, H7, H8: MountingHole; MountingHole_3.2mm_M3
J1: Axis_Mon; PinHeader_1x07_P2.54mm_Vertical
J2: IMU_GY521; PinHeader_1x08_P2.54mm_Vertical
J4: UPDI; PinHeader_1x03_P2.54mm_Vertical
J6: ELRS_RX; PinHeader_1x04_P2.54mm_Vertical
Q1, Q2, Q3: 2N7000; TO-92_Inline_Wide
R1, R3: 4.7k; R_Axial_DIN0207_L6.3mm_D2.5mm_P7.62mm_Horizontal
R2, R24, R25: 10k; R_Axial_DIN0207_L6.3mm_D2.5mm_P7.62mm_Horizontal
R4: 22k; R_Axial_DIN0207_L6.3mm_D2.5mm_P7.62mm_Horizontal
R5, R6, R7, R8, R9, R10, R11, R12, R13, R14: 1k; R_Axial_DIN0207_L6.3mm_D2.5mm_P7.62mm_Horizontal
R23: 2.2k; R_Axial_DIN0207_L6.3mm_D2.5mm_P7.62mm_Horizontal
U1: ATtiny1614-SS; SOIC-14_3.9x8.7mm_P1.27mm
U2: 74HC138; DIP-16_W7.62mm
U4, U5, U6, U7, U8: MCP4822; DIP-8_W7.62mm

Connections:
+5V: C3.1, C4.1, C5.1, C6.1, C7.1, C8.1, C9.1, C10.1, J2.1, J4.3, J6.1, R1.1, R2.1, R3.1, R23.1, U1.1 (VCC), U2.6 (E2), U2.16 (VCC), U4.1 (Vdd), U5.1 (Vdd), U6.1 (Vdd), U7.1 (Vdd), U8.1 (Vdd); also elsewhere on the board
/CRSF_3V3: J6.3, Q3.1 (S)
/CRSF_5V: Q3.3 (D), R23.2, U1.6 (PB3)
/CS_A0: U1.2 (PA4), U2.1 (A0)
/CS_A1: U1.3 (PA5), U2.2 (A1)
/CS_A2: U1.4 (PA6), U2.3 (A2)
/CS_DAC1: U2.15 (~Y0), U4.2 (~CS)
/CS_DAC2: U2.14 (~Y1), U5.2 (~CS)
/CS_DAC3: U2.13 (~Y2), U6.2 (~CS)
/CS_DAC4: U2.12 (~Y3), U7.2 (~CS)
/CS_DAC5: U2.11 (~Y4), U8.2 (~CS)
/GATE_BIAS: Q1.2 (G), Q2.2 (G), Q3.2 (G), R2.2, R4.1
/SCL_3V3: J2.3, Q2.1 (S)
/SCL_5V: Q2.3 (D), R3.2, U1.9 (PB0)
/SDA_3V3: J2.4, Q1.1 (S)
/SDA_5V: Q1.3 (D), R1.2, U1.8 (PB1)
/SPI_MOSI: U1.11 (PA1), U4.4 (SDI), U5.4 (SDI), U6.4 (SDI), U7.4 (SDI), U8.4 (SDI)
/SPI_SCK: U1.13 (PA3), U4.3 (SCK), U5.3 (SCK), U6.3 (SCK), U7.3 (SCK), U8.3 (SCK)
/UDPI: J4.1, U1.10 (~RESET/PA0)
ARM: R24.1, U1.12 (PA2); also elsewhere on the board
DAC_SPARE: C24.1, J1.5, R14.2
GND: C3.2, C4.2, C5.2, C6.2, C7.2, C8.2, C9.2, C10.2, C15.2, C16.2, C17.2, C18.2, C19.2, C20.2, C21.2, C22.2, C23.2, C24.2, J1.7, J2.2, J4.2, J6.2, R4.2, R24.2, R25.2, U1.14 (GND), U2.4 (~E0), U2.5 (~E1), U2.8 (GND), U4.5 (~LDAC), U4.7 (Vss), U5.5 (~LDAC), U5.7 (Vss), U6.5 (~LDAC), U6.7 (Vss), U7.5 (~LDAC), U7.7 (Vss), U8.5 (~LDAC), U8.7 (Vss); also elsewhere on the board
I_HOLD: R25.1, U1.5 (PA7); also elsewhere on the board
unnamed: R5.1, U4.8 (VA)
unnamed: R6.1, U4.6 (VB)
unnamed: R7.1, U5.8 (VA)
unnamed: R8.1, U5.6 (VB)
unnamed: R9.1, U6.8 (VA)
unnamed: R10.1, U6.6 (VB)
unnamed: R11.1, U7.8 (VA)
unnamed: R12.1, U7.6 (VB)
unnamed: R13.1, U8.8 (VA)
unnamed: R14.1, U8.6 (VB)
PITCH_ANGLE: C17.1, R7.2; also elsewhere on the board
PITCH_ANGLE_CMD: C22.1, R12.2; also elsewhere on the board
PITCH_RATE: C18.1, R8.2; also elsewhere on the board
ROLL_ANGLE: C15.1, R5.2; also elsewhere on the board
ROLL_ANGLE_CMD: C21.1, R11.2; also elsewhere on the board
ROLL_RATE: C16.1, R6.2; also elsewhere on the board
THROTTLE: C23.1, J1.4, R13.2; also elsewhere on the board
U_PITCH: J1.2; also elsewhere on the board
U_ROLL: J1.1; also elsewhere on the board
U_YAW: J1.3; also elsewhere on the board
VGND_A: J1.6; also elsewhere on the board
YAW_RATE: C19.1, R9.2; also elsewhere on the board
YAW_RATE_CMD: C20.1, R10.2; also elsewhere on the board

Notes on the sheet:
DAC SHIM: ATtiny1614 reads the MPU-6050 (off-board GY-521) and writes 5x MCP4822; every DAC output is RC filtered (1k/1uF, 160 Hz) before the PID sheets
UPDI (Adafruit UPDI Friend)
Radio: ELRS receiver, CRSF 420k baud
J6: 1 5V, 2 GND, 3 receiver TX, 4 receiver RX (unused)
MCU: ATtiny1614 (SOIC-14, the only SMD part)
DAC chip-select decoder: 74HC138 (Y0..Y4 -> DAC1..5)
IMU: GY-521 site at the board centre (CG); 2N7000 I2C level shifter
J2 = GY-521 header: 1 VCC, 2 GND, 3 SCL, 4 SDA; 5-8 (XDA XCL AD0 INT) mechanical only
DACs: MCP4822 (PDIP-8), SPI shared, CS from the decoder; outputs are 1k/1uF RC filtered
DAC1 (U4)
DAC2 (U5)
DAC3 (U6)
DAC4 (U7)
DAC5 (U8)
Axis monitor / scope header (relative to VGND_A)
M3 holes: H1-H4 corners, H5-H8 20x20 ESC stack
Sub-sheets: analog PID + control I/O

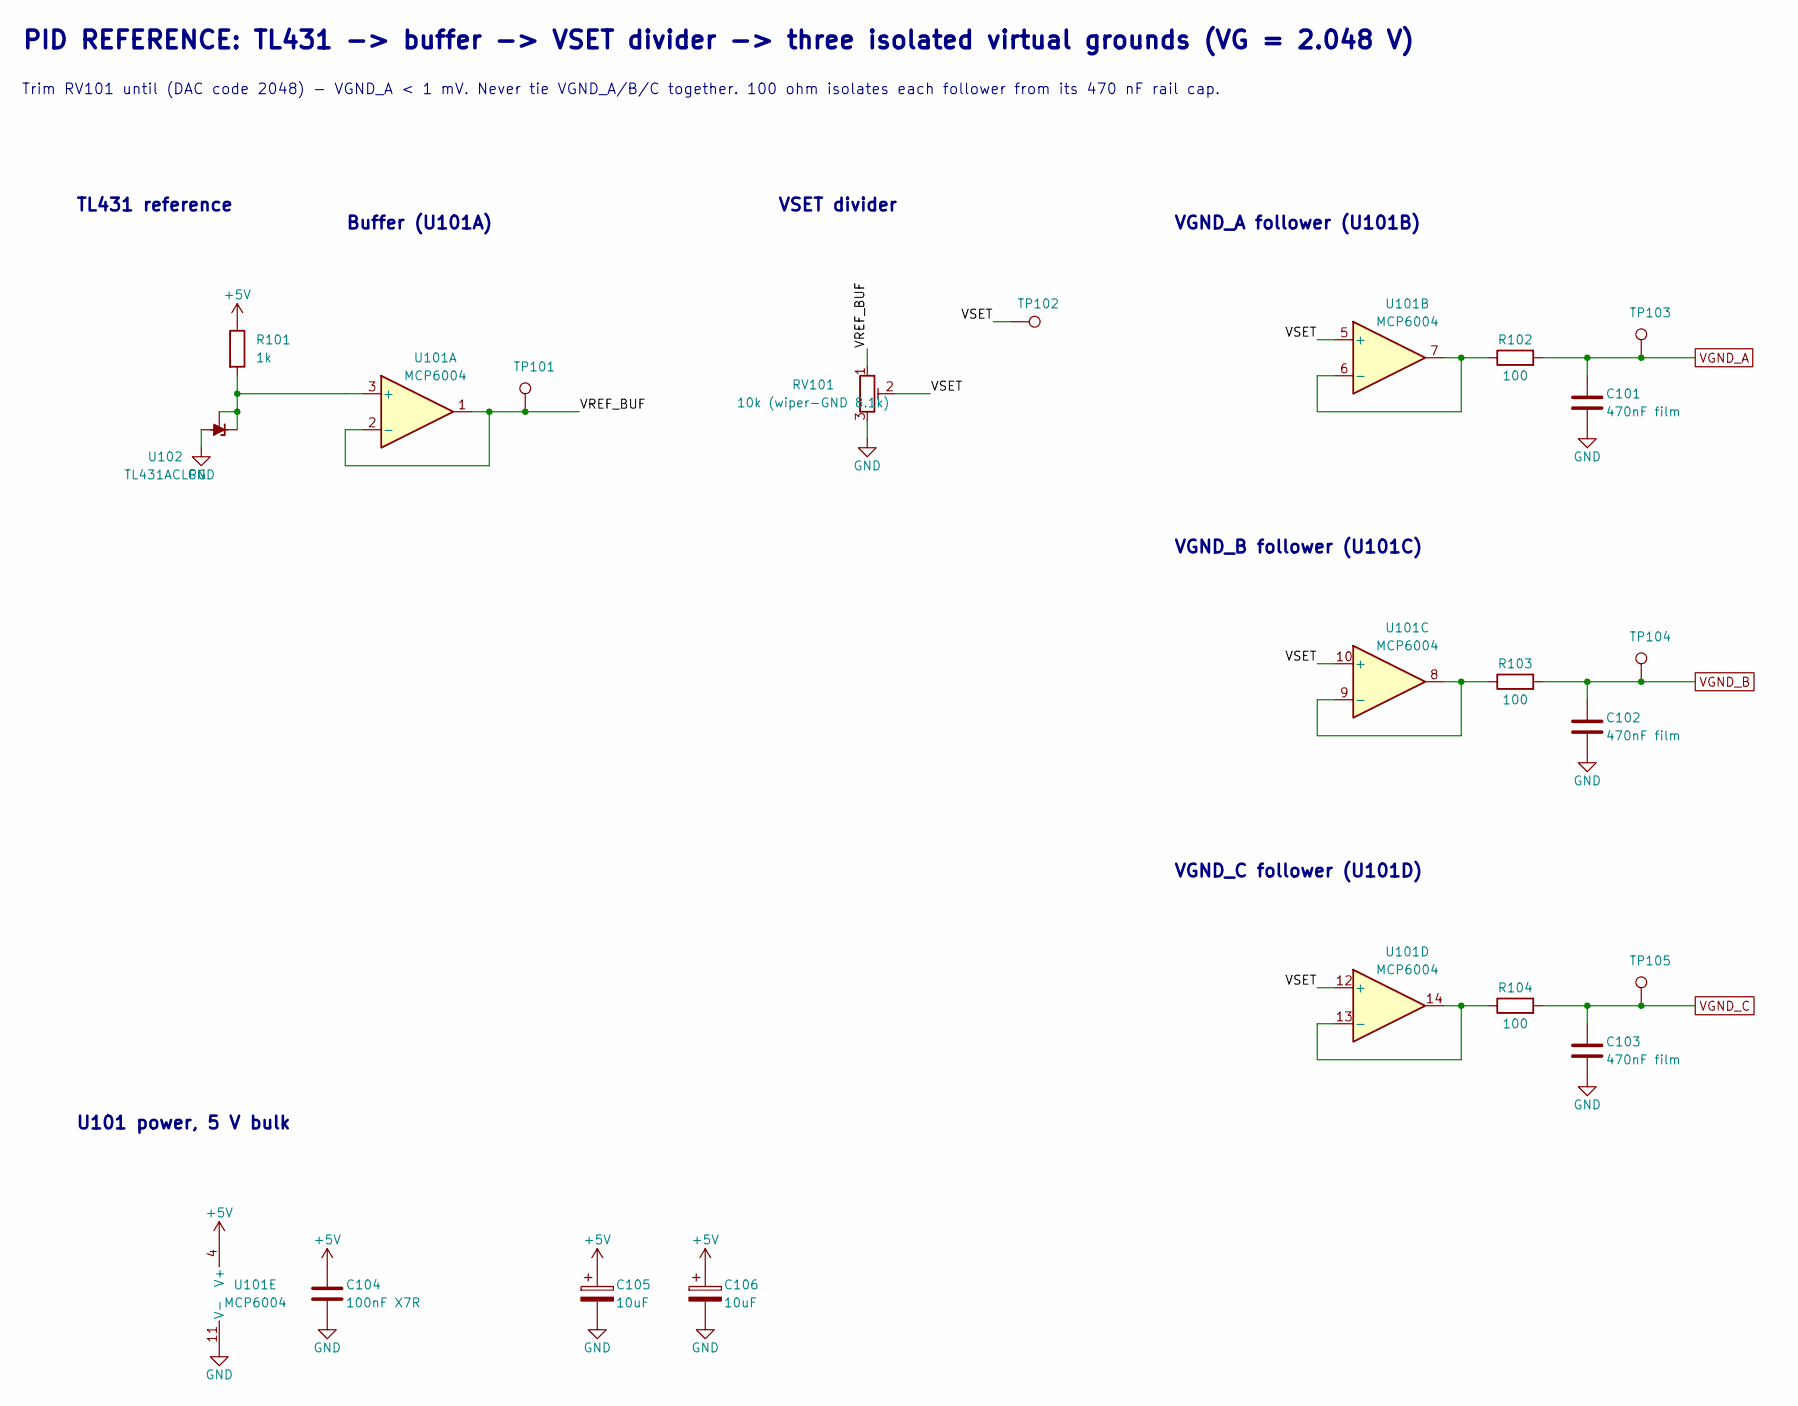
[picture p48: schematic pid_reference.kicad_sch, PID reference + virtual grounds]

Parts:
C101, C102, C103: 470nF film; C_Rect_L7.2mm_W4.5mm_P5.00mm_FKS2_FKP2_MKS2_MKP2
C104: 100nF X7R; C_Disc_D5.0mm_W2.5mm_P5.00mm
C105, C106: 10uF; CP_Radial_D5.0mm_P2.00mm
R101: 1k; R_Axial_DIN0207_L6.3mm_D2.5mm_P7.62mm_Horizontal
R102, R103, R104: 100; R_Axial_DIN0207_L6.3mm_D2.5mm_P7.62mm_Horizontal
RV101: 10k (wiper-GND 8.1k); Potentiometer_Bourns_3296W_Vertical
TP101: VREF_BUF; PinHeader_1x01_P2.54mm_Vertical
TP102: VSET; PinHeader_1x01_P2.54mm_Vertical
TP103: VGND_A; PinHeader_1x01_P2.54mm_Vertical
TP104: VGND_B; PinHeader_1x01_P2.54mm_Vertical
TP105: VGND_C; PinHeader_1x01_P2.54mm_Vertical
U101: MCP6004; DIP-14_W7.62mm
U102: TL431ACLPG; TO-92_Inline_Wide

Connections:
+5V: C104.1, C105.1, C106.1, R101.1, U101.4 (V+); also elsewhere on the board
/PID_Reference/VREF_BUF: RV101.1, TP101.1, U101.1, U101.2 (-)
/PID_Reference/VSET: RV101.2, TP102.1, U101.5 (+), U101.10 (+), U101.12 (+)
GND: C101.2, C102.2, C103.2, C104.2, C105.2, C106.2, RV101.3, U101.11 (V-), U102.2 (A); also elsewhere on the board
unnamed: R101.2, U101.3 (+), U102.1 (REF), U102.3 (K)
unnamed: R102.1, U101.6 (-), U101.7
unnamed: R103.1, U101.8, U101.9 (-)
unnamed: R104.1, U101.13 (-), U101.14
VGND_A: C101.1, R102.2, TP103.1; also elsewhere on the board
VGND_B: C102.1, R103.2, TP104.1; also elsewhere on the board
VGND_C: C103.1, R104.2, TP105.1; also elsewhere on the board

Notes on the sheet:
PID REFERENCE: TL431 -> buffer -> VSET divider -> three isolated virtual grounds (VG = 2.048 V)
Trim RV101 until (DAC code 2048) - VGND_A < 1 mV. Never tie VGND_A/B/C together. 100 ohm isolates each follower from its 470 nF rail cap.
TL431 reference
Buffer (U101A)
VSET divider
VGND_A follower (U101B)
VGND_B follower (U101C)
VGND_C follower (U101D)
U101 power, 5 V bulk

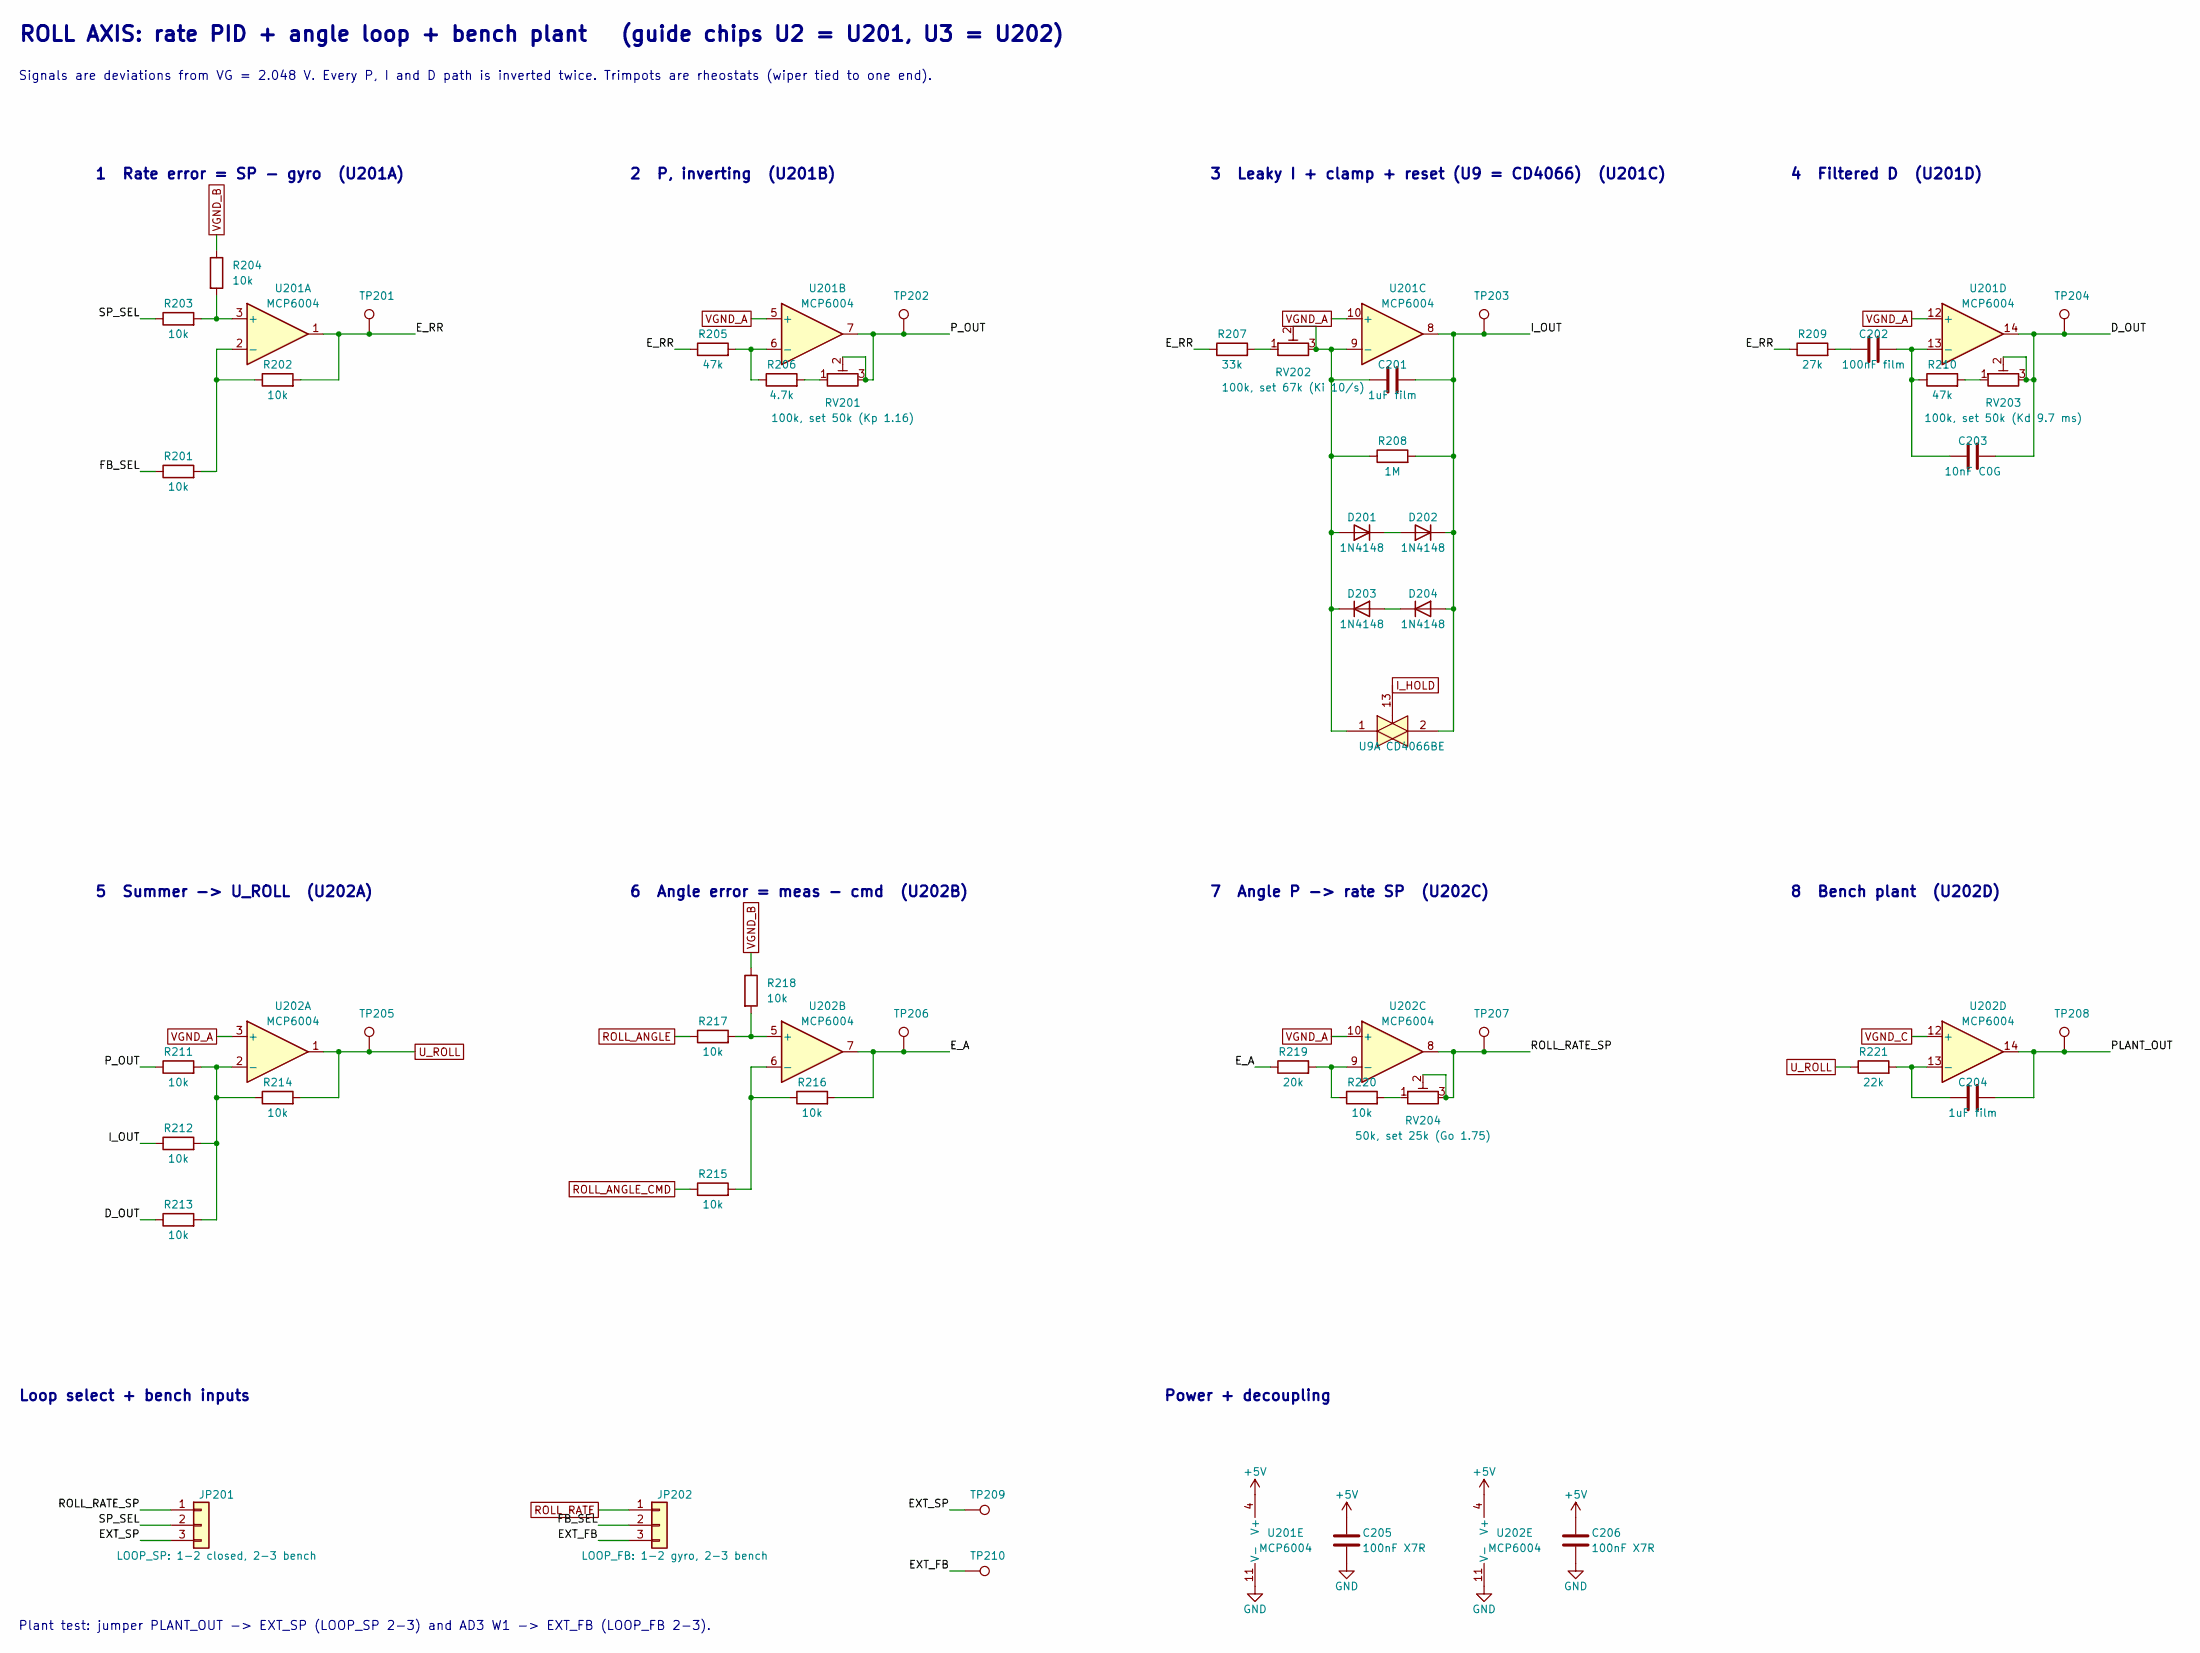
[picture p49: schematic pid_roll.kicad_sch, Roll axis PID]

Parts:
C201, C204: 1uF film; C_Rect_L7.2mm_W5.5mm_P5.00mm_FKS2_FKP2_MKS2_MKP2
C202: 100nF film; C_Rect_L7.2mm_W2.5mm_P5.00mm_FKS2_FKP2_MKS2_MKP2
C203: 10nF C0G; C_Disc_D5.0mm_W2.5mm_P5.00mm
C205, C206: 100nF X7R; C_Disc_D5.0mm_W2.5mm_P5.00mm
D201, D202, D203, D204: 1N4148; D_DO-35_SOD27_P7.62mm_Horizontal
JP201: LOOP_SP: 1-2 closed, 2-3 bench; PinHeader_1x03_P2.54mm_Vertical
JP202: LOOP_FB: 1-2 gyro, 2-3 bench; PinHeader_1x03_P2.54mm_Vertical
R201, R202, R203, R204, R211, R212, R213, R214, R215, R216, R217, R218, R220: 10k; R_Axial_DIN0207_L6.3mm_D2.5mm_P7.62mm_Horizontal
R205, R210: 47k; R_Axial_DIN0207_L6.3mm_D2.5mm_P7.62mm_Horizontal
R206: 4.7k; R_Axial_DIN0207_L6.3mm_D2.5mm_P7.62mm_Horizontal
R207: 33k; R_Axial_DIN0207_L6.3mm_D2.5mm_P7.62mm_Horizontal
R208: 1M; R_Axial_DIN0207_L6.3mm_D2.5mm_P7.62mm_Horizontal
R209: 27k; R_Axial_DIN0207_L6.3mm_D2.5mm_P7.62mm_Horizontal
R219: 20k; R_Axial_DIN0207_L6.3mm_D2.5mm_P7.62mm_Horizontal
R221: 22k; R_Axial_DIN0207_L6.3mm_D2.5mm_P7.62mm_Horizontal
RV201: 100k, set 50k (Kp 1.16); Potentiometer_Bourns_3296W_Vertical
RV202: 100k, set 67k (Ki 10/s); Potentiometer_Bourns_3296W_Vertical
RV203: 100k, set 50k (Kd 9.7 ms); Potentiometer_Bourns_3296W_Vertical
RV204: 50k, set 25k (Go 1.75); Potentiometer_Bourns_3296W_Vertical
TP201: E_RR; PinHeader_1x01_P2.54mm_Vertical
TP202: P_OUT; PinHeader_1x01_P2.54mm_Vertical
TP203: I_OUT; PinHeader_1x01_P2.54mm_Vertical
TP204: D_OUT; PinHeader_1x01_P2.54mm_Vertical
TP205: U_ROLL; PinHeader_1x01_P2.54mm_Vertical
TP206: E_A; PinHeader_1x01_P2.54mm_Vertical
TP207: ROLL_RATE_SP; PinHeader_1x01_P2.54mm_Vertical
TP208: PLANT_OUT; PinHeader_1x01_P2.54mm_Vertical
TP209: EXT_SP; PinHeader_1x01_P2.54mm_Vertical
TP210: EXT_FB; PinHeader_1x01_P2.54mm_Vertical
U9: CD4066BE; DIP-14_W7.62mm
U201, U202: MCP6004; DIP-14_W7.62mm

Connections:
+5V: C205.1, C206.1, U201.4 (V+), U202.4 (V+); also elsewhere on the board
/PID_Roll/D_OUT: C203.2, R213.1, RV203.2, RV203.3, TP204.1, U201.14
/PID_Roll/EXT_FB: JP202.3, TP210.1
/PID_Roll/EXT_SP: JP201.3, TP209.1
/PID_Roll/E_A: R216.2, R219.1, TP206.1, U202.7
/PID_Roll/E_RR: R202.2, R205.1, R207.1, R209.1, TP201.1, U201.1
/PID_Roll/FB_SEL: JP202.2, R201.1
/PID_Roll/I_OUT: C201.2, D202.1 (K), D204.2 (A), R208.2, R212.1, TP203.1, U9.2, U201.8
/PID_Roll/PLANT_OUT: C204.2, TP208.1, U202.14
/PID_Roll/P_OUT: R211.1, RV201.2, RV201.3, TP202.1, U201.7
/PID_Roll/ROLL_RATE_SP: JP201.1, RV204.2, RV204.3, TP207.1, U202.8
/PID_Roll/SP_SEL: JP201.2, R203.1
GND: C205.2, C206.2, U201.11 (V-), U202.11 (V-); also elsewhere on the board
I_HOLD: U9.13; also elsewhere on the board
unnamed: C202.1, R209.2
unnamed: C201.1, D201.2 (A), D203.1 (K), R208.1, RV202.2, RV202.3, U9.1, U201.9 (-)
unnamed: D201.1 (K), D202.2 (A)
unnamed: D203.2 (A), D204.1 (K)
unnamed: R206.2, RV201.1
unnamed: R207.2, RV202.1
unnamed: R210.2, RV203.1
unnamed: R220.2, RV204.1
unnamed: R203.2, R204.2, U201.3 (+)
unnamed: R201.2, R202.1, U201.2 (-)
unnamed: R205.2, R206.1, U201.6 (-)
unnamed: C202.2, C203.1, R210.1, U201.13 (-)
unnamed: R211.2, R212.2, R213.2, R214.1, U202.2 (-)
unnamed: R217.2, R218.2, U202.5 (+)
unnamed: R215.2, R216.1, U202.6 (-)
unnamed: R219.2, R220.1, U202.9 (-)
unnamed: C204.1, R221.2, U202.13 (-)
ROLL_ANGLE: R217.1; also elsewhere on the board
ROLL_ANGLE_CMD: R215.1; also elsewhere on the board
ROLL_RATE: JP202.1; also elsewhere on the board
U_ROLL: R214.2, R221.1, TP205.1, U202.1; also elsewhere on the board
VGND_A: U201.5 (+), U201.10 (+), U201.12 (+), U202.3 (+), U202.10 (+); also elsewhere on the board
VGND_B: R204.1, R218.1; also elsewhere on the board
VGND_C: U202.12 (+); also elsewhere on the board

Notes on the sheet:
ROLL AXIS: rate PID + angle loop + bench plant (guide chips U2 = U201, U3 = U202)
Signals are deviations from VG = 2.048 V. Every P, I and D path is inverted twice. Trimpots are rheostats (wiper tied to one end).
1 Rate error = SP - gyro (U201A)
2 P, inverting (U201B)
3 Leaky I + clamp + reset (U9 = CD4066) (U201C)
4 Filtered D (U201D)
5 Summer -> U_ROLL (U202A)
6 Angle error = meas - cmd (U202B)
7 Angle P -> rate SP (U202C)
8 Bench plant (U202D)
Loop select + bench inputs
Plant test: jumper PLANT_OUT -> EXT_SP (LOOP_SP 2-3) and AD3 W1 -> EXT_FB (LOOP_FB 2-3).
Power + decoupling

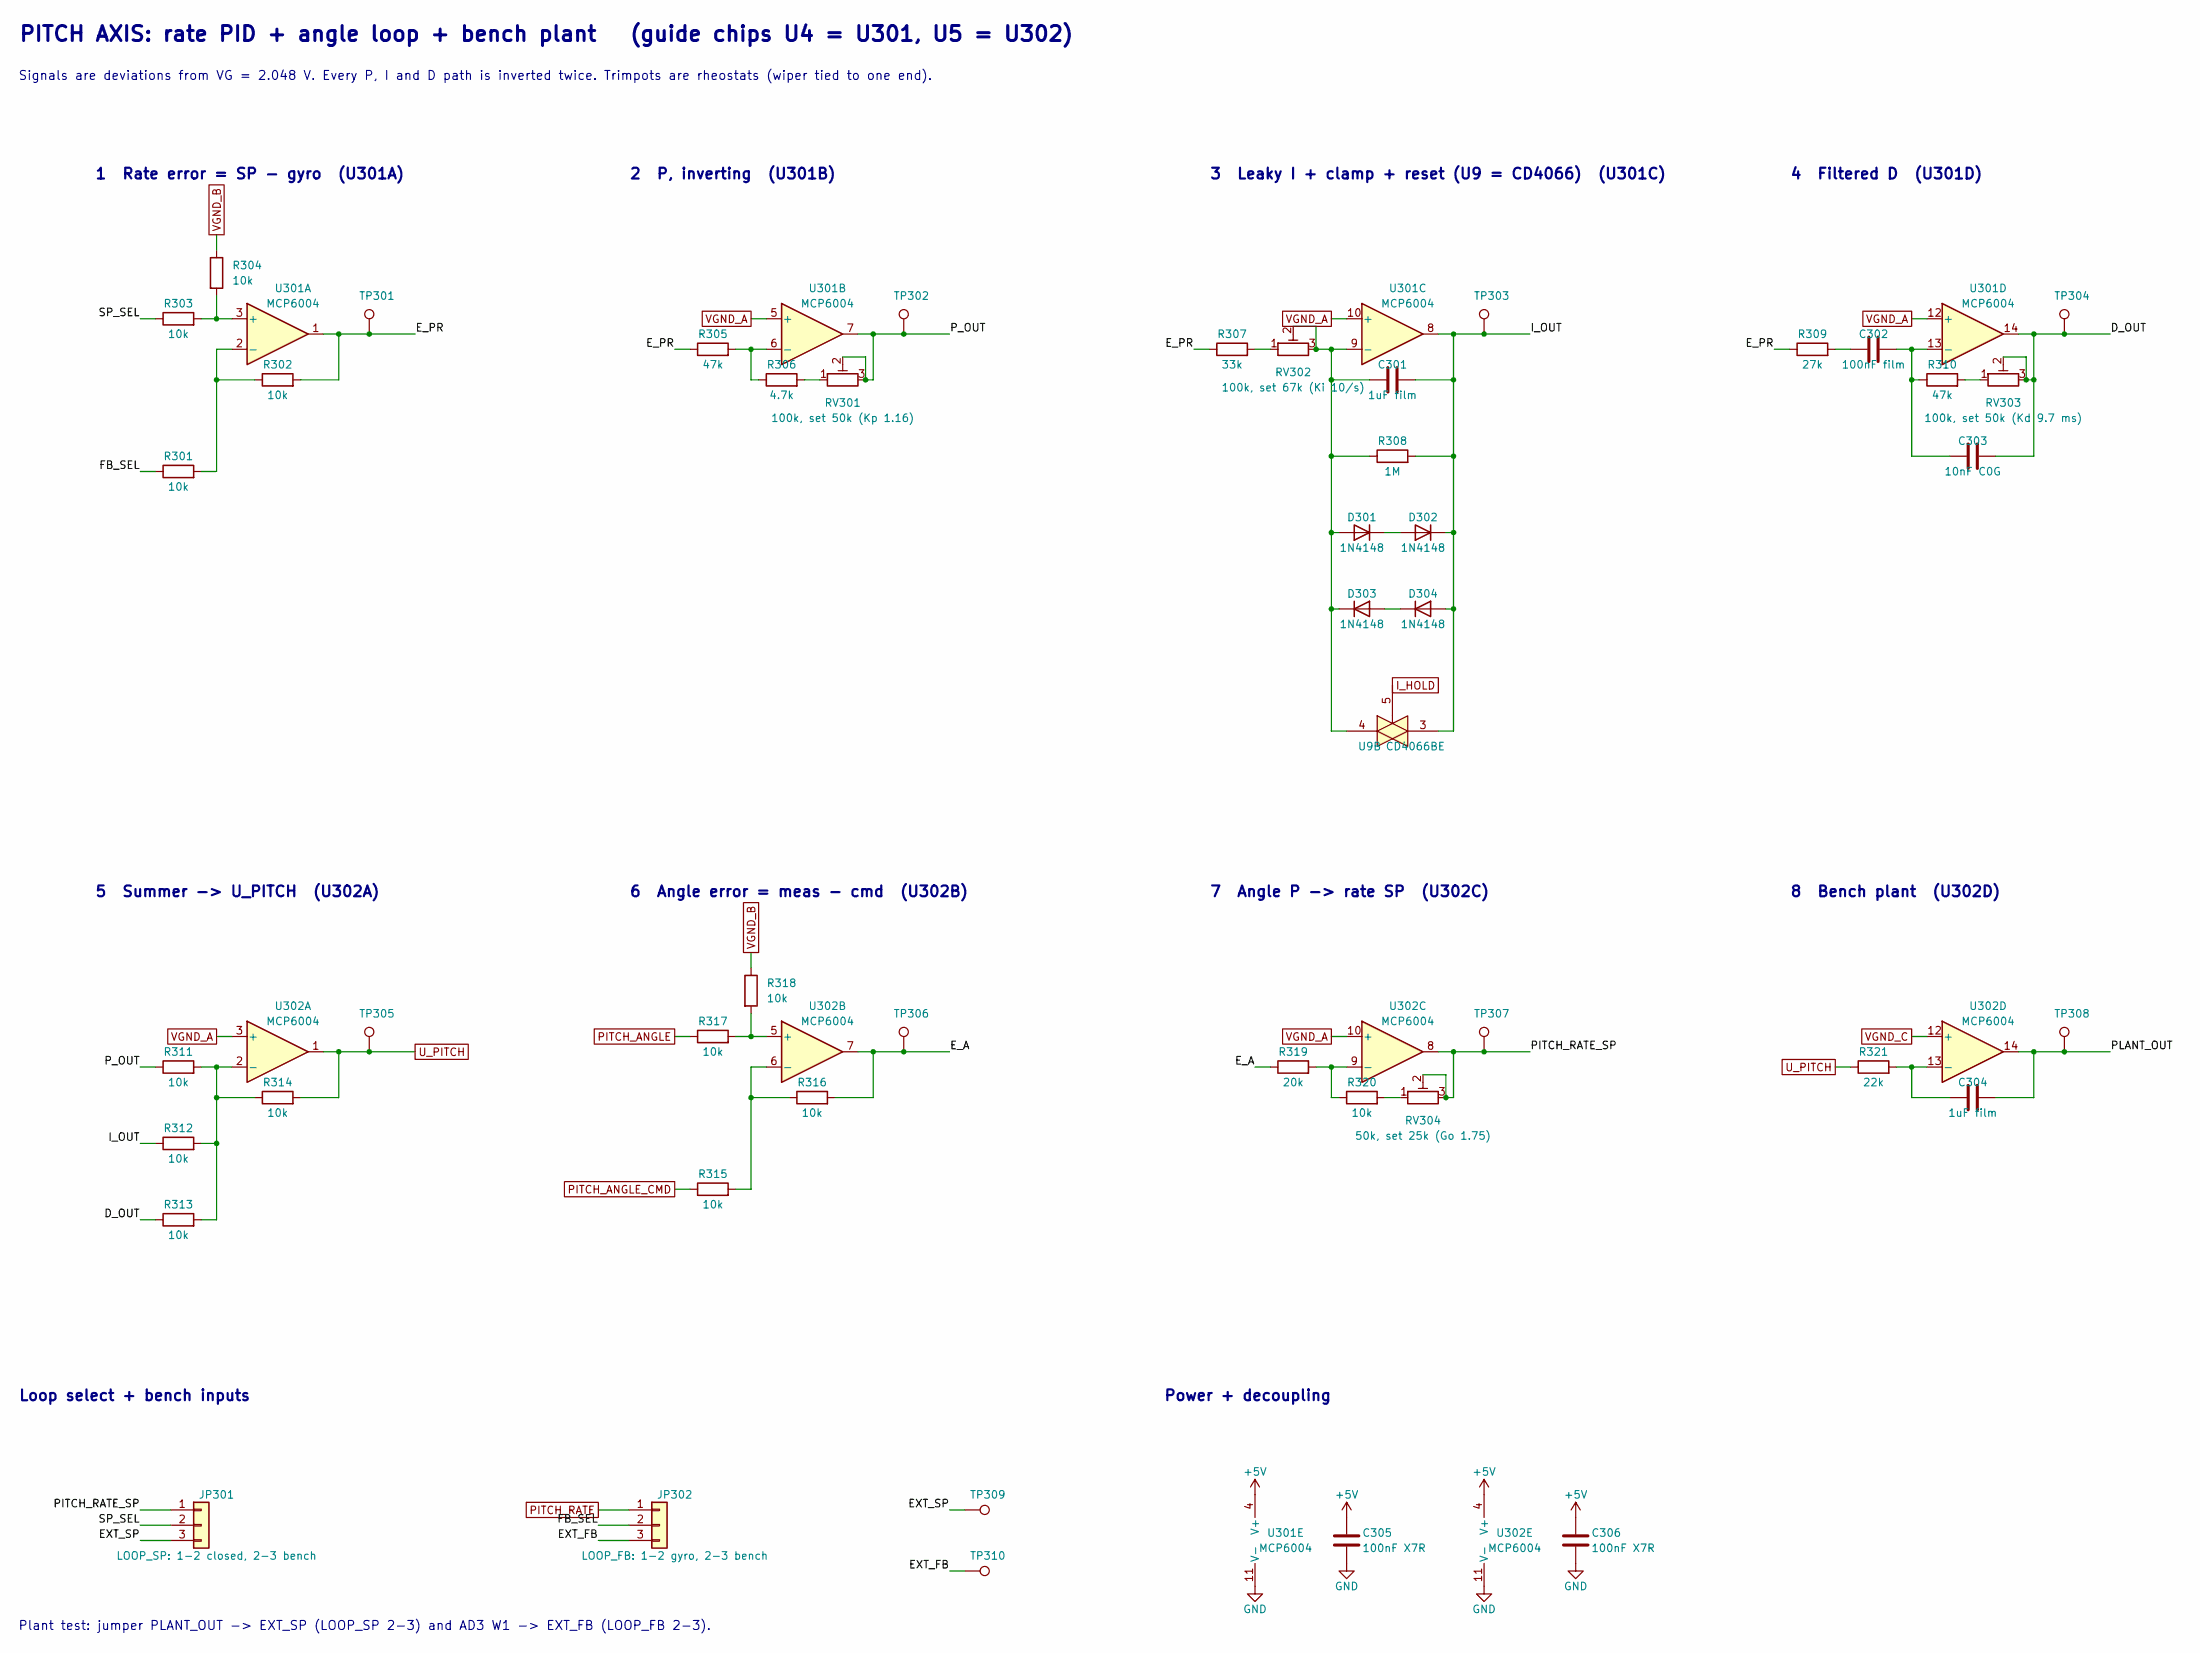
[picture p50: schematic pid_pitch.kicad_sch, Pitch axis PID]

Parts:
C301, C304: 1uF film; C_Rect_L7.2mm_W5.5mm_P5.00mm_FKS2_FKP2_MKS2_MKP2
C302: 100nF film; C_Rect_L7.2mm_W2.5mm_P5.00mm_FKS2_FKP2_MKS2_MKP2
C303: 10nF C0G; C_Disc_D5.0mm_W2.5mm_P5.00mm
C305, C306: 100nF X7R; C_Disc_D5.0mm_W2.5mm_P5.00mm
D301, D302, D303, D304: 1N4148; D_DO-35_SOD27_P7.62mm_Horizontal
JP301: LOOP_SP: 1-2 closed, 2-3 bench; PinHeader_1x03_P2.54mm_Vertical
JP302: LOOP_FB: 1-2 gyro, 2-3 bench; PinHeader_1x03_P2.54mm_Vertical
R301, R302, R303, R304, R311, R312, R313, R314, R315, R316, R317, R318, R320: 10k; R_Axial_DIN0207_L6.3mm_D2.5mm_P7.62mm_Horizontal
R305, R310: 47k; R_Axial_DIN0207_L6.3mm_D2.5mm_P7.62mm_Horizontal
R306: 4.7k; R_Axial_DIN0207_L6.3mm_D2.5mm_P7.62mm_Horizontal
R307: 33k; R_Axial_DIN0207_L6.3mm_D2.5mm_P7.62mm_Horizontal
R308: 1M; R_Axial_DIN0207_L6.3mm_D2.5mm_P7.62mm_Horizontal
R309: 27k; R_Axial_DIN0207_L6.3mm_D2.5mm_P7.62mm_Horizontal
R319: 20k; R_Axial_DIN0207_L6.3mm_D2.5mm_P7.62mm_Horizontal
R321: 22k; R_Axial_DIN0207_L6.3mm_D2.5mm_P7.62mm_Horizontal
RV301: 100k, set 50k (Kp 1.16); Potentiometer_Bourns_3296W_Vertical
RV302: 100k, set 67k (Ki 10/s); Potentiometer_Bourns_3296W_Vertical
RV303: 100k, set 50k (Kd 9.7 ms); Potentiometer_Bourns_3296W_Vertical
RV304: 50k, set 25k (Go 1.75); Potentiometer_Bourns_3296W_Vertical
TP301: E_PR; PinHeader_1x01_P2.54mm_Vertical
TP302: P_OUT; PinHeader_1x01_P2.54mm_Vertical
TP303: I_OUT; PinHeader_1x01_P2.54mm_Vertical
TP304: D_OUT; PinHeader_1x01_P2.54mm_Vertical
TP305: U_PITCH; PinHeader_1x01_P2.54mm_Vertical
TP306: E_A; PinHeader_1x01_P2.54mm_Vertical
TP307: PITCH_RATE_SP; PinHeader_1x01_P2.54mm_Vertical
TP308: PLANT_OUT; PinHeader_1x01_P2.54mm_Vertical
TP309: EXT_SP; PinHeader_1x01_P2.54mm_Vertical
TP310: EXT_FB; PinHeader_1x01_P2.54mm_Vertical
U9: CD4066BE; DIP-14_W7.62mm
U301, U302: MCP6004; DIP-14_W7.62mm

Connections:
+5V: C305.1, C306.1, U301.4 (V+), U302.4 (V+); also elsewhere on the board
/PID_Pitch/D_OUT: C303.2, R313.1, RV303.2, RV303.3, TP304.1, U301.14
/PID_Pitch/EXT_FB: JP302.3, TP310.1
/PID_Pitch/EXT_SP: JP301.3, TP309.1
/PID_Pitch/E_A: R316.2, R319.1, TP306.1, U302.7
/PID_Pitch/E_PR: R302.2, R305.1, R307.1, R309.1, TP301.1, U301.1
/PID_Pitch/FB_SEL: JP302.2, R301.1
/PID_Pitch/I_OUT: C301.2, D302.1 (K), D304.2 (A), R308.2, R312.1, TP303.1, U9.3, U301.8
/PID_Pitch/PITCH_RATE_SP: JP301.1, RV304.2, RV304.3, TP307.1, U302.8
/PID_Pitch/PLANT_OUT: C304.2, TP308.1, U302.14
/PID_Pitch/P_OUT: R311.1, RV301.2, RV301.3, TP302.1, U301.7
/PID_Pitch/SP_SEL: JP301.2, R303.1
GND: C305.2, C306.2, U301.11 (V-), U302.11 (V-); also elsewhere on the board
I_HOLD: U9.5; also elsewhere on the board
unnamed: C302.1, R309.2
unnamed: C301.1, D301.2 (A), D303.1 (K), R308.1, RV302.2, RV302.3, U9.4, U301.9 (-)
unnamed: D301.1 (K), D302.2 (A)
unnamed: D303.2 (A), D304.1 (K)
unnamed: R306.2, RV301.1
unnamed: R307.2, RV302.1
unnamed: R310.2, RV303.1
unnamed: R320.2, RV304.1
unnamed: R303.2, R304.2, U301.3 (+)
unnamed: R301.2, R302.1, U301.2 (-)
unnamed: R305.2, R306.1, U301.6 (-)
unnamed: C302.2, C303.1, R310.1, U301.13 (-)
unnamed: R311.2, R312.2, R313.2, R314.1, U302.2 (-)
unnamed: R317.2, R318.2, U302.5 (+)
unnamed: R315.2, R316.1, U302.6 (-)
unnamed: R319.2, R320.1, U302.9 (-)
unnamed: C304.1, R321.2, U302.13 (-)
PITCH_ANGLE: R317.1; also elsewhere on the board
PITCH_ANGLE_CMD: R315.1; also elsewhere on the board
PITCH_RATE: JP302.1; also elsewhere on the board
U_PITCH: R314.2, R321.1, TP305.1, U302.1; also elsewhere on the board
VGND_A: U301.5 (+), U301.10 (+), U301.12 (+), U302.3 (+), U302.10 (+); also elsewhere on the board
VGND_B: R304.1, R318.1; also elsewhere on the board
VGND_C: U302.12 (+); also elsewhere on the board

Notes on the sheet:
PITCH AXIS: rate PID + angle loop + bench plant (guide chips U4 = U301, U5 = U302)
Signals are deviations from VG = 2.048 V. Every P, I and D path is inverted twice. Trimpots are rheostats (wiper tied to one end).
1 Rate error = SP - gyro (U301A)
2 P, inverting (U301B)
3 Leaky I + clamp + reset (U9 = CD4066) (U301C)
4 Filtered D (U301D)
5 Summer -> U_PITCH (U302A)
6 Angle error = meas - cmd (U302B)
7 Angle P -> rate SP (U302C)
8 Bench plant (U302D)
Loop select + bench inputs
Plant test: jumper PLANT_OUT -> EXT_SP (LOOP_SP 2-3) and AD3 W1 -> EXT_FB (LOOP_FB 2-3).
Power + decoupling
