AaronDoubert/quadcopter-pid-boards/PID_Board/PID_Board.kicad_pcb

## KiCad design PID_Board/PID_Board.kicad_pcb (continued)

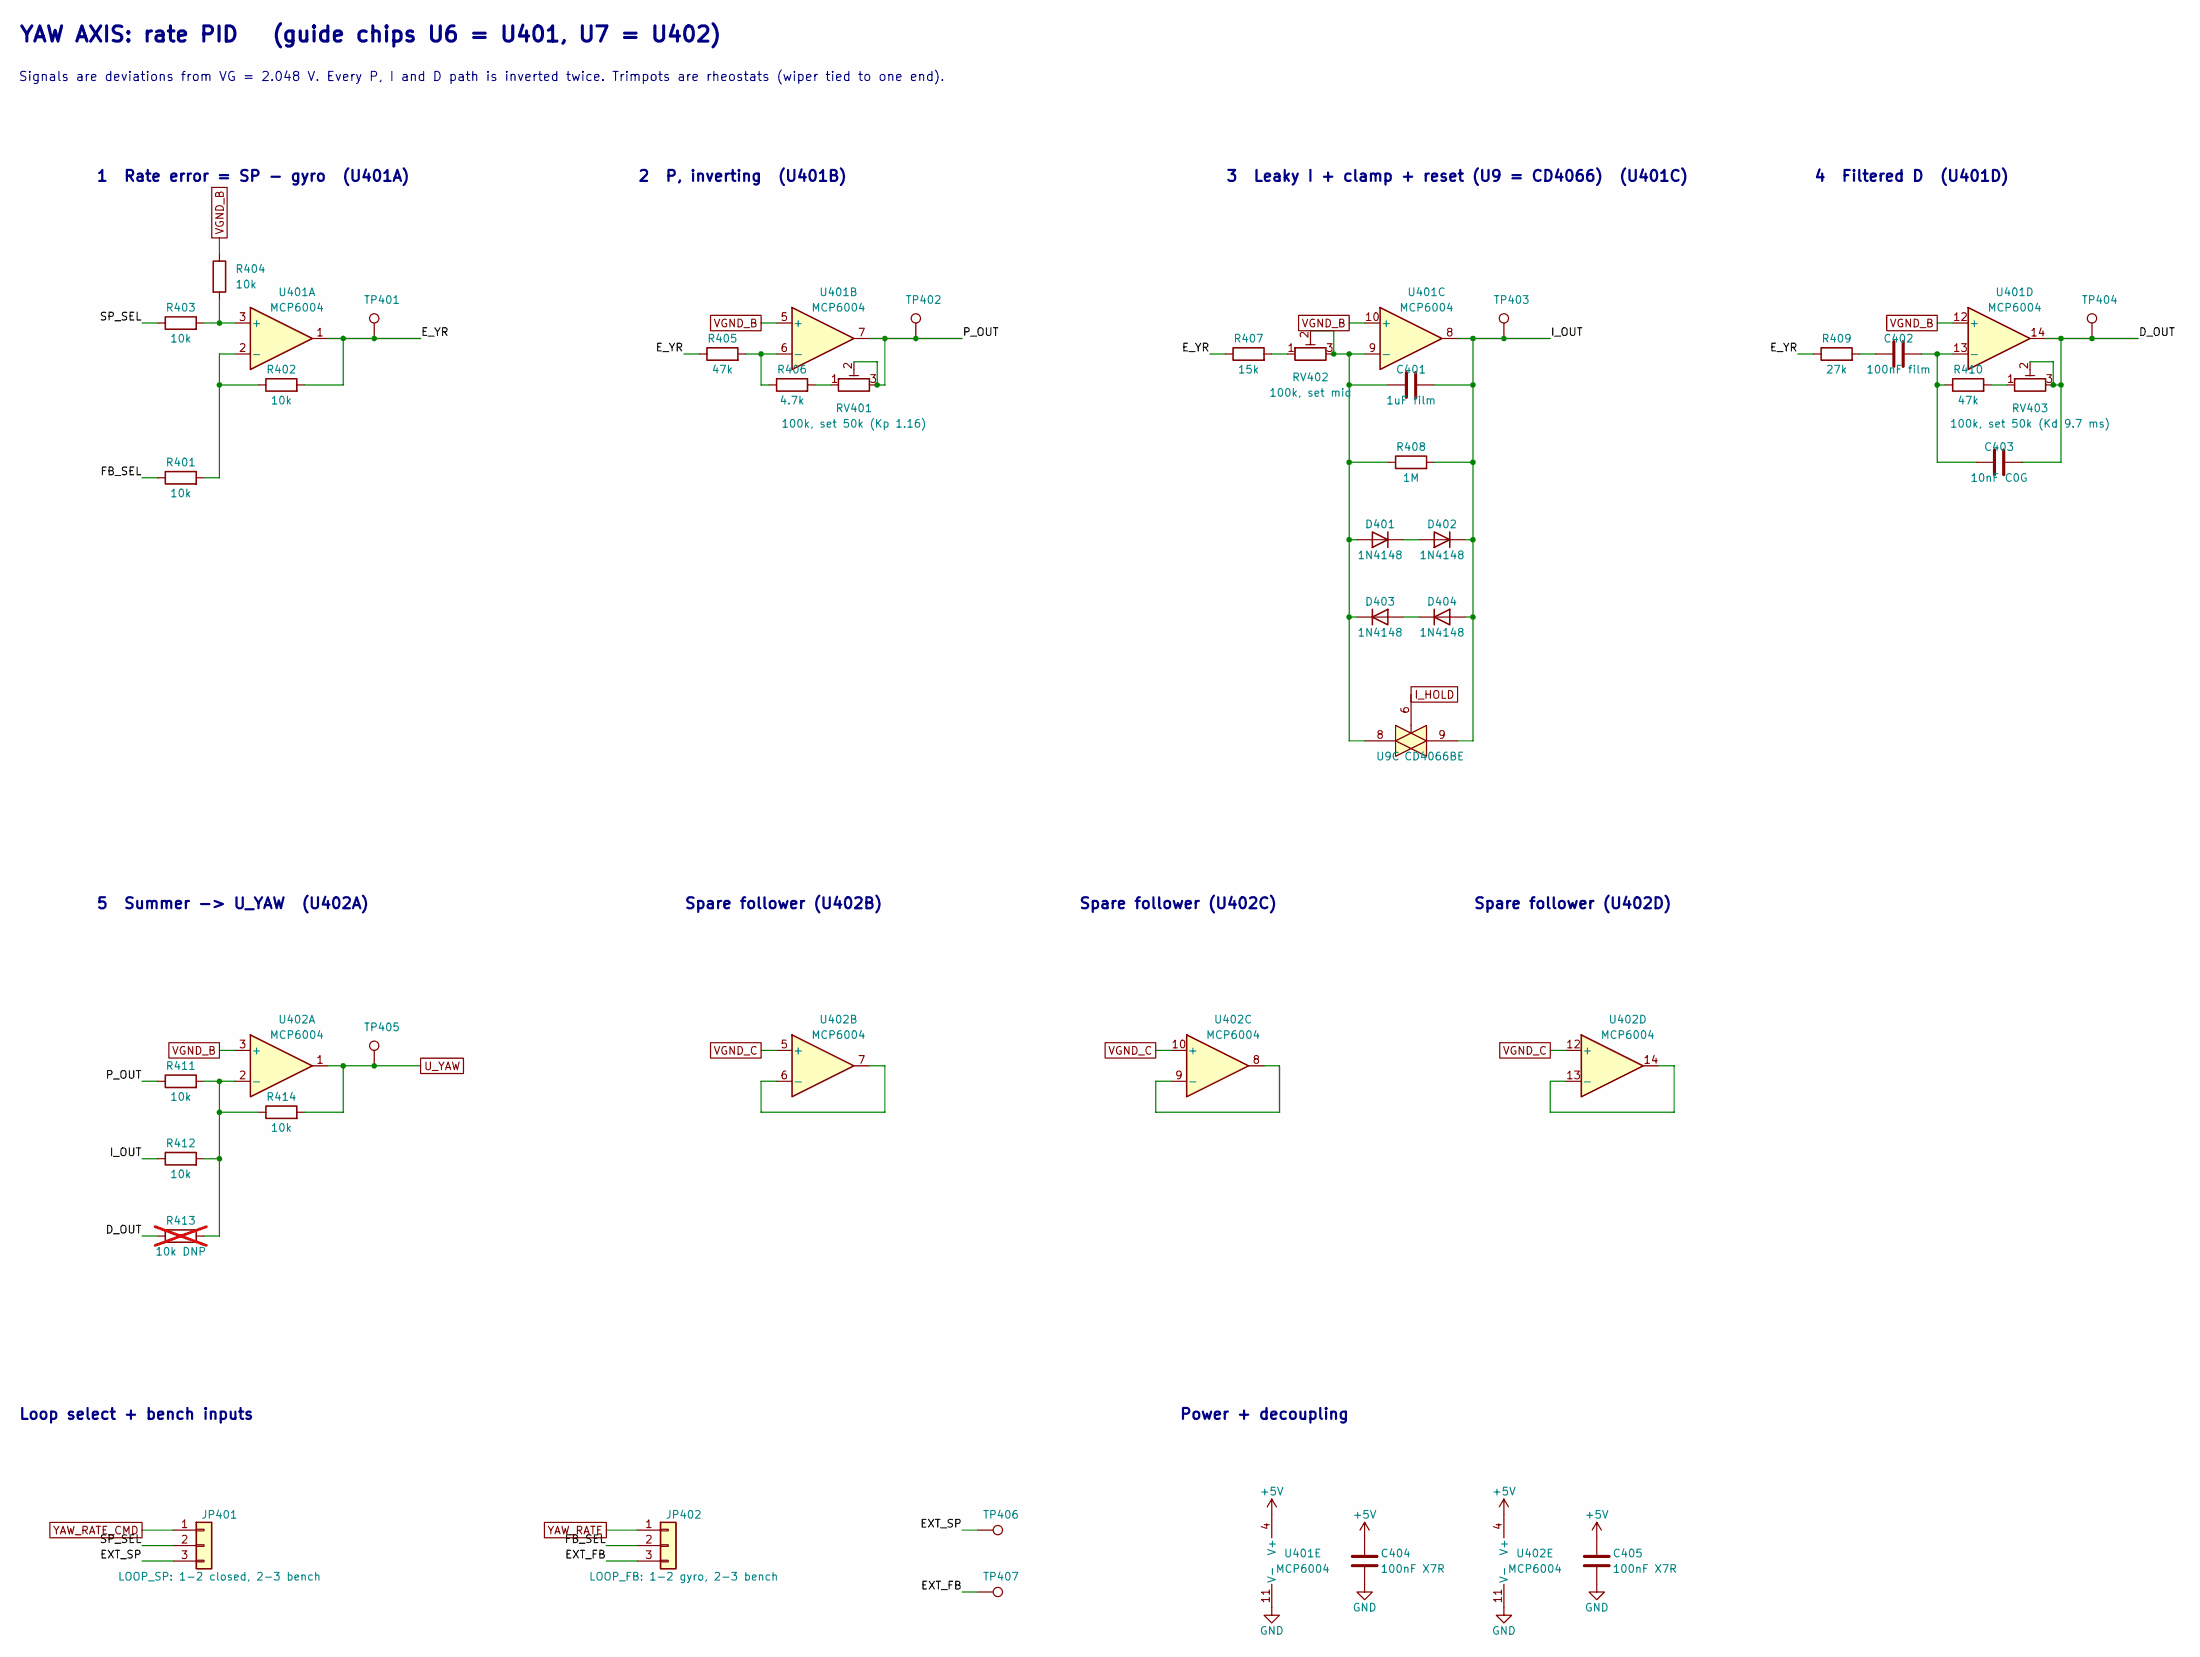
[picture p51: schematic pid_yaw.kicad_sch, Yaw axis PID]

Parts:
C401: 1uF film; C_Rect_L7.2mm_W5.5mm_P5.00mm_FKS2_FKP2_MKS2_MKP2
C402: 100nF film; C_Rect_L7.2mm_W2.5mm_P5.00mm_FKS2_FKP2_MKS2_MKP2
C403: 10nF C0G; C_Disc_D5.0mm_W2.5mm_P5.00mm
C404, C405: 100nF X7R; C_Disc_D5.0mm_W2.5mm_P5.00mm
D401, D402, D403, D404: 1N4148; D_DO-35_SOD27_P7.62mm_Horizontal
JP401: LOOP_SP: 1-2 closed, 2-3 bench; PinHeader_1x03_P2.54mm_Vertical
JP402: LOOP_FB: 1-2 gyro, 2-3 bench; PinHeader_1x03_P2.54mm_Vertical
R401, R402, R403, R404, R411, R412, R414: 10k; R_Axial_DIN0207_L6.3mm_D2.5mm_P7.62mm_Horizontal
R405, R410: 47k; R_Axial_DIN0207_L6.3mm_D2.5mm_P7.62mm_Horizontal
R406: 4.7k; R_Axial_DIN0207_L6.3mm_D2.5mm_P7.62mm_Horizontal
R407: 15k; R_Axial_DIN0207_L6.3mm_D2.5mm_P7.62mm_Horizontal
R408: 1M; R_Axial_DIN0207_L6.3mm_D2.5mm_P7.62mm_Horizontal
R409: 27k; R_Axial_DIN0207_L6.3mm_D2.5mm_P7.62mm_Horizontal
R413: 10k DNP; R_Axial_DIN0207_L6.3mm_D2.5mm_P7.62mm_Horizontal; not fitted
RV401: 100k, set 50k (Kp 1.16); Potentiometer_Bourns_3296W_Vertical
RV402: 100k, set mid; Potentiometer_Bourns_3296W_Vertical
RV403: 100k, set 50k (Kd 9.7 ms); Potentiometer_Bourns_3296W_Vertical
TP401: E_YR; PinHeader_1x01_P2.54mm_Vertical
TP402: P_OUT; PinHeader_1x01_P2.54mm_Vertical
TP403: I_OUT; PinHeader_1x01_P2.54mm_Vertical
TP404: D_OUT; PinHeader_1x01_P2.54mm_Vertical
TP405: U_YAW; PinHeader_1x01_P2.54mm_Vertical
TP406: EXT_SP; PinHeader_1x01_P2.54mm_Vertical
TP407: EXT_FB; PinHeader_1x01_P2.54mm_Vertical
U9: CD4066BE; DIP-14_W7.62mm
U401, U402: MCP6004; DIP-14_W7.62mm

Connections:
+5V: C404.1, C405.1, U401.4 (V+), U402.4 (V+); also elsewhere on the board
/PID_Yaw/D_OUT: C403.2, R413.1, RV403.2, RV403.3, TP404.1, U401.14
/PID_Yaw/EXT_FB: JP402.3, TP407.1
/PID_Yaw/EXT_SP: JP401.3, TP406.1
/PID_Yaw/E_YR: R402.2, R405.1, R407.1, R409.1, TP401.1, U401.1
/PID_Yaw/FB_SEL: JP402.2, R401.1
/PID_Yaw/I_OUT: C401.2, D402.1 (K), D404.2 (A), R408.2, R412.1, TP403.1, U9.9, U401.8
/PID_Yaw/P_OUT: R411.1, RV401.2, RV401.3, TP402.1, U401.7
/PID_Yaw/SP_SEL: JP401.2, R403.1
GND: C404.2, C405.2, U401.11 (V-), U402.11 (V-); also elsewhere on the board
I_HOLD: U9.6; also elsewhere on the board
unnamed: C402.1, R409.2
unnamed: C401.1, D401.2 (A), D403.1 (K), R408.1, RV402.2, RV402.3, U9.8, U401.9 (-)
unnamed: D401.1 (K), D402.2 (A)
unnamed: D403.2 (A), D404.1 (K)
unnamed: R406.2, RV401.1
unnamed: R407.2, RV402.1
unnamed: R410.2, RV403.1
unnamed: R403.2, R404.2, U401.3 (+)
unnamed: R401.2, R402.1, U401.2 (-)
unnamed: R405.2, R406.1, U401.6 (-)
unnamed: C402.2, C403.1, R410.1, U401.13 (-)
unnamed: R411.2, R412.2, R413.2, R414.1, U402.2 (-)
unnamed: U402.6 (-), U402.7
unnamed: U402.8, U402.9 (-)
unnamed: U402.13 (-), U402.14
U_YAW: R414.2, TP405.1, U402.1; also elsewhere on the board
VGND_B: R404.1, U401.5 (+), U401.10 (+), U401.12 (+), U402.3 (+); also elsewhere on the board
VGND_C: U402.5 (+), U402.10 (+), U402.12 (+); also elsewhere on the board
YAW_RATE: JP402.1; also elsewhere on the board
YAW_RATE_CMD: JP401.1; also elsewhere on the board

Notes on the sheet:
YAW AXIS: rate PID (guide chips U6 = U401, U7 = U402)
Signals are deviations from VG = 2.048 V. Every P, I and D path is inverted twice. Trimpots are rheostats (wiper tied to one end).
1 Rate error = SP - gyro (U401A)
2 P, inverting (U401B)
3 Leaky I + clamp + reset (U9 = CD4066) (U401C)
4 Filtered D (U401D)
5 Summer -> U_YAW (U402A)
Spare follower (U402B)
Spare follower (U402C)
Spare follower (U402D)
Loop select + bench inputs
Power + decoupling

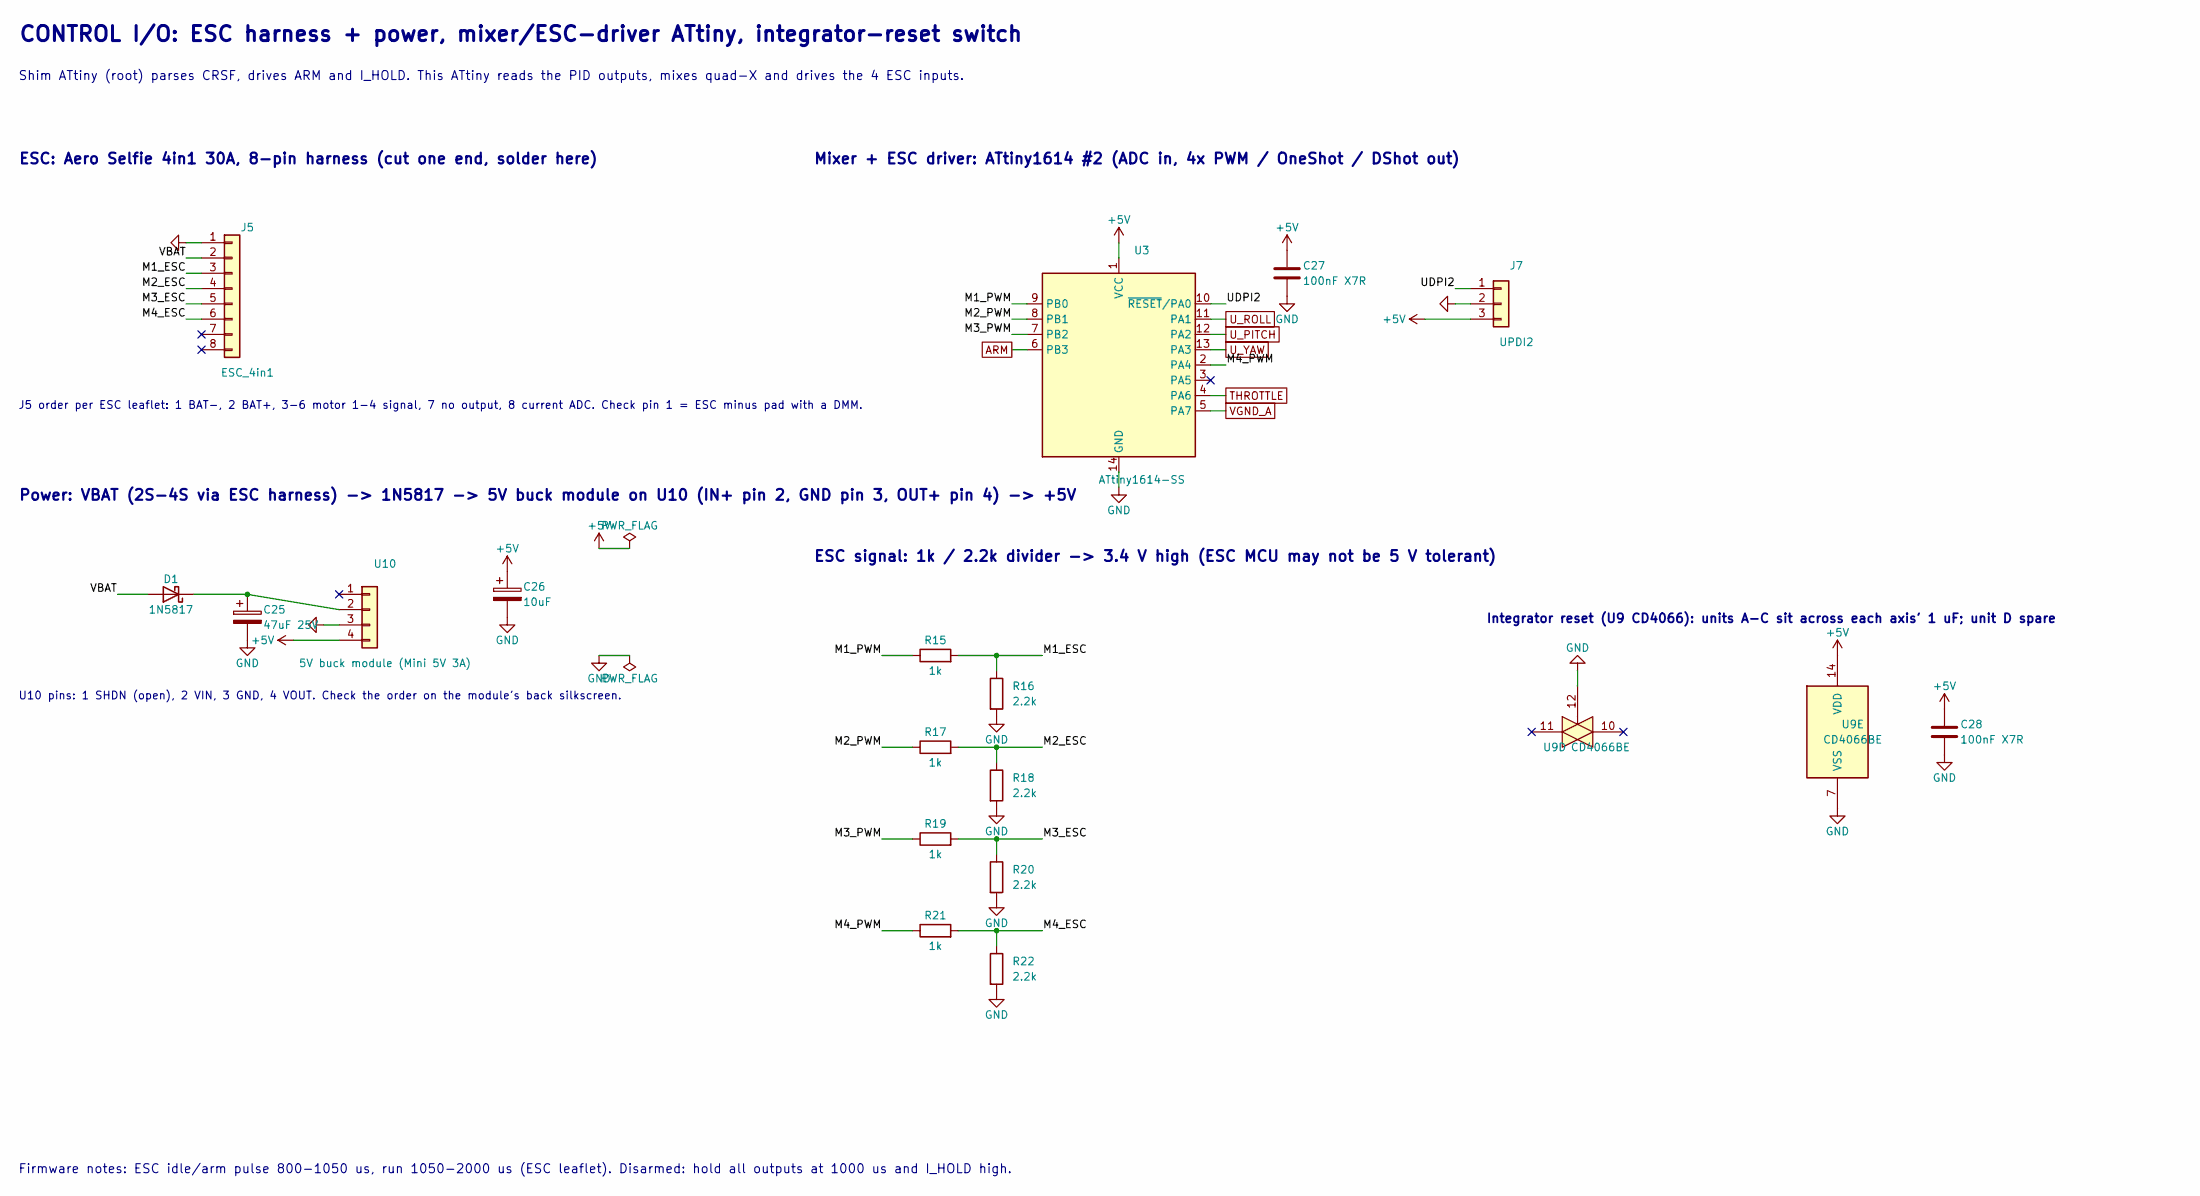
[picture p52: schematic control_io.kicad_sch, Control I/O: ESC, power, mixer]

Parts:
C25: 47uF 25V; CP_Radial_D5.0mm_P2.00mm
C26: 10uF; CP_Radial_D5.0mm_P2.00mm
C27, C28: 100nF X7R; C_Disc_D5.0mm_W2.5mm_P5.00mm
D1: 1N5817; D_DO-41_SOD81_P10.16mm_Horizontal
J5: ESC_4in1; PinHeader_1x08_P2.54mm_Vertical
J7: UPDI2; PinHeader_1x03_P2.54mm_Vertical
R15, R17, R19, R21: 1k; R_Axial_DIN0207_L6.3mm_D2.5mm_P7.62mm_Horizontal
R16, R18, R20, R22: 2.2k; R_Axial_DIN0207_L6.3mm_D2.5mm_P7.62mm_Horizontal
U3: ATtiny1614-SS; SOIC-14_3.9x8.7mm_P1.27mm
U9: CD4066BE; DIP-14_W7.62mm
U10: 5V buck module (Mini 5V 3A); PinHeader_1x04_P2.54mm_Vertical

Connections:
+5V: C26.1, C27.1, C28.1, J7.3, U3.1 (VCC), U9.14 (VDD), U10.4; also elsewhere on the board
/Control_IO/M1_ESC: J5.3, R15.2, R16.1
/Control_IO/M1_PWM: R15.1, U3.9 (PB0)
/Control_IO/M2_ESC: J5.4, R17.2, R18.1
/Control_IO/M2_PWM: R17.1, U3.8 (PB1)
/Control_IO/M3_ESC: J5.5, R19.2, R20.1
/Control_IO/M3_PWM: R19.1, U3.7 (PB2)
/Control_IO/M4_ESC: J5.6, R21.2, R22.1
/Control_IO/M4_PWM: R21.1, U3.2 (PA4)
/Control_IO/UDPI2: J7.1, U3.10 (~RESET/PA0)
/Control_IO/VBAT: D1.2 (A), J5.2
ARM: U3.6 (PB3); also elsewhere on the board
GND: C25.2, C26.2, C27.2, C28.2, J5.1, J7.2, R16.2, R18.2, R20.2, R22.2, U3.14 (GND), U9.7 (VSS), U9.12, U10.3; also elsewhere on the board
unnamed: C25.1, D1.1 (K), U10.2
THROTTLE: U3.4 (PA6); also elsewhere on the board
U_PITCH: U3.12 (PA2); also elsewhere on the board
U_ROLL: U3.11 (PA1); also elsewhere on the board
U_YAW: U3.13 (PA3); also elsewhere on the board
VGND_A: U3.5 (PA7); also elsewhere on the board

Notes on the sheet:
CONTROL I/O: ESC harness + power, mixer/ESC-driver ATtiny, integrator-reset switch
Shim ATtiny (root) parses CRSF, drives ARM and I_HOLD. This ATtiny reads the PID outputs, mixes quad-X and drives the 4 ESC inputs.
ESC: Aero Selfie 4in1 30A, 8-pin harness (cut one end, solder here)
J5 order per ESC leaflet: 1 BAT-, 2 BAT+, 3-6 motor 1-4 signal, 7 no output, 8 current ADC. Check pin 1 = ESC minus pad with a DMM.
Power: VBAT (2S-4S via ESC harness) -> 1N5817 -> 5V buck module on U10 (IN+ pin 2, GND pin 3, OUT+ pin 4) -> +5V
U10 pins: 1 SHDN (open), 2 VIN, 3 GND, 4 VOUT. Check the order on the module's back silkscreen.
Mixer + ESC driver: ATtiny1614 #2 (ADC in, 4x PWM / OneShot / DShot out)
ESC signal: 1k / 2.2k divider -> 3.4 V high (ESC MCU may not be 5 V tolerant)
Integrator reset (U9 CD4066): units A-C sit across each axis' 1 uF; unit D spare
Firmware notes: ESC idle/arm pulse 800-1050 us, run 1050-2000 us (ESC leaflet). Disarmed: hold all outputs at 1000 us and I_HOLD high.

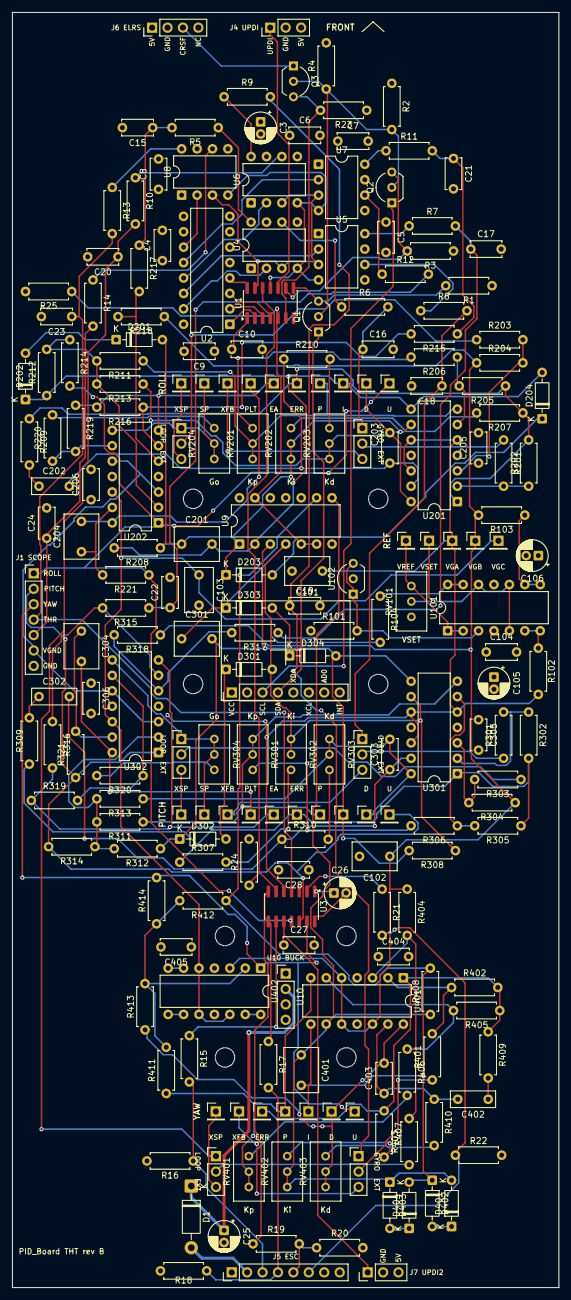
[picture p53: board PID_Board.kicad_pcb from above]

Board: 4 copper layers, 90.0 x 210.0 mm, 228 parts (0 on the bottom side), 144 nets.
