AaronDoubert/quadcopter-pid-boards/PID_Board_SMT/scripts/gen_smt.py

"""Generate PID_Board_SMT: the SMT / cost-reduced / digital-pot version of PID_Board.

Usage: python -I gen_smt.py <project_dir> <expected_nets.json>

Same circuit as PID_Board (generated by gen_all.py) with these changes:
  * every part SMD except connectors, jumpers and mounting holes
  * the 12 trimpots are channels of three MCP4451-104 quad I2C digital pots
    (U103, U203, U303) on the shim's 5 V I2C bus (SDA_5V / SCL_5V)
  * VSET = TL431 buffer -> 47.5k -> rheostat + 165k (0.67 mV/step)
  * MCP6004 -> LMV324B (3PEAK, RRIO CMOS), CD4066 -> 74HC4066, 2N7000 -> BSS138,
    1N4148 pairs -> BAV99, 1N5817 -> SS14, Pololu D24V5F5 -> TPS54202 buck
  * every BOM part carries an LCSC field for JLCPCB assembly
Inside a block parts are joined by wires; labels only join blocks and sheets.
Every intended connection is recorded and written to the expected-nets file so
the KiCad netlist can be diffed against it.
"""
import json, math, os, re, sys, uuid

PROJ_DIR, EXPECT_OUT = sys.argv[1], sys.argv[2]
PROJECT = "PID_Board_SMT"
SYMDIR = r"C:\Program Files\KiCad\10.0\share\kicad\symbols"
ROOT_FILE = os.path.join(PROJ_DIR, "PID_Board_SMT.kicad_sch")
LIB_SRC = r"C:\Users\doubi\Quadcopter Flight controller\PID_Board\PID_Board.kicad_sch"  # flattened ATtiny/MCP4822

FP = {
    "R": "Resistor_SMD:R_0603_1608Metric",
    "C0603": "Capacitor_SMD:C_0603_1608Metric",
    "C0805": "Capacitor_SMD:C_0805_2012Metric",
    "C1206": "Capacitor_SMD:C_1206_3216Metric",
    "SOIC8": "Package_SO:SOIC-8_3.9x4.9mm_P1.27mm",
    "SOIC14": "Package_SO:SOIC-14_3.9x8.7mm_P1.27mm",
    "SOIC16": "Package_SO:SOIC-16_3.9x9.9mm_P1.27mm",
    "TSSOP20": "Package_SO:TSSOP-20_4.4x6.5mm_P0.65mm",
    "SOT23": "Package_TO_SOT_SMD:SOT-23",
    "SOT23_6": "Package_TO_SOT_SMD:SOT-23-6",
    "ELEC": "Capacitor_SMD:CP_Elec_6.3x5.7",
    "L4030": "Inductor_SMD:L_Changjiang_FNR4030S",
    "SMA": "Diode_SMD:D_SMA",
    "TP": "TestPoint:TestPoint_Pad_D1.5mm",
    "H2": "Connector_PinHeader_2.54mm:PinHeader_1x02_P2.54mm_Vertical",
    "H3": "Connector_PinHeader_2.54mm:PinHeader_1x03_P2.54mm_Vertical",
    "H4": "Connector_PinHeader_2.54mm:PinHeader_1x04_P2.54mm_Vertical",
    "H7": "Connector_PinHeader_2.54mm:PinHeader_1x07_P2.54mm_Vertical",
    "H8": "Connector_PinHeader_2.54mm:PinHeader_1x08_P2.54mm_Vertical",
    "HOLE": "MountingHole:MountingHole_3.2mm_M3",
}
POWER = {"+5V", "GND"}
GLOBAL = {"VGND_A", "VGND_B", "VGND_C", "THROTTLE", "DAC_SPARE",
          "ROLL_RATE", "ROLL_ANGLE", "ROLL_ANGLE_CMD", "U_ROLL",
          "PITCH_RATE", "PITCH_ANGLE", "PITCH_ANGLE_CMD", "U_PITCH",
          "YAW_RATE", "YAW_RATE_CMD", "U_YAW", "ARM", "I_HOLD",
          "SDA_5V", "SCL_5V"}

# JLCPCB / LCSC part numbers (checked in the JLCPCB catalogue on 2026-10-20). Key: value as placed.
LCSC_R = {"100": "C22775", "1k": "C21190", "2.2k": "C4190", "4.7k": "C23162", "10k": "C25804",
          "15k": "C22809", "20k": "C4184", "22k": "C31850", "27k": "C22967", "33k": "C4216",
          "47k": "C25819", "47.5k": "C23061", "75k": "C23242", "165k": "C22816", "1M": "C22935"}
LCSC = {"100nF X7R": "C14663", "100nF": "C49678", "1uF X7R 1206": "C1848", "1uF": "C15849",
        "10nF C0G": "C85973", "470nF X7R": "C1623", "10uF 25V": "C15850", "22uF 10V": "C29277",
        "47uF 35V": "C165542", "LMV324B-SR": "C248570", "MCP4451-104E/ST": "C638704",
        "MCP4822-E/SN": "C16040", "ATtiny1614-SSNR": "C481364", "74HC138D": "C5602",
        "74HC4066D": "C5628", "TL431BIDBZR": "C41283", "BSS138": "C8490", "BAV99": "C2500",
        "SS14": "C2480", "TPS54202DDCR": "C191884", "15uH FNR4030S": "C167881"}

def lcsc(value, fp):
    if fp == FP["R"]:
        return LCSC_R.get(value.split()[0])
    return LCSC.get(value)

def U():
    return str(uuid.uuid4())

def fmt(v):
    v = round(v, 2)
    return str(int(v)) if v == int(v) else str(v)

def block_at(s, i):
    d = 0
    for k in range(i, len(s)):
        if s[k] == "(":
            d += 1
        elif s[k] == ")":
            d -= 1
            if d == 0:
                return s[i:k + 1]

# ---------------------------------------------------------------- library
ROOT_TEXT = open(ROOT_FILE, encoding="utf-8").read()
ROOT_UUID = re.search(r'\(uuid "([^"]+)"\)', ROOT_TEXT).group(1)
SRC_TEXT = open(LIB_SRC, encoding="utf-8").read()
FROM_ROOT = {"MCU_Microchip_ATtiny:ATtiny1614-SS", "Analog_DAC:MCP4822"}  # derived in the stock libs; KiCad-flattened copies live in PID_Board's root

def parse_pins(blk):
    pins = {}
    for m in re.finditer(r'\(symbol "[^"]*?_(\d+)_(\d+)"', blk):
        unit, style = int(m.group(1)), int(m.group(2))
        if style not in (0, 1):
            continue
        sub = block_at(blk, m.start())
        for p in re.finditer(r'\(pin \w+ \w+\s*\(at ([-\d.]+) ([-\d.]+) (\d+)\).*?\(number "([^"]*)"', sub, re.S):
            pins.setdefault(unit, []).append((p.group(4), float(p.group(1)), float(p.group(2)), int(p.group(3))))
    return pins

_lib = {}
def lib(libname, name):
    key = f"{libname}:{name}"
    if key in _lib:
        return _lib[key]
    if key in FROM_ROOT:
        i = SRC_TEXT.find(f'(symbol "{key}"')
        assert i >= 0, key
        blk = block_at(SRC_TEXT, i)
    else:
        s = open(os.path.join(SYMDIR, libname + ".kicad_sym"), encoding="utf-8").read()
        i = s.find(f'\n\t(symbol "{name}"')
        assert i >= 0, key
        blk = block_at(s, i + 2)
        assert "(extends" not in blk, f"{key} is derived"
        blk = blk.replace(f'(symbol "{name}"', f'(symbol "{key}"', 1)
    _lib[key] = (blk, parse_pins(blk))
    return _lib[key]

# ---------------------------------------------------------------- sheet
class Sheet:
    def __init__(self, fname, title, inst_path, pwr_prefix):
        self.fname, self.title, self.inst_path = fname, title, inst_path
        self.pwr_prefix, self.pwr_n = pwr_prefix, 0
        self.libs, self.items = {}, []
        self.nets = {}

    # --- connectivity bookkeeping
    def expect(self, net, *nodes):
        self.nets.setdefault(net, set()).update(nodes)

    # --- primitives
    def place(self, libname, name, ref, value, fp, x, y, rot=0, unit=1, dnp=False, extra=None,
              ref_xy=None, val_xy=None, hide_val=False, hide_ref=False, just=None):
        key = f"{libname}:{name}"
        blk, pins = lib(libname, name)
        self.libs[key] = blk
        r = math.radians(rot)
        tips = {}
        for u in (0, unit):
            for num, px, py, ang in pins.get(u, []):
                rx = px * math.cos(r) - py * math.sin(r)
                ry = px * math.sin(r) + py * math.cos(r)
                tips[num] = (round(x + rx, 2), round(y - ry, 2), (ang + rot + 180) % 360)  # (x, y, outward dir)
        is_pwr = ref.startswith("#")
        rx_, ry_ = ref_xy if ref_xy else (x, y - 2.54)
        vx_, vy_ = val_xy if val_xy else (x, y + 2.54)
        ang = rot if rot in (90, 270) else 0  # field angles are relative to the symbol; keep text horizontal

        def prop(pname, val, px, py, hide):
            h = "\n\t\t\t(hide yes)" if hide else ""
            j = f"\n\t\t\t\t(justify {just})" if just and pname in ("Reference", "Value") else ""
            return (f'\t\t(property "{pname}" "{val}"\n\t\t\t(at {fmt(px)} {fmt(py)} {ang}){h}\n'
                    f'\t\t\t(effects\n\t\t\t\t(font\n\t\t\t\t\t(size 1.27 1.27)\n\t\t\t\t){j}\n\t\t\t)\n\t\t)\n')
        s = (f'\t(symbol\n\t\t(lib_id "{key}")\n\t\t(at {fmt(x)} {fmt(y)} {rot})\n\t\t(unit {unit})\n'
             f'\t\t(exclude_from_sim no)\n\t\t(in_bom {"no" if is_pwr else "yes"})\n\t\t(on_board {"no" if is_pwr else "yes"})\n'
             f'\t\t(dnp {"yes" if dnp else "no"})\n\t\t(uuid "{U()}")\n')
        s += prop("Reference", ref, rx_, ry_, is_pwr or hide_ref)
        s += prop("Value", value, vx_, vy_, hide_val)
        s += prop("Footprint", fp, x, y, True)
        s += prop("Datasheet", "", x, y, True)
        extra = dict(extra or {})
        code = None if is_pwr else lcsc(value, fp)
        if code:
            extra.setdefault("LCSC", code)
        for k, v in extra.items():
            s += prop(k, v, x, y, True)
        for num in tips:
            s += f'\t\t(pin "{num}"\n\t\t\t(uuid "{U()}")\n\t\t)\n'
        s += (f'\t\t(instances\n\t\t\t(project "{PROJECT}"\n\t\t\t\t(path "{self.inst_path}"\n'
              f'\t\t\t\t\t(reference "{ref}")\n\t\t\t\t\t(unit {unit})\n\t\t\t\t)\n\t\t\t)\n\t\t)\n\t)\n')
        self.items.append(s)
        return {k: v for k, v in tips.items()}

    def wire(self, *pts):
        for (a, b), (c, d) in zip(pts, pts[1:]):
            if (a, b) == (c, d):
                continue
            self.items.append(f'\t(wire\n\t\t(pts (xy {fmt(a)} {fmt(b)}) (xy {fmt(c)} {fmt(d)}))\n'
                              f'\t\t(stroke\n\t\t\t(width 0)\n\t\t\t(type default)\n\t\t)\n\t\t(uuid "{U()}")\n\t)\n')

    def junc(self, x, y):
        self.items.append(f'\t(junction\n\t\t(at {fmt(x)} {fmt(y)})\n\t\t(diameter 0)\n\t\t(color 0 0 0 0)\n\t\t(uuid "{U()}")\n\t)\n')

    def nc(self, x, y):
        self.items.append(f'\t(no_connect\n\t\t(at {fmt(x)} {fmt(y)})\n\t\t(uuid "{U()}")\n\t)\n')

    def label(self, net, x, y, out):
        """Label at (x, y) whose text runs in direction `out` (0 right, 90 up, 180 left, 270 down)."""
        just = "left" if out in (0, 90) else "right"
        if net in GLOBAL:
            self.items.append(f'\t(global_label "{net}"\n\t\t(shape passive)\n\t\t(at {fmt(x)} {fmt(y)} {out})\n'
                              f'\t\t(effects\n\t\t\t(font\n\t\t\t\t(size 1.27 1.27)\n\t\t\t)\n\t\t\t(justify {just})\n\t\t)\n'
                              f'\t\t(uuid "{U()}")\n\t)\n')
        else:
            self.items.append(f'\t(label "{net}"\n\t\t(at {fmt(x)} {fmt(y)} {out})\n'
                              f'\t\t(effects\n\t\t\t(font\n\t\t\t\t(size 1.27 1.27)\n\t\t\t)\n\t\t\t(justify {just} bottom)\n\t\t)\n'
                              f'\t\t(uuid "{U()}")\n\t)\n')

    def pwr(self, net, x, y, rot=0):
        """Power symbol whose pin sits at (x, y). rot 0: +5V points up, GND hangs down."""
        self.pwr_n += 1
        ref = f"#PWR{self.pwr_prefix}{self.pwr_n:03d}"
        if rot == 0:
            vxy = (x, y - 3.81) if net == "+5V" else (x, y + 3.81)
        elif rot == 180:
            vxy = (x, y + 3.81) if net == "+5V" else (x, y - 3.81)
        else:
            sgn = -1 if rot == 90 else 1
            vxy = (x + sgn * 5.08 * (1 if net == "+5V" else -1), y)
        self.place("power", net, ref, net, "", x, y, rot, val_xy=vxy, hide_val=(net == "GND" and rot in (90, 270)))

    def flag(self, x, y, rot=0):
        self.pwr_n += 1
        self.place("power", "PWR_FLAG", f"#FLG{self.pwr_prefix}{self.pwr_n:03d}", "PWR_FLAG", "", x, y, rot,
                   val_xy=(x, y - 3.81 if rot == 0 else y + 3.81))

    def text(self, txt, x, y, size=2.0, bold=True):
        txt = txt.replace('"', '\\"')
        b = "\n\t\t\t\t(bold yes)" if bold else ""
        self.items.append(f'\t(text "{txt}"\n\t\t(exclude_from_sim no)\n\t\t(at {fmt(x)} {fmt(y)} 0)\n'
                          f'\t\t(effects\n\t\t\t(font\n\t\t\t\t(size {size} {size}){b}\n\t\t\t)\n\t\t\t(justify left bottom)\n\t\t)\n'
                          f'\t\t(uuid "{U()}")\n\t)\n')

    def rect(self, x1, y1, x2, y2):
        self.items.append(f'\t(rectangle\n\t\t(start {fmt(x1)} {fmt(y1)})\n\t\t(end {fmt(x2)} {fmt(y2)})\n'
                          f'\t\t(stroke\n\t\t\t(width 0)\n\t\t\t(type dash)\n\t\t)\n\t\t(fill\n\t\t\t(type none)\n\t\t)\n'
                          f'\t\t(uuid "{U()}")\n\t)\n')

    # --- composite helpers
    def pin_net(self, tips, ref, num, net, stub=2.54):
        """Stub from a pin in its outward direction, then a label or power symbol."""
        x, y, out = tips[num]
        dx, dy = {0: (stub, 0), 180: (-stub, 0), 90: (0, -stub), 270: (0, stub)}[out]
        ex, ey = x + dx, y + dy
        if stub:
            self.wire((x, y), (ex, ey))
        if net is None:
            self.nc(x, y)
            return
        if net in POWER:
            rot = {("+5V", 90): 0, ("+5V", 270): 180, ("+5V", 180): 90, ("+5V", 0): 270,
                   ("GND", 270): 0, ("GND", 90): 180, ("GND", 180): 270, ("GND", 0): 90}[(net, out)]
            self.pwr(net, ex, ey, rot)
        else:
            self.label(net, ex, ey, out)
        self.expect(net, f"{ref}.{num}")

    def two(self, kind, ref, val, fp, x, y, horizontal=True, dnp=False, flip=False, extra=None):
        """2-pin part. Returns (left_or_top_pin_tip, right_or_bottom_pin_tip, (left_num, right_num))."""
        if kind in ("D", "DS"):
            # Device:D rot 0 = K left, A right. flip=True puts the anode on the left.
            rot = 180 if flip else 0
            t = self.place("Device", "D" if kind == "D" else "D_Schottky", ref, val, fp, x, y, rot,
                           ref_xy=(x, y - 2.54), val_xy=(x, y + 2.54), extra=extra)
            nums = ("2", "1") if flip else ("1", "2")
        else:
            libname, name = ("Device", "C_Polarized") if kind == "CP" else ("Device", "C" if kind == "C" else "R")
            if horizontal:
                t = self.place(libname, name, ref, val, fp, x, y, 90, dnp=dnp, ref_xy=(x, y - 2.54), val_xy=(x, y + 2.54), extra=extra)
            else:
                t = self.place(libname, name, ref, val, fp, x, y, 0, dnp=dnp, ref_xy=(x + 2.54, y - 1.27), val_xy=(x + 2.54, y + 1.27),
                               extra=extra, just="left")
            nums = ("1", "2")
        return t[nums[0]][:2], t[nums[1]][:2], nums

    def dpot(self, ref, unit, note, x, y):
        """One MCP4451 channel as a rheostat on row y: A left (tied to W), W middle, B right; body hangs below.
        Returns (left, right, (A, B), right_extra, left_extra)."""
        a, w, b = DPOT_PINS[unit]
        t = self.place(*DPOT_SYM, ref, DPOT_VAL, FP["TSSOP20"], x, y + 7.62, 270, unit,
                       extra={"Function": note}, ref_xy=(x - 5.715, y + 7.62), hide_val=True, just="right")
        self.wire(t[a][:2], t[w][:2])
        return t[a][:2], t[b][:2], (f"{ref}.{a}", f"{ref}.{b}"), [], [f"{ref}.{w}"]

    def dual_diode(self, ref, x, y, forward):
        """BAV99 (two diodes in series) on row y. forward=True conducts left -> right."""
        t = self.place("Diode", "BAV99", ref, "BAV99", FP["SOT23"], x, y, 0 if forward else 180,
                       ref_xy=(x, y - 2.54 if forward else y + 2.54), val_xy=(x + 5.08, y + 3.81 if forward else y - 3.81), hide_val=True)
        self.nc(*t["3"][:2])
        nums = ("1", "2") if forward else ("2", "1")
        return t[nums[0]][:2], t[nums[1]][:2], (f"{ref}.{nums[0]}", f"{ref}.{nums[1]}"), [], []

    def element(self, e, x, y):
        kind = e[0]
        if kind == "DPOT":
            _, ref, unit, note = e
            return self.dpot(ref, unit, note, x, y)
        if kind == "DD":
            _, ref, forward = e
            return self.dual_diode(ref, x, y, forward)
        _, ref, val, fp = e[:4]
        opts = e[4] if len(e) > 4 else {}
        l, r, n = self.two(kind, ref, val, fp, x, y, dnp=opts.get("dnp", False), flip=opts.get("flip", False))
        return l, r, (f"{ref}.{n[0]}", f"{ref}.{n[1]}"), [], []

    def chain(self, elems, x_left, x_right, y, left_net, right_net):
        """Series elements between two x's on row y; ends wired to x_left / x_right."""
        if not elems:
            self.wire((x_left, y), (x_right, y))
            return
        n = len(elems)
        span = x_right - x_left
        step = span / n
        prev = (x_left, y)
        prev_net = left_net
        for i, e in enumerate(elems):
            cx = round((x_left + step * (i + 0.5)) / 1.27) * 1.27
            l, r, (ln, rn), extra_nodes, left_extra = self.element(e, cx, y)
            self.wire(prev, l)
            self.expect(prev_net, ln, *left_extra)
            nxt = right_net if i == n - 1 else f"~{rn}"
            self.expect(nxt, rn, *extra_nodes)
            prev, prev_net = r, nxt
        self.wire(prev, (x_right, y))

    def chain_left_of(self, elems, x_end, y, src_net):
        """Input row ending at x_end (right side), elements right-aligned, label at the left end."""
        x = x_end - 2.54
        placed = []
        for e in reversed(elems):
            cx = x - 3.81
            placed.append((e, cx))
            x = cx - 3.81 - 2.54
        placed.reverse()
        prev = None
        prev_net = src_net
        first_left = None
        for i, (e, cx) in enumerate(placed):
            l, r, (ln, rn), extra_nodes, left_extra = self.element(e, cx, y)
            if prev is None:
                first_left = l
            else:
                self.wire(prev, l)
            self.expect(prev_net, ln, *left_extra)
            prev_net = f"~{rn}"
            self.expect(prev_net, rn, *extra_nodes)
            prev = r
        self.wire(prev, (x_end, y))
        lx = first_left[0] - 2.54
        self.wire(first_left, (lx, y))
        self.label(src_net, lx, y, 180) if src_net not in POWER else None
        return prev_net  # anon net at the right end

    def write(self, file_uuid, paper="A3", extra_tail=""):
        libs = "".join("\t\t" + v.replace("\n", "\n\t") + "\n" for k, v in sorted(self.libs.items()))
        out = (f'(kicad_sch\n\t(version 20260306)\n\t(generator "eeschema")\n\t(generator_version "10.0")\n'
               f'\t(uuid "{file_uuid}")\n\t(paper "{paper}")\n\t(title_block\n\t\t(title "{self.title}")\n\t\t(date "2026-10-20")\n'
               f'\t\t(comment 1 "Analog PID quad flight controller")\n\t)\n'
               f'\t(lib_symbols\n{libs}\t)\n' + "".join(self.items) + extra_tail + '\t(embedded_fonts no)\n)\n')
        open(os.path.join(PROJ_DIR, self.fname), "w", encoding="utf-8", newline="\n").write(out)

# ---------------------------------------------------------------- op-amp stages
OPA = ("Amplifier_Operational", "LM2902")   # base symbol; pinout = LMV324B
OPA_VAL = "LMV324B-SR"
DPOT_SYM = ("Potentiometer_Digital", "MCP4431-xxxx-ST")   # base symbol; MCP4451 = same pins, 8-bit
DPOT_VAL = "MCP4451-104E/ST"
DPOT_PINS = {1: ("11", "12", "13"), 2: ("10", "9", "8"), 3: ("20", "19", "18"), 4: ("1", "2", "3")}  # unit: (A, W, B)
UNIT_PINS = {1: ("3", "2", "1"), 2: ("5", "6", "7"), 3: ("10", "9", "8"), 4: ("12", "13", "14")}  # (+, -, out)
SW_PINS = {1: ("1", "2", "13"), 2: ("4", "3", "5"), 3: ("8", "9", "6"), 4: ("11", "10", "12")}     # CD4066 (left, right, control)

def stage(sh, X, Y, ref, unit, guide, plus, inputs, fb, out_net, tp=None, title=None, plus_row=None, out_custom=False):
    """Op-amp unit with:
       plus      : net on the + input (label) unless plus_row is given
       plus_row  : (src_net, [elems], ref_leg_elem, ref_leg_net)  -> diff-amp + side
       inputs    : [(src_net, [elems])] rows into the - node
       fb        : [[elems]] branches between - node and output
    """
    pp, pm, po = UNIT_PINS[unit]
    if title:
        sh.text(title, X - 30.48, Y - 25.4, 1.8)
    t = sh.place(*OPA, ref, OPA_VAL, FP["SOIC14"], X, Y, 0, unit, extra={"Guide_Ref": guide},
                 ref_xy=(X + 2.54, Y - 7.62), val_xy=(X + 2.54, Y - 5.08))
    P, M, O = t[pp][:2], t[pm][:2], t[po][:2]
    xL, xR = X - 10.16, X + 10.16
    N = (xL, M[1])
    nN = f"~{ref}.{pm}"
    sh.expect(nN, f"{ref}.{pm}")
    # + side
    Pn = (xL, P[1])
    sh.wire(P, Pn)
    if plus_row:
        src, elems, leg, leg_net = plus_row
        nP = f"~{ref}.{pp}"
        sh.expect(nP, f"{ref}.{pp}")
        right_anon = sh.chain_left_of(elems, xL, P[1], src)
        sh.nets[nP] |= sh.nets.pop(right_anon)
        # reference leg straight up from the + node
        _, ref_, val, fp = leg
        top, bot, nums = sh.two("R", ref_, val, fp, xL, P[1] - 7.62, horizontal=False)
        sh.wire(bot, Pn)
        sh.junc(*Pn)
        sh.expect(nP, f"{ref_}.{nums[1]}")
        sh.wire(top, (top[0], top[1] - 2.54))
        sh.label(leg_net, top[0], top[1] - 2.54, 90)
        sh.expect(leg_net, f"{ref_}.{nums[0]}")
    else:
        sh.label(plus, *Pn, 180)
        sh.expect(plus, f"{ref}.{pp}")
    # - node and output node
    sh.wire(M, N)
    On = (xR, O[1])
    sh.wire(O, On)
    if not out_custom:
        end = (X + 22.86, O[1])
        if tp:
            tpx = X + 15.24
            sh.wire(On, (tpx, O[1]), end)
            sh.junc(tpx, O[1])
            sh.place("Connector", "TestPoint", tp, out_net, FP["TP"], tpx, O[1], 0,
                     ref_xy=(tpx + 1.27, O[1] - 6.35), hide_val=True)
            sh.expect(out_net, f"{tp}.1")
        else:
            sh.wire(On, end)
        sh.label(out_net, *end, 0)
    sh.expect(out_net, f"{ref}.{po}")
    # feedback rows and input rows
    ys_fb, y, pad = [], M[1] - 7.62, 0
    for row in fb:
        y += 12.7 + pad + (7.62 if isinstance(row, dict) else 0)   # switch rows need room for their control label
        ys_fb.append(y)
        pad = 10.16 if not isinstance(row, dict) and any(e[0] == "DPOT" for e in row) else 0  # pot body hangs below its row
    # diff amps: drop the - input row below the first feedback row so it clears the + input row
    off = 2 if plus_row else 0
    ys_in = [M[1] + 12.7 * k + (5.08 + 12.7 * len(fb) - 5.08 + 7.62 if off else 0) for k in range(len(inputs))]
    for y, elems in zip(ys_fb, fb):
        if isinstance(elems, dict):
            sw_ref, sw_unit, ctrl = elems["sw"]
            l_pin, r_pin, c_pin = SW_PINS[sw_unit]
            t2 = sh.place("4xxx", "4016", sw_ref, "74HC4066D", FP["SOIC14"], X, y, 0, sw_unit,
                          ref_xy=(X - 3.81, y + 2.54), val_xy=(X + 3.81, y + 2.54), extra={"Function": "integrator reset"})
            sh.wire((xL, y), t2[l_pin][:2]); sh.wire(t2[r_pin][:2], (xR, y))
            cx, cy, _ = t2[c_pin]
            sh.label(ctrl, cx, cy, 0)
            sh.expect(nN, f"{sw_ref}.{l_pin}"); sh.expect(out_net, f"{sw_ref}.{r_pin}"); sh.expect(ctrl, f"{sw_ref}.{c_pin}")
            continue
        sh.chain(elems, xL, xR, y, nN, out_net)
    for y, (src, elems) in zip(ys_in, inputs):
        right_anon = sh.chain_left_of(elems, xL, y, src)
        sh.nets[nN] |= sh.nets.pop(right_anon)
    # rails
    left = sorted(set([N[1]] + ys_fb + ys_in))
    for a, b in zip(left, left[1:]):
        sh.wire((xL, a), (xL, b))
    for y in left:
        deg = (y != left[0]) + (y != left[-1]) + (y in ys_fb or y == N[1]) + (y in ys_in)
        if deg >= 3:
            sh.junc(xL, y)
    right = sorted(set([O[1]] + ys_fb))
    for a, b in zip(right, right[1:]):
        sh.wire((xR, a), (xR, b))
    for y in right:
        deg = (y != right[0]) + (y != right[-1]) + 1 + (y == O[1] and not out_custom)
        if deg >= 3:
            sh.junc(xR, y)
    return On


def opamp_power(sh, x, y, ref, guide, cref):
    t = sh.place(*OPA, ref, OPA_VAL, FP["SOIC14"], x, y, 0, 5, extra={"Guide_Ref": guide},
                 ref_xy=(x + 2.54, y - 1.27), val_xy=(x + 2.54, y + 1.27))
    sh.pwr("+5V", *t["4"][:2])
    sh.pwr("GND", *t["11"][:2])
    sh.expect("+5V", f"{ref}.4"); sh.expect("GND", f"{ref}.11")
    decouple(sh, x + 12.7, y, cref, "100nF X7R")


def dpot_ctrl(sh, ref, x, y, a1, a0, cref):
    """MCP4451 unit 5: supply, I2C (shim's 5 V bus), address straps, /RESET high, decoupling."""
    t = sh.place(*DPOT_SYM, ref, DPOT_VAL, FP["TSSOP20"], x, y, 0, 5,
                 ref_xy=(x + 11.43, y - 11.43), val_xy=(x + 11.43, y + 11.43), just="left")
    sh.pwr("+5V", *t["17"][:2]); sh.pwr("GND", *t["7"][:2])
    sh.expect("+5V", f"{ref}.17"); sh.expect("GND", f"{ref}.7")
    sh.pin_net(t, ref, "5", "SCL_5V")
    sh.pin_net(t, ref, "6", "SDA_5V")
    sh.pin_net(t, ref, "15", "+5V", stub=5.08)
    sh.pin_net(t, ref, "4", a0, stub=5.08)
    sh.pin_net(t, ref, "16", a1, stub=10.16)
    sh.nc(*t["14"][:2])
    decouple(sh, x + 17.78, y, cref, "100nF X7R")


def decouple(sh, x, y, cref, val, fp=None, kind="C"):
    top, bot, nums = sh.two(kind, cref, val, fp or FP["C0603"], x, y, horizontal=False)
    sh.pwr("+5V", *top)
    sh.pwr("GND", *bot)
    sh.expect("+5V", f"{cref}.1"); sh.expect("GND", f"{cref}.2")


def testpoint(sh, ref, net, x, y):
    """Test point with its own label (pin faces left)."""
    t = sh.place("Connector", "TestPoint", ref, net, FP["TP"], x, y, 270, ref_xy=(x + 3.81, y - 2.54), hide_val=True)
    sh.pin_net(t, ref, "1", net)


def jumper(sh, ref, val, x, y, n1, n2, n3, tp_ref=None):
    """3-pin loop-select header (pins on the left, labels)."""
    t = sh.place("Connector_Generic", "Conn_01x03", ref, val, FP["H3"], x, y, 0,
                 ref_xy=(x + 2.54, y - 5.08), val_xy=(x + 2.54, y + 5.08))
    for num, net in (("1", n1), ("2", n2), ("3", n3)):
        sh.pin_net(t, ref, num, net, stub=5.08)

# ---------------------------------------------------------------- PID sheets
class Refs:
    def __init__(self, n):
        self.n, self.c = n, {}
    def __call__(self, p):
        self.c[p] = self.c.get(p, 0) + 1
        return f"{p}{self.n}{self.c[p]:02d}"


def reference_sheet(sh):
    nx = Refs(1)
    sh.text("PID REFERENCE: TL431 -> buffer -> VSET divider -> three isolated virtual grounds (VG = 2.048 V)", 20.32, 22.86, 2.5)
    sh.text("Set the U103 VSET channel (I2C) until (DAC code 2048) - VGND_A < 1 mV. Never tie VGND_A/B/C together. "
            "100 ohm isolates each follower from its 470 nF rail cap.", 20.32, 29.21, 1.5, False)
    # TL431 + bias (TI SOT-23 DBZ pinout: 1 K, 2 REF, 3 A)
    x0, y0 = 50.8, 71.12
    sh.text("TL431 reference", 27.94, 45.72, 1.8)
    top, bot, nums = sh.two("R", nx("R"), "1k", FP["R"], x0, y0 - 6.35, horizontal=False)
    sh.pwr("+5V", *top); sh.expect("+5V", "R101.1")
    sh.wire(bot, (x0, y0))
    tl = sh.place("Reference_Voltage", "TL431DBZ", "U102", "TL431BIDBZR", FP["SOT23"], x0, y0 + 5.08, 90,
                  extra={"Guide_Ref": "TL431 (TI SOT-23 DBZ: 1 K, 2 REF, 3 A)"},
                  ref_xy=(x0 + 3.81, y0 + 5.08), val_xy=(x0 + 3.81, y0 + 7.62), just="left")
    K, REF, A = tl["1"][:2], tl["2"][:2], tl["3"][:2]
    sh.wire(K, (x0, y0))
    sh.wire(REF, (REF[0] - 2.54, REF[1]), (REF[0] - 2.54, y0), (x0, y0))
    sh.wire(A, (A[0], A[1] + 2.54))
    sh.pwr("GND", A[0], A[1] + 2.54)
    sh.expect("VREF_RAW", "R101.2", "U102.1", "U102.2")
    sh.expect("GND", "U102.3")
    # buffer U101A: + from VREF_RAW
    X, Y = 76.2, y0 + 2.54
    sh.wire((x0, y0), (X - 10.16, y0))
    sh.junc(x0, y0)
    # buffer U101A, drawn by hand: + input wired straight from the TL431 node
    sh.text("Buffer (U101A)", X - 10.16, Y - 25.4, 1.8)
    t = sh.place(*OPA, "U101", OPA_VAL, FP["SOIC14"], X, Y, 0, 1, extra={"Guide_Ref": "U1-A"},
                 ref_xy=(X + 2.54, Y - 7.62), val_xy=(X + 2.54, Y - 5.08))
    sh.wire((X - 10.16, y0), t["3"][:2])
    sh.expect("VREF_RAW", "U101.3")
    M, O = t["2"][:2], t["1"][:2]
    xL, xR = X - 10.16, X + 10.16
    sh.wire(M, (xL, M[1]), (xL, M[1] + 5.08), (xR, M[1] + 5.08), (xR, O[1]))
    sh.wire(O, (xR, O[1]))
    sh.junc(xR, O[1])
    tpx = X + 15.24
    sh.wire((xR, O[1]), (tpx, O[1]), (X + 22.86, O[1]))
    sh.junc(tpx, O[1])
    sh.place("Connector", "TestPoint", "TP101", "VREF_BUF", FP["TP"], tpx, O[1], 0, ref_xy=(tpx + 1.27, O[1] - 6.35), hide_val=True)
    sh.label("VREF_BUF", X + 22.86, O[1], 0)
    sh.expect("VREF_BUF", "U101.1", "U101.2", "TP101.1")
    # VSET divider: VREF_BUF - 47.5k - VSET - (U103 ch3 rheostat + 165k) - GND.
    # Code 128 (power-on) ~ 2.044 V; range 1.94..2.12 V; 0.67 mV per step.
    py = 71.12
    sh.text("VSET divider (digital trim)", 121.92, 45.72, 1.8)
    sh.wire((124.46, py), (127.0, py))
    sh.label("VREF_BUF", 124.46, py, 180)
    sh.chain([("R", "R105", "47.5k", FP["R"])], 127.0, 139.7, py, "VREF_BUF", "VSET")
    sh.wire((139.7, py), (139.7, py - 5.08))
    sh.label("VSET", 139.7, py - 5.08, 90)
    sh.chain([("DPOT", "U103", 4, "VSET trim: ch3, code 128 = 2.044 V"), ("R", "R106", "165k", FP["R"])],
             139.7, 175.26, py, "VSET", "GND")
    sh.junc(139.7, py)
    sh.pwr("GND", 175.26, py)
    testpoint(sh, "TP102", "VSET", 160.02, 55.88)
    t = sh.place("Device", "C", "C107", "100nF X7R", FP["C0603"], 167.64, 91.44, 0,
                 ref_xy=(170.18, 90.17), val_xy=(170.18, 92.71), just="left")
    sh.pin_net(t, "C107", "1", "VSET")
    sh.pin_net(t, "C107", "2", "GND", stub=0)
    # U103 control unit (I2C 0x2E); its channels 0-2 sit on the yaw sheet
    sh.text("U103 MCP4451: I2C 0x2E (A1=1, A0=0). ch0-2 = yaw P/I/D, ch3 = VSET", 121.92, 101.6, 1.5)
    dpot_ctrl(sh, "U103", 152.4, 129.54, a1="+5V", a0="GND", cref="C108")
    # three rail followers
    for i, (u, rail) in enumerate([(2, "VGND_A"), (3, "VGND_B"), (4, "VGND_C")]):
        X, Y = 213.36, 66.04 + 45.72 * i
        pp, pm, po = UNIT_PINS[u]
        sh.text(f"{rail} follower (U101{'ABCD'[u-1]})", X - 30.48, Y - 17.78, 1.8)
        t = sh.place(*OPA, "U101", OPA_VAL, FP["SOIC14"], X, Y, 0, u, extra={"Guide_Ref": f"U1-{'ABCD'[u-1]}"},
                     ref_xy=(X + 2.54, Y - 7.62), val_xy=(X + 2.54, Y - 5.08))
        P, M, O = t[pp][:2], t[pm][:2], t[po][:2]
        xL, xR = X - 10.16, X + 10.16
        sh.wire(P, (xL, P[1]))
        sh.label("VSET", xL, P[1], 180)
        sh.wire(M, (xL, M[1]), (xL, M[1] + 5.08), (xR, M[1] + 5.08), (xR, O[1]))
        sh.wire(O, (xR, O[1]))
        rref, cref, tpref = f"R1{2 + i:02d}", f"C1{1 + i:02d}", f"TP1{3 + i:02d}"
        l, r, n = sh.two("R", rref, "100", FP["R"], xR + 7.62, O[1])
        sh.wire((xR, O[1]), l)
        sh.junc(xR, O[1])
        node = (xR + 17.78, O[1])
        sh.wire(r, node)
        top, bot, nn = sh.two("C", cref, "470nF X7R", FP["C0603"], node[0], node[1] + 6.35, horizontal=False)
        sh.wire(node, top)
        sh.pwr("GND", *bot)
        tpx = node[0] + 7.62
        sh.wire(node, (tpx, node[1]), (tpx + 7.62, node[1]))
        sh.junc(*node); sh.junc(tpx, node[1])
        sh.place("Connector", "TestPoint", tpref, rail, FP["TP"], tpx, node[1], 0, ref_xy=(tpx + 1.27, node[1] - 6.35), hide_val=True)
        sh.label(rail, tpx + 7.62, node[1], 0)
        sh.expect("VSET", f"U101.{pp}")
        sh.expect(f"~{rail}_DRV", f"U101.{po}", f"U101.{pm}", f"{rref}.1")
        sh.expect(rail, f"{rref}.2", f"{cref}.1", f"{tpref}.1")
        sh.expect("GND", f"{cref}.2")
    # power + bulk
    sh.text("U101 power, 5 V bulk", 27.94, 175.26, 1.8)
    opamp_power(sh, 50.8, 198.12, "U101", "U1", "C104")
    for i, ref in enumerate(("C105", "C106")):
        decouple(sh, 101.6 + 15.24 * i, 198.12, ref, "10uF 25V", FP["C0805"])


def axis_sheet(sh, ax, n, angle_loop, stage_vg, i_res, d_in_summer, guide):
    nx = Refs(n)
    ga, gb = guide
    ua, ub = f"U{n}01", f"U{n}02"
    e = {"ROLL": "E_RR", "PITCH": "E_PR", "YAW": "E_YR"}[ax]
    sp_src = f"{ax}_RATE_SP" if angle_loop else f"{ax}_RATE_CMD"
    out = f"U_{ax}"
    sh.text(f"{ax} AXIS: rate PID" + (" + angle loop + bench plant" if angle_loop else "") +
            f"   (guide chips {ga} = {ua}, {gb} = {ub})", 20.32, 22.86, 2.5)
    sh.text("Signals are deviations from VG = 2.048 V. Every P, I and D path is inverted twice. "
            "Gains are set by MCP4451 rheostat channels (A tied to W; R_BW = code/256 x 100k).", 20.32, 29.21, 1.5, False)

    R = lambda v: ("R", nx("R"), v, FP["R"])
    C = lambda v, fp: ("C", nx("C"), v, fp)
    pref = {2: "U203", 3: "U303", 4: "U103"}[n]
    POT = lambda unit, note: ("DPOT", pref, unit, note)
    DD = lambda forward: ("DD", nx("D"), forward)
    i_note = "I: code 171 = 67k (Ki 10/s)" if i_res == "33k" else "I: code 128 = 50k"
    notes = {1: "P: code 128 = 50k (Kp 1.16)", 2: i_note, 3: "D: code 128 = 50k (Kd 9.7 ms)",
             4: "Angle P: code 64 = 25k (Go 1.75)"}

    r1 = 71.12  # row 1 op-amp y
    # 1. rate diff amp (+ side = setpoint, - side = gyro)
    stage(sh, 63.5, r1, ua, 1, f"{ga}-A", None,
          inputs=[("FB_SEL", [R("10k")])], fb=[[R("10k")]], out_net=e, tp=nx("TP"),
          title=f"1  Rate error = SP - gyro  ({ua}A)",
          plus_row=("SP_SEL", [R("10k")], R("10k"), "VGND_B"))
    # 2. P
    stage(sh, 152.4, r1, ua, 2, f"{ga}-B", stage_vg,
          inputs=[(e, [R("47k")])], fb=[[R("4.7k"), POT(1, notes[1])]], out_net="P_OUT",
          tp=nx("TP"), title=f"2  P, inverting  ({ua}B)")
    # 3. leaky I with clamp (pin 9 -> pin 8 pair, then pin 8 -> pin 9 pair)
    stage(sh, 248.92, r1, ua, 3, f"{ga}-C", stage_vg,
          inputs=[(e, [R(i_res), POT(2, notes[2])])],
          fb=[[C("1uF X7R 1206", FP["C1206"])], [R("1M")], [DD(True)], [DD(False)],
              {"sw": ("U9", {2: 1, 3: 2, 4: 3}[n], "I_HOLD")}],
          out_net="I_OUT", tp=nx("TP"), title=f"3  Leaky I + clamp + reset (U9 = 74HC4066)  ({ua}C)")
    # 4. band-limited D
    stage(sh, 345.44, r1, ua, 4, f"{ga}-D", stage_vg,
          inputs=[(e, [R("27k"), C("100nF", FP["C0805"])])],
          fb=[[R("47k"), POT(3, notes[3])], [C("10nF C0G", FP["C0603"])]],
          out_net="D_OUT", tp=nx("TP"), title=f"4  Filtered D  ({ua}D)")
    r2 = 190.5
    # 5. summer
    stage(sh, 63.5, r2, ub, 1, f"{gb}-A", stage_vg,
          inputs=[("P_OUT", [R("10k")]), ("I_OUT", [R("10k")]),
                  ("D_OUT", [("R", nx("R"), "10k" + ("" if d_in_summer else " DNP"), FP["R"], {"dnp": not d_in_summer})])],
          fb=[[R("10k")]], out_net=out, tp=nx("TP"), title=f"5  Summer -> {out}  ({ub}A)")
    if angle_loop:
        stage(sh, 152.4, r2, ub, 2, f"{gb}-B", None,
              inputs=[(f"{ax}_ANGLE_CMD", [R("10k")])], fb=[[R("10k")]], out_net="E_A", tp=nx("TP"),
              title=f"6  Angle error = meas - cmd  ({ub}B)",
              plus_row=(f"{ax}_ANGLE", [R("10k")], R("10k"), "VGND_B"))
        stage(sh, 248.92, r2, ub, 3, f"{gb}-C", "VGND_A",
              inputs=[("E_A", [R("20k")])], fb=[[R("10k"), POT(4, notes[4])]],
              out_net=sp_src, tp=nx("TP"), title=f"7  Angle P -> rate SP  ({ub}C)")
        stage(sh, 345.44, r2, ub, 4, f"{gb}-D", "VGND_C",
              inputs=[(out, [R("22k")])], fb=[[C("1uF X7R 1206", FP["C1206"])]],
              out_net="PLANT_OUT", tp=nx("TP"), title=f"8  Bench plant  ({ub}D)")
    else:
        for i, u in enumerate((2, 3, 4)):
            X = 152.4 + 64.77 * i
            pp, pm, po = UNIT_PINS[u]
            sh.text(f"Spare follower ({ub}{'ABCD'[u-1]})", X - 22.86, r2 - 25.4, 1.8)
            t = sh.place(*OPA, ub, OPA_VAL, FP["SOIC14"], X, r2, 0, u, extra={"Guide_Ref": f"{gb}-{'ABCD'[u-1]}"},
                         ref_xy=(X + 2.54, r2 - 7.62), val_xy=(X + 2.54, r2 - 5.08))
            P, M, O = t[pp][:2], t[pm][:2], t[po][:2]
            xL, xR = X - 10.16, X + 10.16
            sh.wire(P, (xL, P[1])); sh.label("VGND_C", xL, P[1], 180)
            sh.wire(M, (xL, M[1]), (xL, M[1] + 5.08), (xR, M[1] + 5.08), (xR, O[1]), O)
            sh.expect("VGND_C", f"{ub}.{pp}")
            sh.expect(f"~{ub}.{po}", f"{ub}.{po}", f"{ub}.{pm}")
    # loop-select headers and bench inputs
    sh.text("Loop select + bench inputs", 20.32, 248.92, 1.8)
    tps = [nx("TP"), nx("TP")]
    jumper(sh, nx("JP"), "LOOP_SP: 1-2 closed, 2-3 bench", 50.8, 269.24, sp_src, "SP_SEL", "EXT_SP")
    jumper(sh, nx("JP"), "LOOP_FB: 1-2 gyro, 2-3 bench", 127.0, 269.24, f"{ax}_RATE", "FB_SEL", "EXT_FB")
    testpoint(sh, tps[0], "EXT_SP", 177.8, 266.7)
    testpoint(sh, tps[1], "EXT_FB", 177.8, 276.86)
    if angle_loop:
        sh.text("Plant test: jumper PLANT_OUT -> EXT_SP (LOOP_SP 2-3) and AD3 W1 -> EXT_FB (LOOP_FB 2-3).",
                20.32, 283.21, 1.5, False)
    # power
    sh.text("Power + decoupling", 210.82, 248.92, 1.8)
    opamp_power(sh, 228.6, 271.78, ua, ga, nx("C"))
    opamp_power(sh, 266.7, 271.78, ub, gb, nx("C"))
    # digital pot: channel map (+ control unit for roll / pitch; U103's lives on the reference sheet)
    addr = {2: "0x2C (A1=0, A0=0)", 3: "0x2D (A1=0, A0=1)", 4: "0x2E (A1=1, A0=0)"}[n]
    sh.text(f"Gain pots {pref}: MCP4451-104, I2C {addr}", 284.48, 215.9, 1.8)
    lines = [f"ch{k - 1} = {notes[k]}" for k in ((1, 2, 3, 4) if angle_loop else (1, 2, 3))]
    lines += ["ch3 = VSET trim (reference sheet)"] if n == 4 else []
    lines += ["Power-on = code 128 (mid); the shim ATtiny", "writes the stored codes over I2C at boot."]
    for k, ln in enumerate(lines):
        sh.text(ln, 345.44, 223.52 + 3.81 * k, 1.3, False)
    if n in (2, 3):
        dpot_ctrl(sh, pref, 309.88, 233.68, a1="GND", a0="GND" if n == 2 else "+5V", cref=nx("C"))

# ---------------------------------------------------------------- root (shim)
def root_sheet(sh, sheet_ids):
    sh.text("DAC SHIM: ATtiny1614 reads the MPU-6050 (off-board GY-521) and writes 5x MCP4822; "
            "every DAC output is RC filtered (1k/1uF, 160 Hz) before the PID sheets", 20.32, 22.86, 2.2)

    # --- UPDI header
    sh.text("UPDI (Adafruit UPDI Friend)", 22.86, 40.64, 1.8)
    t = sh.place("Connector_Generic", "Conn_01x03", "J4", "UPDI", FP["H3"], 50.8, 55.88, 0,
                 ref_xy=(53.34, 49.53), val_xy=(53.34, 62.23))
    sh.pin_net(t, "J4", "1", "UDPI")
    sh.pin_net(t, "J4", "2", "GND", stub=2.54)
    sh.pin_net(t, "J4", "3", "+5V", stub=7.62)
    decouple(sh, 71.12, 55.88, "C3", "10uF 25V", FP["C0805"])

    # --- ELRS receiver (CRSF) + level shifter
    sh.text("Radio: ELRS receiver, CRSF 420k baud", 22.86, 76.2, 1.8)
    t = sh.place("Connector_Generic", "Conn_01x04", "J6", "ELRS_RX", FP["H4"], 45.72, 99.06, 0,
                 ref_xy=(48.26, 92.71), val_xy=(48.26, 107.95))
    sh.pin_net(t, "J6", "1", "+5V", stub=7.62)
    sh.pin_net(t, "J6", "2", "GND", stub=2.54)
    sh.pin_net(t, "J6", "3", "CRSF_3V3")
    sh.pin_net(t, "J6", "4", None, stub=0)
    sh.text("J6: 1 5V, 2 GND, 3 receiver TX, 4 receiver RX (unused)", 22.86, 113.03, 1.3, False)
    qx, qy = 66.04, 88.9
    t = sh.place("Transistor_FET", "Q_NMOS_GSD", "Q3", "BSS138", FP["SOT23"], qx, qy, 270,
                 ref_xy=(qx + 3.81, qy + 6.35), val_xy=(qx + 3.81, qy + 8.89))
    G, S, Dn = t["1"][:2], t["2"][:2], t["3"][:2]   # SOT-23: 1 G, 2 S, 3 D
    sh.wire(S, (S[0] - 5.08, S[1])); sh.label("CRSF_3V3", S[0] - 5.08, S[1], 180)
    sh.wire(G, (G[0], G[1] - 2.54)); sh.label("GATE_BIAS", G[0], G[1] - 2.54, 90)
    node = (Dn[0] + 7.62, Dn[1])
    sh.wire(Dn, node, (node[0] + 5.08, node[1])); sh.junc(*node)
    sh.label("CRSF_5V", node[0] + 5.08, node[1], 0)
    top, bot, _ = sh.two("R", "R23", "2.2k", FP["R"], node[0], node[1] - 7.62, horizontal=False)
    sh.wire(bot, node); sh.pwr("+5V", *top)
    sh.expect("CRSF_3V3", "Q3.2"); sh.expect("GATE_BIAS", "Q3.1"); sh.expect("CRSF_5V", "Q3.3", "R23.2")
    sh.expect("+5V", "R23.1")

    # --- ATtiny1614
    X, Y = 114.3, 76.2
    sh.text("MCU: ATtiny1614 (SOIC-14)", 88.9, 50.8, 1.8)
    t = sh.place("MCU_Microchip_ATtiny", "ATtiny1614-SS", "U1", "ATtiny1614-SSNR", FP["SOIC14"], X, Y, 0,
                 ref_xy=(X + 3.81, Y - 19.05), val_xy=(X + 3.81, Y + 19.05))
    for num, net in {"1": "+5V", "14": "GND", "10": "UDPI", "11": "SPI_MOSI", "13": "SPI_SCK",
                     "2": "CS_A0", "3": "CS_A1", "4": "CS_A2", "8": "SDA_5V", "9": "SCL_5V",
                     "6": "CRSF_5V", "12": "ARM", "5": "I_HOLD", "7": None}.items():
        sh.pin_net(t, "U1", num, net, stub=0 if net is None else 2.54)
    decouple(sh, X + 27.94, Y - 15.24, "C4", "100nF X7R")

    # --- 74HC138
    X, Y = 203.2, 76.2
    sh.text("DAC chip-select decoder: 74HC138 (Y0..Y4 -> DAC1..5)", 177.8, 50.8, 1.8)
    t = sh.place("74xx", "74HC138", "U2", "74HC138D", FP["SOIC16"], X, Y, 0,
                 ref_xy=(X + 3.81, Y - 17.78), val_xy=(X + 3.81, Y + 16.51))
    for num, net in {"1": "CS_A0", "2": "CS_A1", "3": "CS_A2", "16": "+5V", "8": "GND",
                     "15": "CS_DAC1", "14": "CS_DAC2", "13": "CS_DAC3", "12": "CS_DAC4", "11": "CS_DAC5",
                     "10": None, "9": None, "7": None}.items():
        sh.pin_net(t, "U2", num, net, stub=0 if net is None else 2.54)
    e0, e1, e2 = t["4"][:2], t["5"][:2], t["6"][:2]
    xa = e0[0] - 2.54
    sh.wire(e0, (xa, e0[1])); sh.wire(e1, (xa, e1[1])); sh.wire((xa, e0[1]), (xa, e1[1]))
    sh.wire((xa, e0[1]), (xa - 2.54, e0[1])); sh.junc(xa, e0[1])
    sh.pwr("GND", xa - 2.54, e0[1], 270)
    sh.wire(e2, (e2[0] - 7.62, e2[1]))
    sh.pwr("+5V", e2[0] - 7.62, e2[1], 90)
    sh.expect("GND", "U2.4", "U2.5"); sh.expect("+5V", "U2.6")
    decouple(sh, X + 27.94, Y - 15.24, "C5", "100nF X7R")

    # --- IMU pads + level shifter
    sh.text("IMU: GY-521 site at the board centre (CG); BSS138 I2C level shifter", 279.4, 40.64, 1.8)
    sh.text("SDA_5V / SCL_5V also reach the MCP4451 gain pots: U203 0x2C, U303 0x2D, U103 0x2E (IMU 0x68)", 279.4, 45.72, 1.3, False)
    t = sh.place("Connector_Generic", "Conn_01x08", "J2", "IMU_GY521", FP["H8"], 299.72, 66.04, 0,
                 ref_xy=(302.26, 55.88), val_xy=(302.26, 80.01))
    sh.pin_net(t, "J2", "1", "+5V", stub=7.62)
    sh.pin_net(t, "J2", "2", "GND", stub=2.54)
    sh.pin_net(t, "J2", "3", "SCL_3V3")
    sh.pin_net(t, "J2", "4", "SDA_3V3")
    for num in ("5", "6", "7", "8"):
        sh.pin_net(t, "J2", num, None, stub=0)
    sh.text("J2 = GY-521 header: 1 VCC, 2 GND, 3 SCL, 4 SDA; 5-8 (XDA XCL AD0 INT) mechanical only", 279.4, 86.36, 1.3, False)
    # gate bias divider: +5V - 10k - GATE_BIAS - 22k - GND  (~3.4 V, gates draw no current)
    gx = 327.66
    top, bot, _ = sh.two("R", "R2", "10k", FP["R"], gx, 55.88, horizontal=False)
    sh.pwr("+5V", *top); sh.expect("+5V", "R2.1")
    top2, bot2, _ = sh.two("R", "R4", "22k", FP["R"], gx, 71.12, horizontal=False)
    mid = (gx, round((bot[1] + top2[1]) / 2 / 1.27) * 1.27)
    sh.wire(bot, mid, top2)
    sh.pwr("GND", *bot2); sh.expect("GND", "R4.2")
    sh.wire(mid, (gx + 5.08, mid[1])); sh.junc(*mid)
    sh.label("GATE_BIAS", gx + 5.08, mid[1], 0)
    sh.expect("GATE_BIAS", "R2.2", "R4.1")
    for i, (q, pu, low, high) in enumerate([("Q1", "R1", "SDA_3V3", "SDA_5V"), ("Q2", "R3", "SCL_3V3", "SCL_5V")]):
        qx, qy = 365.76, 63.5 + 30.48 * i
        t = sh.place("Transistor_FET", "Q_NMOS_GSD", q, "BSS138", FP["SOT23"], qx, qy, 270,
                     ref_xy=(qx + 3.81, qy + 6.35), val_xy=(qx + 3.81, qy + 8.89))
        G, S, Dn = t["1"][:2], t["2"][:2], t["3"][:2]   # SOT-23: 1 G, 2 S, 3 D
        sh.wire(S, (S[0] - 5.08, S[1])); sh.label(low, S[0] - 5.08, S[1], 180)
        sh.wire(G, (G[0], G[1] - 2.54)); sh.label("GATE_BIAS", G[0], G[1] - 2.54, 90)
        node = (Dn[0] + 7.62, Dn[1])
        sh.wire(Dn, node, (node[0] + 7.62, node[1])); sh.junc(*node)
        sh.label(high, node[0] + 7.62, node[1], 0)
        top, bot, _ = sh.two("R", pu, "4.7k", FP["R"], node[0], node[1] - 7.62, horizontal=False)
        sh.wire(bot, node); sh.pwr("+5V", *top)
        sh.expect(low, f"{q}.2"); sh.expect("GATE_BIAS", f"{q}.1"); sh.expect(high, f"{q}.3", f"{pu}.2")
        sh.expect("+5V", f"{pu}.1")

    # --- DAC blocks
    dac_map = [("U4", "CS_DAC1", "ROLL_ANGLE", "ROLL_RATE"),
               ("U5", "CS_DAC2", "PITCH_ANGLE", "PITCH_RATE"),
               ("U6", "CS_DAC3", "YAW_RATE", "YAW_RATE_CMD"),
               ("U7", "CS_DAC4", "ROLL_ANGLE_CMD", "PITCH_ANGLE_CMD"),
               ("U8", "CS_DAC5", "THROTTLE", "DAC_SPARE")]
    sh.text("DACs: MCP4822 (SOIC-8), SPI shared, CS from the decoder; outputs are 1k/1uF RC filtered", 22.86, 124.46, 1.8)
    for i, (u, cs, va, vb) in enumerate(dac_map):
        X, Y = 50.8 + 76.2 * i, 160.02
        sh.text(f"DAC{i + 1} ({u})", X - 12.7, Y - 30.48, 1.6)
        t = sh.place("Analog_DAC", "MCP4822", u, "MCP4822-E/SN", FP["SOIC8"], X, Y, 0,
                     ref_xy=(X + 6.35, Y - 12.7), val_xy=(X + 6.35, Y + 13.97))
        for num, net in {"1": "+5V", "7": "GND", "3": "SPI_SCK", "4": "SPI_MOSI", "2": cs, "5": "GND"}.items():
            sh.pin_net(t, u, num, net)
        decouple(sh, X - 10.16, Y - 21.59, f"C{6 + i}", "100nF X7R")
        rA, rB, cA, cB = f"R{5 + 2 * i}", f"R{6 + 2 * i}", f"C{15 + 2 * i}", f"C{16 + 2 * i}"
        # VA: straight out
        pa = t["8"][:2]
        l, r, _ = sh.two("R", rA, "1k", FP["R"], pa[0] + 6.35, pa[1])
        sh.wire(pa, l)
        node = (r[0] + 3.81, pa[1])
        sh.wire(r, node, (node[0] + 5.08, node[1])); sh.junc(*node)
        top, bot, _ = sh.two("C", cA, "1uF", FP["C0603"], node[0], node[1] + 3.81, horizontal=False)
        sh.pwr("GND", *bot)
        sh.label(va, node[0] + 5.08, node[1], 0)
        sh.expect(f"~{u}.8", f"{u}.8", f"{rA}.1"); sh.expect(va, f"{rA}.2", f"{cA}.1"); sh.expect("GND", f"{cA}.2")
        # VB: down, then out
        pb = t["6"][:2]
        y2 = pb[1] + 12.7
        sh.wire(pb, (pb[0] + 2.54, pb[1]), (pb[0] + 2.54, y2))
        l, r, _ = sh.two("R", rB, "1k", FP["R"], pb[0] + 6.35, y2)
        sh.wire((pb[0] + 2.54, y2), l)
        node = (r[0] + 3.81, y2)
        sh.wire(r, node, (node[0] + 5.08, node[1])); sh.junc(*node)
        top, bot, _ = sh.two("C", cB, "1uF", FP["C0603"], node[0], node[1] + 3.81, horizontal=False)
        sh.pwr("GND", *bot)
        sh.label(vb, node[0] + 5.08, node[1], 0)
        sh.expect(f"~{u}.6", f"{u}.6", f"{rB}.1"); sh.expect(vb, f"{rB}.2", f"{cB}.1"); sh.expect("GND", f"{cB}.2")

    # --- mixer header
    sh.text("Axis monitor / scope header (relative to VGND_A)", 22.86, 213.36, 1.8)
    t = sh.place("Connector_Generic", "Conn_01x07", "J1", "Axis_Mon", FP["H7"], 68.58, 238.76, 0,
                 ref_xy=(71.12, 228.6), val_xy=(71.12, 248.92))
    for num, net in {"1": "U_ROLL", "2": "U_PITCH", "3": "U_YAW", "4": "THROTTLE", "5": "DAC_SPARE",
                     "6": "VGND_A", "7": "GND"}.items():
        sh.pin_net(t, "J1", num, net)

    # --- mounting holes (board corners, M3)
    sh.text("M3 holes: H1-H4 corners, H5-H8 20x20 ESC stack", 342.9, 213.36, 1.5)
    for i in range(8):
        hx, hy = 355.6 + 12.7 * (i % 4), 228.6 + 12.7 * (i // 4)
        sh.place("Mechanical", "MountingHole", f"H{i + 1}", "MountingHole", FP["HOLE"],
                 hx, hy, ref_xy=(hx, hy - 3.81), val_xy=(hx, hy + 5.08), hide_val=True)

    # --- PID sheet symbols
    sh.text("Sub-sheets: analog PID + control I/O", 147.32, 213.36, 1.8)
    for i, (name, fname, page) in enumerate(SHEETS):
        x, y = 147.32 + 38.1 * i, 228.6
        sh.items.append(
            f'\t(sheet\n\t\t(at {fmt(x)} {fmt(y)})\n\t\t(size 33.02 15.24)\n\t\t(exclude_from_sim no)\n\t\t(in_bom yes)\n'
            f'\t\t(on_board yes)\n\t\t(dnp no)\n\t\t(stroke\n\t\t\t(width 0.1)\n\t\t\t(type solid)\n\t\t)\n'
            f'\t\t(fill\n\t\t\t(color 0 0 0 0)\n\t\t)\n\t\t(uuid "{sheet_ids[name]}")\n'
            f'\t\t(property "Sheetname" "{name}"\n\t\t\t(at {fmt(x)} {fmt(y - 0.77)} 0)\n\t\t\t(effects\n\t\t\t\t(font\n\t\t\t\t\t(size 1.27 1.27)\n\t\t\t\t)\n\t\t\t\t(justify left bottom)\n\t\t\t)\n\t\t)\n'
            f'\t\t(property "Sheetfile" "{fname}"\n\t\t\t(at {fmt(x)} {fmt(y + 15.85)} 0)\n\t\t\t(effects\n\t\t\t\t(font\n\t\t\t\t\t(size 1.27 1.27)\n\t\t\t\t)\n\t\t\t\t(justify left top)\n\t\t\t)\n\t\t)\n'
            f'\t\t(instances\n\t\t\t(project "{PROJECT}"\n\t\t\t\t(path "/{ROOT_UUID}"\n\t\t\t\t\t(page "{page}")\n\t\t\t\t)\n\t\t\t)\n\t\t)\n\t)\n')

SHEETS = [("PID_Reference", "pid_reference.kicad_sch", 2), ("PID_Roll", "pid_roll.kicad_sch", 3),
          ("PID_Pitch", "pid_pitch.kicad_sch", 4), ("PID_Yaw", "pid_yaw.kicad_sch", 5),
          ("Control_IO", "control_io.kicad_sch", 6)]


def flag_on(sh, net, x, y):
    """Power symbol + PWR_FLAG joined by a short wire."""
    sh.pwr(net, x, y)
    sh.wire((x, y), (x + 5.08, y))
    sh.flag(x + 5.08, y, 0 if net == "+5V" else 180)


def control_sheet(sh):
    sh.text("CONTROL I/O: ESC harness + power, mixer/ESC-driver ATtiny, integrator-reset switch", 20.32, 22.86, 2.5)
    sh.text("Shim ATtiny (root) parses CRSF, drives ARM and I_HOLD. This ATtiny reads the PID outputs, mixes "
            "quad-X and drives the 4 ESC inputs.", 20.32, 29.21, 1.5, False)

    # --- ESC harness
    sh.text("ESC: Aero Selfie 4in1 30A, 8-pin harness (cut one end, solder here)", 20.32, 43.18, 1.8)
    t = sh.place("Connector_Generic", "Conn_01x08", "J5", "ESC_4in1", FP["H8"], 55.88, 63.5, 0,
                 ref_xy=(58.42, 53.34), val_xy=(58.42, 77.47))
    sh.pin_net(t, "J5", "1", "GND", stub=2.54)
    sh.pin_net(t, "J5", "2", "VBAT")
    for i in range(4):
        sh.pin_net(t, "J5", str(3 + i), f"M{i + 1}_ESC")
    sh.pin_net(t, "J5", "7", None, stub=0)
    sh.pin_net(t, "J5", "8", None, stub=0)
    sh.text("J5 order per ESC leaflet: 1 BAT-, 2 BAT+, 3-6 motor 1-4 signal, 7 no output, 8 current ADC. "
            "Check pin 1 = ESC minus pad with a DMM.", 20.32, 83.82, 1.3, False)

    # --- power
    sh.text("Power: VBAT (2S-4S via ESC harness) -> SS14 -> TPS54202 buck (500 kHz) -> +5V", 20.32, 99.06, 1.8)
    y = 114.3
    l, r, n = sh.two("DS", "D1", "SS14", FP["SMA"], 40.64, y, flip=True)
    sh.wire((l[0] - 5.08, y), l)
    sh.label("VBAT", l[0] - 5.08, y, 180)
    sh.expect("VBAT", "D1.2"); sh.expect("VIN_PROT", "D1.1")
    # input caps on the VIN_PROT rail: 47 uF bulk (damps the harness), 10 uF + 100 nF at the IC
    xs = (53.34, 68.58, 83.82)
    sh.wire(r, (xs[0], y))
    for x, (cref, kind, val, fp) in zip(xs, [("C25", "CP", "47uF 35V", FP["ELEC"]), ("C29", "C", "10uF 25V", FP["C0805"]),
                                              ("C30", "C", "100nF X7R", FP["C0603"])]):
        top, bot, _ = sh.two(kind, cref, val, fp, x, y + 3.81, horizontal=False)
        sh.pwr("GND", *bot)
        sh.junc(x, y)
        sh.expect("VIN_PROT", f"{cref}.1"); sh.expect("GND", f"{cref}.2")
    sh.flag(xs[0], y)
    X, Y = 111.76, y + 2.54
    t = sh.place("Regulator_Switching", "TPS54302", "U10", "TPS54202DDCR", FP["SOT23_6"], X, Y, 0,
                 ref_xy=(X - 2.54, Y - 6.35), val_xy=(X + 2.54, Y + 10.16))
    sh.wire((xs[0], y), (xs[1], y), (xs[2], y), t["3"][:2])   # VIN
    sh.expect("VIN_PROT", "U10.3")
    sh.nc(*t["5"][:2])                               # EN floats = enabled (internal pull-up)
    sh.pin_net(t, "U10", "1", "GND", stub=0)
    sh.pin_net(t, "U10", "6", "BST")
    sh.pin_net(t, "U10", "2", "SW_NODE")
    sh.pin_net(t, "U10", "4", "FB")
    # boot cap, inductor, output caps
    y2 = 152.4
    l, r, _ = sh.two("C", "C31", "100nF X7R", FP["C0603"], 45.72, 142.24)
    sh.wire(l, (l[0] - 2.54, l[1])); sh.label("BST", l[0] - 2.54, l[1], 180)
    sh.wire(r, (r[0] + 2.54, r[1])); sh.label("SW_NODE", r[0] + 2.54, r[1], 0)
    sh.expect("BST", "C31.1"); sh.expect("SW_NODE", "C31.2")
    cx = 71.12
    t = sh.place("Device", "L", "L1", "15uH FNR4030S", FP["L4030"], cx, y2, 90, ref_xy=(cx, y2 - 2.54), val_xy=(cx, y2 + 2.54))
    sh.wire(t["1"][:2], (t["1"][0] - 2.54, y2)); sh.label("SW_NODE", t["1"][0] - 2.54, y2, 180)
    sh.expect("SW_NODE", "L1.1")
    node = (83.82, y2)
    sh.wire(t["2"][:2], node, (99.06, y2))
    sh.pwr("+5V", *node)
    sh.junc(*node)
    sh.expect("+5V", "L1.2")
    for x, cref in ((node[0], "C26"), (99.06, "C32")):
        top, bot, _ = sh.two("C", cref, "22uF 10V", FP["C0805"], x, y2 + 3.81, horizontal=False)
        sh.pwr("GND", *bot)
        sh.expect("+5V", f"{cref}.1"); sh.expect("GND", f"{cref}.2")
    # feedback divider: 0.596 V x (1 + 75k/10k) = 5.07 V
    fx = 121.92
    top, bot, _ = sh.two("R", "R24", "75k", FP["R"], fx, 147.32, horizontal=False)
    sh.pwr("+5V", *top)
    fb = (fx, 153.67)
    sh.wire(bot, fb)
    top2, bot2, _ = sh.two("R", "R25", "10k", FP["R"], fx, 157.48, horizontal=False)
    sh.wire(fb, top2); sh.pwr("GND", *bot2)
    sh.wire(fb, (fx + 7.62, fb[1])); sh.junc(*fb); sh.label("FB", fx + 7.62, fb[1], 0)
    sh.expect("+5V", "R24.1"); sh.expect("FB", "R24.2", "R25.1"); sh.expect("GND", "R25.2")
    sh.text("TPS54202: 4.5-28 V in, 2 A, Eco-mode at light load. Keep SW_NODE copper small and away from",
            20.32, 172.72, 1.3, False)
    sh.text("the PID sheets; C29/C30 and the GND pin within 2 mm of U10.", 20.32, 176.53, 1.3, False)
    flag_on(sh, "+5V", 40.64, 190.5)
    flag_on(sh, "GND", 40.64, 198.12)

    # --- mixer / ESC driver
    sh.text("Mixer + ESC driver: ATtiny1614 #2 (ADC in, 4x PWM / OneShot / DShot out)", 152.4, 43.18, 1.8)
    X, Y = 203.2, 76.2
    t = sh.place("MCU_Microchip_ATtiny", "ATtiny1614-SS", "U3", "ATtiny1614-SSNR", FP["SOIC14"], X, Y, 0,
                 ref_xy=(X + 3.81, Y - 19.05), val_xy=(X + 3.81, Y + 19.05))
    for num, net in {"1": "+5V", "14": "GND", "10": "UDPI2", "11": "U_ROLL", "12": "U_PITCH", "13": "U_YAW",
                     "4": "THROTTLE", "5": "VGND_A", "9": "M1_PWM", "8": "M2_PWM", "7": "M3_PWM",
                     "2": "M4_PWM", "3": None, "6": "ARM"}.items():
        sh.pin_net(t, "U3", num, net, stub=0 if net is None else 2.54)
    decouple(sh, X + 27.94, Y - 15.24, "C27", "100nF X7R")
    t = sh.place("Connector_Generic", "Conn_01x03", "J7", "UPDI2", FP["H3"], 266.7, 66.04, 0,
                 ref_xy=(269.24, 59.69), val_xy=(269.24, 72.39))
    sh.pin_net(t, "J7", "1", "UDPI2")
    sh.pin_net(t, "J7", "2", "GND", stub=2.54)
    sh.pin_net(t, "J7", "3", "+5V", stub=7.62)

    # --- ESC signal level dividers
    sh.text("ESC signal: 1k / 2.2k divider -> 3.4 V high (ESC MCU may not be 5 V tolerant)", 152.4, 109.22, 1.8)
    for i in range(4):
        yy = 124.46 + 15.24 * i
        rs, rp = f"R{15 + 2 * i}", f"R{16 + 2 * i}"
        l, r, _ = sh.two("R", rs, "1k", FP["R"], 172.72, yy)
        sh.wire((l[0] - 5.08, yy), l)
        sh.label(f"M{i + 1}_PWM", l[0] - 5.08, yy, 180)
        node = (r[0] + 6.35, yy)
        sh.wire(r, node, (node[0] + 7.62, yy))
        sh.junc(*node)
        top, bot, _ = sh.two("R", rp, "2.2k", FP["R"], node[0], yy + 6.35, horizontal=False)
        sh.wire(node, top)
        sh.pwr("GND", *bot)
        sh.label(f"M{i + 1}_ESC", node[0] + 7.62, yy, 0)
        sh.expect(f"M{i + 1}_PWM", f"{rs}.1"); sh.expect(f"M{i + 1}_ESC", f"{rs}.2", f"{rp}.1")
        sh.expect("GND", f"{rp}.2")

    # --- CD4066: spare unit + power
    sh.text("Integrator reset (U9 74HC4066): units A-C sit across each axis' 1 uF; unit D spare", 264.16, 119.38, 1.5)
    t = sh.place("4xxx", "4016", "U9", "74HC4066D", FP["SOIC14"], 279.4, 137.16, 0, 4,
                 ref_xy=(275.59, 139.7), val_xy=(283.21, 139.7))
    sh.nc(*t["11"][:2]); sh.nc(*t["10"][:2])
    sh.pin_net(t, "U9", "12", "GND", stub=2.54)
    t = sh.place("4xxx", "4016", "U9", "74HC4066D", FP["SOIC14"], 322.58, 137.16, 0, 5,
                 ref_xy=(325.12, 135.89), val_xy=(325.12, 138.43))
    sh.pwr("+5V", *t["14"][:2]); sh.pwr("GND", *t["7"][:2])
    sh.expect("+5V", "U9.14"); sh.expect("GND", "U9.7")
    decouple(sh, 340.36, 137.16, "C28", "100nF X7R")

    sh.text("Firmware notes: ESC idle/arm pulse 800-1050 us, run 1050-2000 us (ESC leaflet). Disarmed: hold all "
            "outputs at 1000 us and I_HOLD high.", 20.32, 210.82, 1.5, False)


# ---------------------------------------------------------------- main
def main():
    sheet_ids = {}
    for name, fname, _ in SHEETS:
        m = re.search(rf'\(uuid "([^"]+)"\)\s*\(property "Sheetname" "{name}"', ROOT_TEXT)
        sheet_ids[name] = m.group(1) if m else U()
        path = os.path.join(PROJ_DIR, fname)
        if not os.path.exists(path):
            open(path, "w", encoding="utf-8", newline="\n").write(
                f'(kicad_sch\n\t(version 20260306)\n\t(generator "eeschema")\n\t(uuid "{U()}")\n)\n')

    def file_uuid(fname):
        return re.search(r'\(uuid "([^"]+)"\)', open(os.path.join(PROJ_DIR, fname), encoding="utf-8").read()).group(1)

    expected = {}
    def collect(sh, sheetname):
        for net, nodes in sh.nets.items():
            if net.startswith("~"):
                key = f"{sheetname}{net}"
            elif net in GLOBAL or net in POWER:
                key = net
            else:
                key = f"/{sheetname}/{net}" if sheetname else f"/{net}"
            expected.setdefault(key, set()).update(nodes)

    root = Sheet("PID_Board_SMT.kicad_sch", "Quad flight controller (SMT): DAC shim + analog PID", f"/{ROOT_UUID}", "0")
    root_sheet(root, sheet_ids)
    root.write(ROOT_UUID, extra_tail='\t(sheet_instances\n\t\t(path "/"\n\t\t\t(page "1")\n\t\t)\n\t)\n')
    collect(root, "")

    builds = [
        ("PID_Reference", "pid_reference.kicad_sch", "PID reference + virtual grounds", "1", lambda s: reference_sheet(s)),
        ("PID_Roll", "pid_roll.kicad_sch", "Roll axis PID", "2", lambda s: axis_sheet(s, "ROLL", 2, True, "VGND_A", "33k", True, ("U2", "U3"))),
        ("PID_Pitch", "pid_pitch.kicad_sch", "Pitch axis PID", "3", lambda s: axis_sheet(s, "PITCH", 3, True, "VGND_A", "33k", True, ("U4", "U5"))),
        ("PID_Yaw", "pid_yaw.kicad_sch", "Yaw axis PID", "4", lambda s: axis_sheet(s, "YAW", 4, False, "VGND_B", "15k", False, ("U6", "U7"))),
        ("Control_IO", "control_io.kicad_sch", "Control I/O: ESC, power, mixer", "5", lambda s: control_sheet(s)),
    ]
    for name, fname, title, pfx, fn in builds:
        sh = Sheet(fname, title, f"/{ROOT_UUID}/{sheet_ids[name]}", pfx)
        fn(sh)
        sh.write(file_uuid(fname))
        collect(sh, name)

    pro_path = os.path.join(PROJ_DIR, "PID_Board_SMT.kicad_pro")
    pro = json.load(open(pro_path, encoding="utf-8"))
    pro["sheets"] = [[ROOT_UUID, "Root"]] + [[sheet_ids[n], n] for n, _, _ in SHEETS]
    pro["meta"]["filename"] = "PID_Board_SMT.kicad_pro"
    pro["schematic"]["top_level_sheets"] = [{"filename": "PID_Board_SMT.kicad_sch", "name": "PID_Board_SMT", "uuid": ROOT_UUID}]
    pro["board"]["design_settings"]["rules"]["min_resolved_spokes"] = 1
    json.dump(pro, open(pro_path, "w", encoding="utf-8"), indent=2)
    json.dump({k: sorted(v) for k, v in expected.items()}, open(EXPECT_OUT, "w"), indent=1)
    print("generated; expected nets:", len(expected))

main()
