AaronDoubert/quadcopter-pid-boards/(commit log)

2026-10-22 Add PID boards (THT + SMT), renders, BOMs, Gerbers, sim
    [PID_Board-B_Cu.gbl, PID_Board-B_Mask.gbs, PID_Board-B_Silkscreen.gbo, PID_Board-Edge_Cuts.gm1, PID_Board-F_Cu.gtl, PID_Board-F_Mask.gts, PID_Board-F_Paste.gtp, PID_Board-F_Silkscreen.gto]
2026-10-25 PID_Board THT: add ARM/I_HOLD pulldowns, silk cleanup, JLC/PCBWay fab export
    - R24/R25 10k pulldowns on ARM and I_HOLD
    - Silkscreen cleanup, board title, JLCJLCJLCJLC marker on back
    - Fab export in fab/JLC_PCBWay_THT (gerbers, drill, BOM, CPL for U1/U3)
    - KNOWN_ISSUES.md: 2N7000 level shifters (Q1-Q3) are marginal at ~3.4 V gate
    bias (max Vgs(th) 3 V); fallback is ZVN3306A in the same footprint
    [PID_Board-BOM_by_ref.csv, PID_Board-BOM_grouped.csv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]
2026-10-26 PID_Board rev B: frame-mount layout (90x210 mm, 4-layer)
    - Reshaped from 250x100 to 90x210 mm to fit the 5" frame: 30.5 stack and
    20x20 ESC stack holes with 3.4 mm copper-free standoff rings; tall parts
    kept out of the prop disks; GY-521 on J2 with the MPU-6050 over the CG
    - Floorplan in bands (shim, roll, GY-521 + REF, pitch, yaw + control I/O +
    power over the ESC) with labelled per-axis tuning panels
    - 4 layers: In1 GND plane, In2 +5V plane; routed with FreeRouting 2.5 plus
    a grid router for the last connections; DRC 0 errors, schematic parity clean
    - Resistors moved to 7.62 mm pitch (still horizontal); ELRS header J6 moved
    to the front edge next to the shim MCU
    - MOUNTING.md + m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
    [PID_Board-BOM_by_ref.csv, PID_Board-BOM_grouped.csv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]
2026-10-26 Add STEP models (THT v1-v3, SMT); ignore kicad-layer snapshots
    - PID_Board/cad: v1 (ddb5335), v2 (6a07de3), v3 rev B frame-mount (227d3a7)
    - PID_Board_SMT/cad: PID_Board_SMT.step
    - .gitignore: .kicad-layer/ (KiCad MCP snapshot folder)
    [PID_Board_SMT.step, PID_Board_v1_Oct20_ddb5335.step, PID_Board_v2_Oct25_6a07de3.step, PID_Board_v3_Oct25_227d3a7.step]
2026-10-26 Archive old THT revisions, add CHANGELOG, feature rev B in README
    - PID_Board/old_versions/: v1 (Oct 20) and rev A (Oct 25) 250x100 boards with
    their board files, renders, Gerbers, BOMs and STEP models
    - CHANGELOG.md with the history of every board version
    - README leads with the compact rev B frame-mount board: 3D render,
    mounting plan, specs and links to order files
    - PID_Board/pcb_3d_render.png
    [PID_Board-B_Cu.gbl, PID_Board-B_Mask.gbs, PID_Board-B_Silkscreen.gbo, PID_Board-Edge_Cuts.gm1, PID_Board-F_Cu.gtl, PID_Board-F_Mask.gts, PID_Board-F_Paste.gtp, PID_Board-F_Silkscreen.gto]
2026-10-26 U10: use cheap fixed-5V mini buck module wired to the existing header
    - Value/BOM: 5V buck module (Teyleten 3A Mini DCDC Buck, 5.5-30V in, Amazon B0DKTMGBHL)
    - MOUNTING.md: wiring IN+ -> pin 2, IN- -> pin 3, OUT+ -> pin 4; no copper change
    - KNOWN_ISSUES: power section is 2S-4S; for 6S C25 needs a 35 V+ rating
    - CHANGELOG rev B.1
    [PID_Board-BOM_grouped.csv, PID_Board.kicad_pcb, control_io.kicad_sch]
2026-11-01 sim: PID board spec/params, 5in quad plant params, controller interface bus
    pid_board_params.m (struct pcb) and pid_board_spec.md extracted from the
    rev B KiCad schematics; quad_params.m (struct quad) for 2207 1800KV,
    5x4.3x3, 4S, 650 g with sources; quad_ctrl_buses.m defines CtrlIn, the
    contract every controller variant implements.
2026-11-01 sim: Model 1 - 5in quad plant (quad_sim) + ideal 5-loop controller
    Fixed-step 6-DOF plant with ESC, electrical motor/prop, battery sag,
    IMU model and ground contact; controller slot with ideal/board variants
    honouring CtrlIn -> esc_us. ctrl_ideal mirrors the board's loop shape.
    Tuned gains (PM >= 45 deg, GM >= 8 dB), scenario runner and results.
2026-11-01 sim/docs: Model 1 diagram screenshots, flight GIF generator and roll/yaw GIFs
2026-11-01 sim/gains: conservative first-flight trimpot settings + mixer scales
    Searched in board units (per-axis Kmix, RV_P/I/D/A within 10-90 % travel)
    for PM >= 55 deg / GM >= 10 dB, still >= 35 deg / 6 dB with inertia
    x0.7/x1.7 and +2 ms delay. Verified in quad_sim: no overshoot, ~0.43 s
    settling. robustness_sweep now accepts a gain struct.
2026-11-01 sim/pid_board: Simscape Electrical circuit model of the analog section
    pid_analog_circuit.slx: TL431 reference, DAC RC filters, angle stages and
    rate cells per schematic sheet with MCP6004 (band-limited, rail-limited),
    1N4148 clamps, CD4066 reset, pots/jumpers from pcb. Matches analytic TFs
    within ~1-2 % at 20 us; runs in the 0.5 ms ode4 parent (accurate to ~50 Hz).
2026-11-01 sim/docs: circuit-model screenshots
2026-11-01 sim/pid_board: Model 2 fast board twin (shim, analog, control_io) + bench
    pid_board.slx honours CtrlIn -> esc_us, fixed-step 0.5 ms, model argument
    board_variant (1 fast, 2 circuit behind pcb.circuit_enable). Fast analog
    section matches the spec formulas (42 checks), rails/clamp/I_HOLD/disarm
    validated. Bench harness for test-point comparison, pot<->gain mapping.
    quad_sim controller slot now references pid_board. Complementary filter
    alpha set to 0.99995 (0.98 diverges in flight: accel sees thrust).
2026-11-01 sim: include the 0.909 gyro-leg gain in gain<->pot mapping, refine first-flight set
    first_flight_gains and ctrl_ideal_to_board now apply g_fb (1k DAC filter in
    the diff-amp FB leg). Added an integrator-zero constraint (Ki/Kp <= wc/2)
    so yaw sits mid-travel. Verified with the board twin (fast and circuit)
    flying quad_sim. pid_analog_circuit FixedStep = pcb.sim_dt so it nests in
    the 0.5 ms parent; run_quad_scenarios tolerates unlogged variant signals.
2026-11-01 docs: simulation overview, board-twin screenshots and flight GIFs
    sim/README.md: both models, results table (ideal vs board fast vs circuit),
    screenshots, quick start, layout, known gaps (firmware assumptions, angle
    estimator). Top-level README and CHANGELOG get a simulation section.
